skyellen/robwork-mirror/doc/gfx/overview-640.jpg

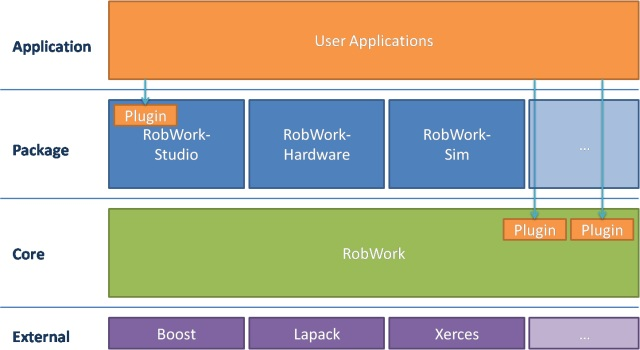
doc/gfx/overview-640.jpg
