skyellen/robwork-mirror/doc/installstuff/RW_package-msvc2005/setup.png

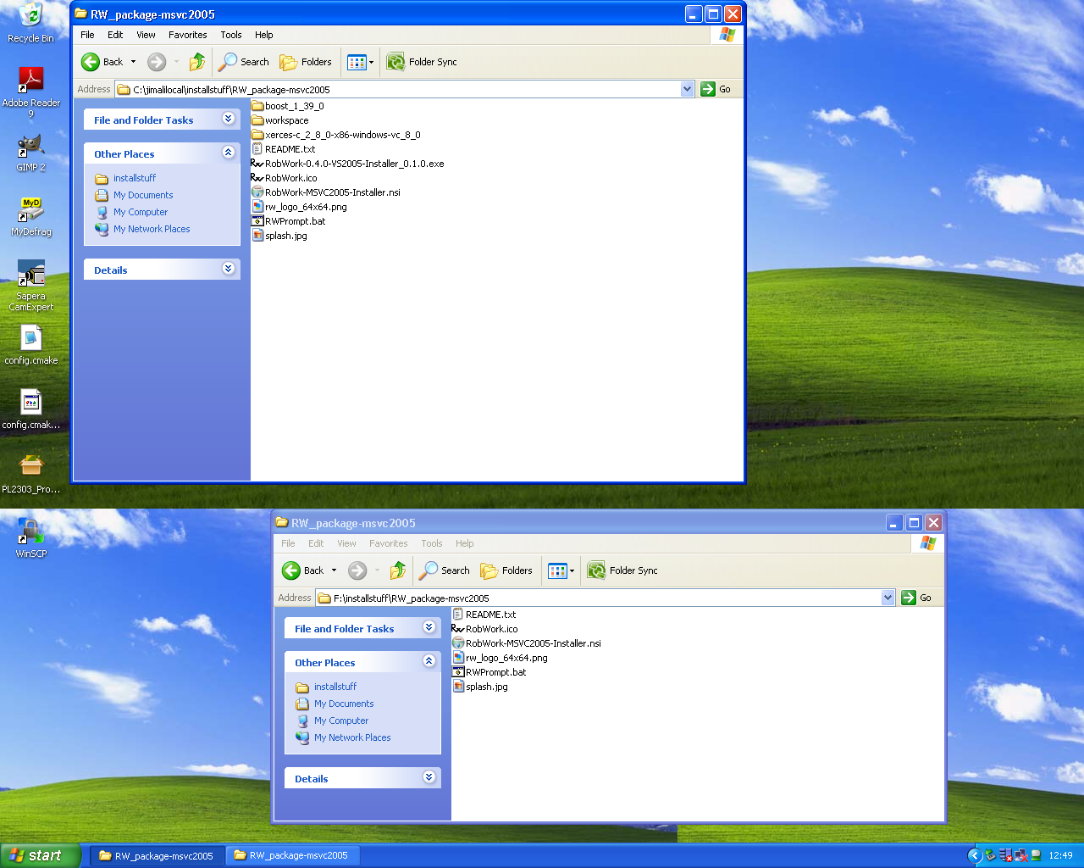
doc/installstuff/RW_package-msvc2005/setup.png
