skyellen/robwork-mirror/RobWorkSim/src/sandbox/grippers/readme.txt

Author: Adam Wolniakowski

Plugin for automatic gripper design and evaluation.
