skyellen/robwork-mirror/doc/gfx/geometric-primitives.png

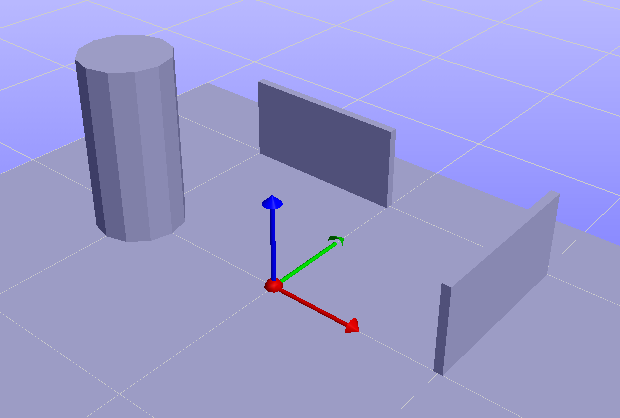
doc/gfx/geometric-primitives.png
