skyellen/robwork-mirror/doc/gfx/geometry/hypersphere.gif

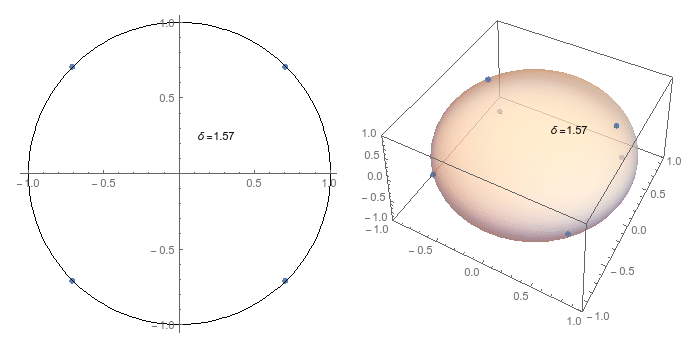
doc/gfx/geometry/hypersphere.gif
