skyellen/robwork-mirror/doc/gfx/geometry/quadrics_circular_cone.gif

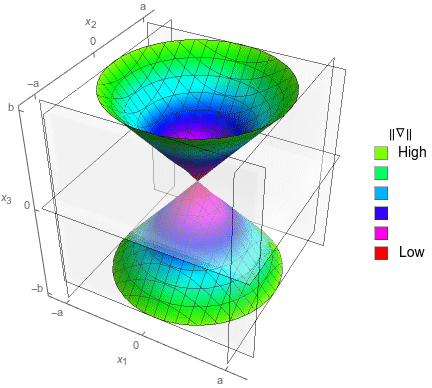
doc/gfx/geometry/quadrics_circular_cone.gif
