skyellen/robwork-mirror/doc/gfx/geometry/quadrics_circular_cylinder.gif

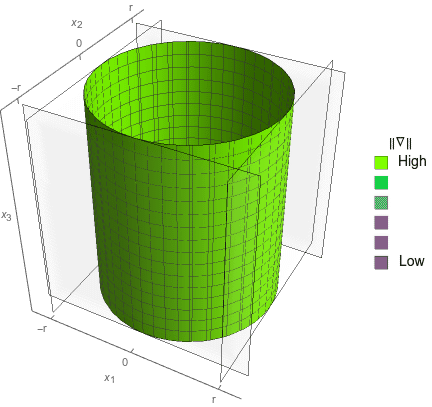
doc/gfx/geometry/quadrics_circular_cylinder.gif
