skyellen/robwork-mirror/doc/gfx/geometry/quadrics_circular_hyperboloid_onesheet.gif

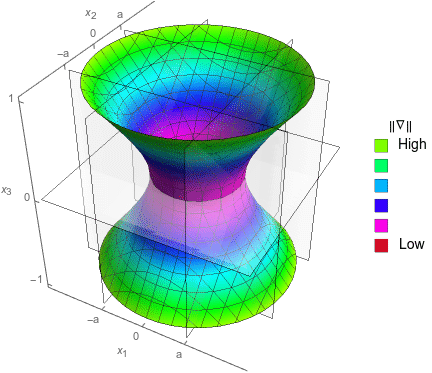
doc/gfx/geometry/quadrics_circular_hyperboloid_onesheet.gif
