skyellen/robwork-mirror/doc/gfx/geometry/quadrics_circular_hyperboloid_twosheets.gif

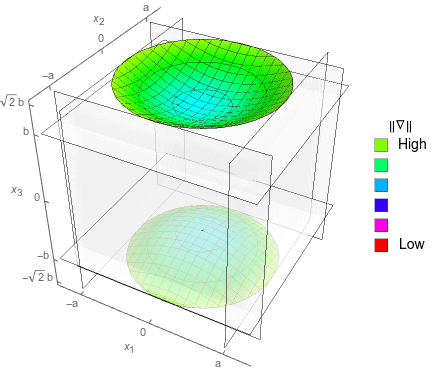
doc/gfx/geometry/quadrics_circular_hyperboloid_twosheets.gif
