skyellen/robwork-mirror/doc/gfx/geometry/quadrics_circular_paraboloid.gif

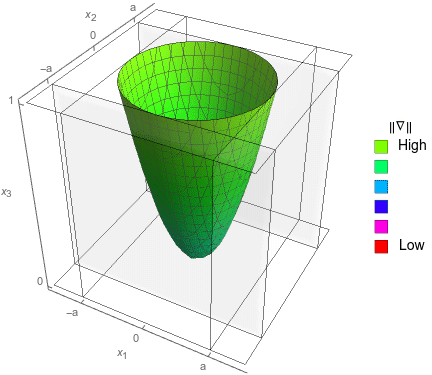
doc/gfx/geometry/quadrics_circular_paraboloid.gif
