skyellen/robwork-mirror/doc/gfx/geometry/quadrics_ellipsoid.gif

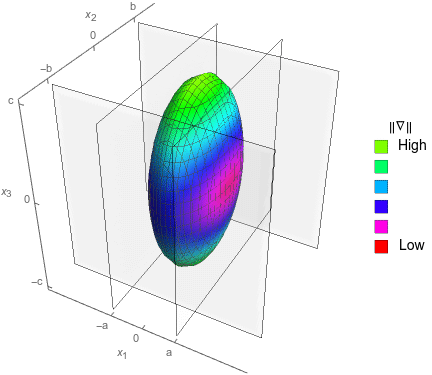
doc/gfx/geometry/quadrics_ellipsoid.gif
