skyellen/robwork-mirror/doc/gfx/geometry/quadrics_elliptic_cone.gif

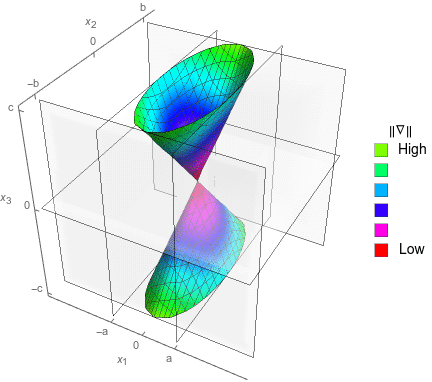
doc/gfx/geometry/quadrics_elliptic_cone.gif
