skyellen/robwork-mirror/doc/gfx/geometry/quadrics_elliptic_cylinder.gif

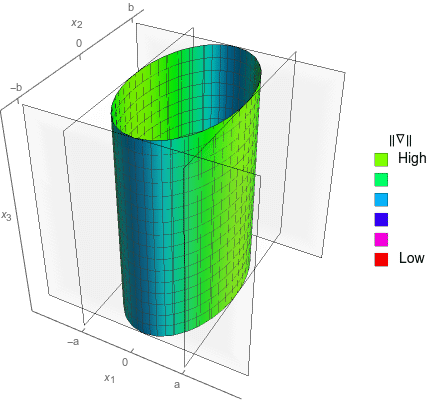
doc/gfx/geometry/quadrics_elliptic_cylinder.gif
