skyellen/robwork-mirror/doc/gfx/geometry/quadrics_elliptic_hyperboloid_onesheet.gif

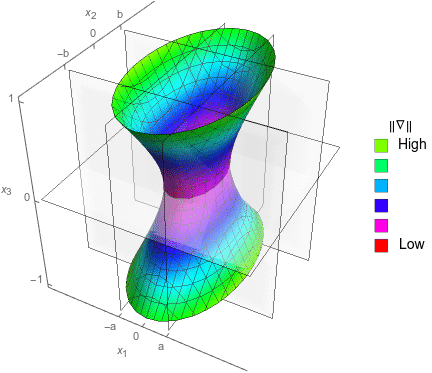
doc/gfx/geometry/quadrics_elliptic_hyperboloid_onesheet.gif
