skyellen/robwork-mirror/doc/gfx/geometry/quadrics_elliptic_hyperboloid_twosheets.gif

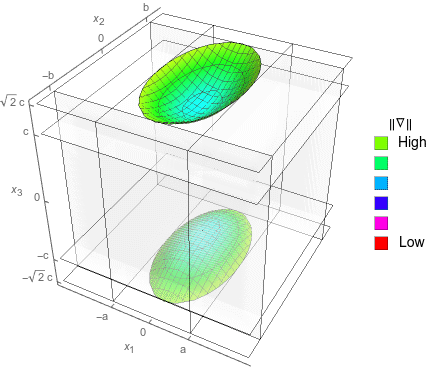
doc/gfx/geometry/quadrics_elliptic_hyperboloid_twosheets.gif
