skyellen/robwork-mirror/doc/gfx/geometry/quadrics_elliptic_paraboloid.gif

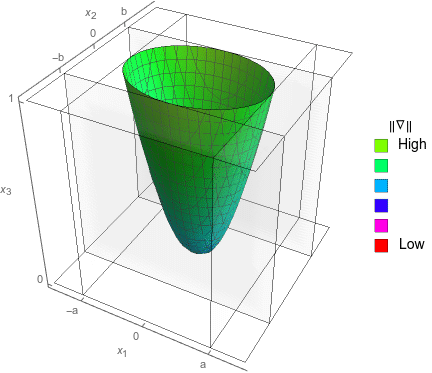
doc/gfx/geometry/quadrics_elliptic_paraboloid.gif
