skyellen/robwork-mirror/doc/gfx/geometry/quadrics_hyperbolic_cylinder.gif

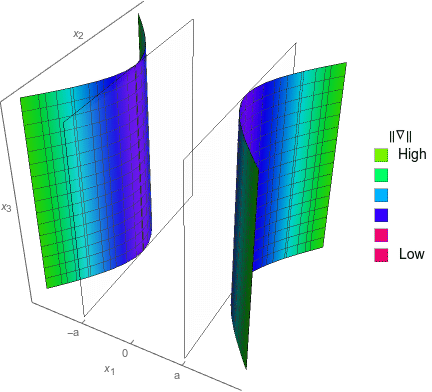
doc/gfx/geometry/quadrics_hyperbolic_cylinder.gif
