skyellen/robwork-mirror/doc/gfx/geometry/quadrics_hyperbolic_paraboloid.gif

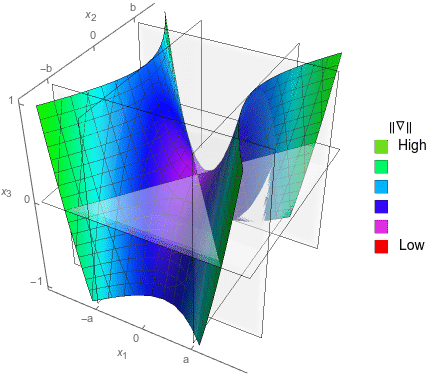
doc/gfx/geometry/quadrics_hyperbolic_paraboloid.gif
