skyellen/robwork-mirror/doc/gfx/geometry/quadrics_parabolic_cylinder.gif

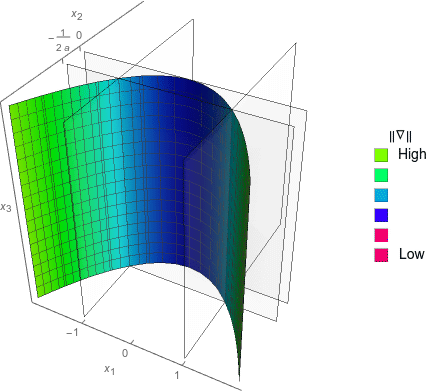
doc/gfx/geometry/quadrics_parabolic_cylinder.gif
