skyellen/robwork-mirror/doc/gfx/geometry/quadrics_sphere.gif

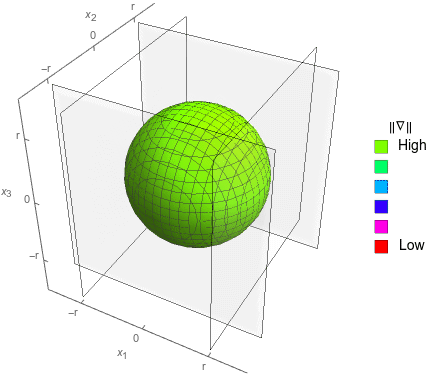
doc/gfx/geometry/quadrics_sphere.gif
