skyellen/robwork-mirror/doc/gfx/geometry/quadrics_spheroid.gif

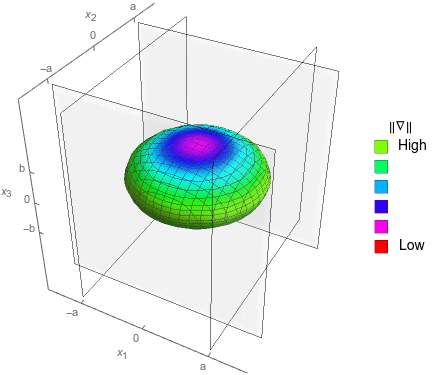
doc/gfx/geometry/quadrics_spheroid.gif
