skyellen/robwork-mirror/doc/gfx/sline.png

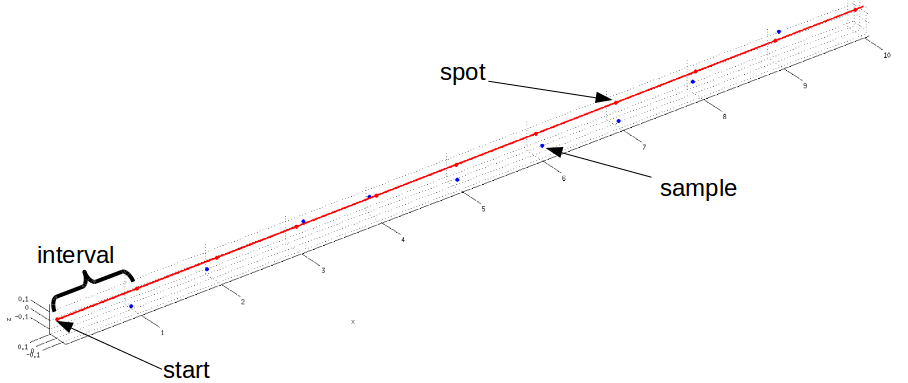
doc/gfx/sline.png
