skyellen/robwork-mirror/doc/gfx/workcell.png

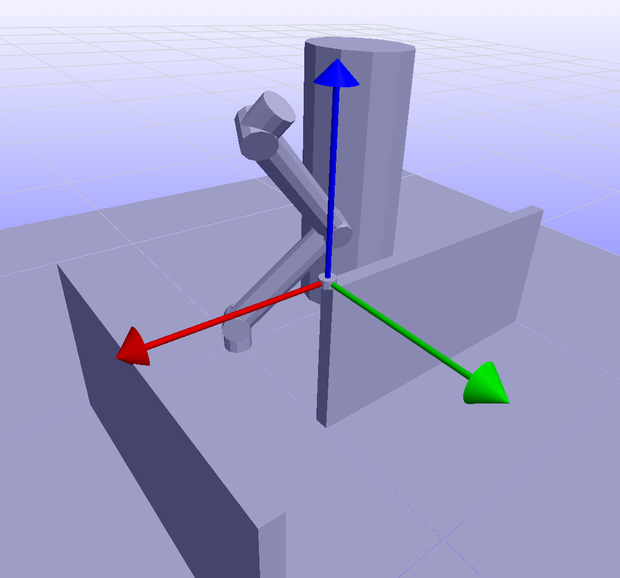
doc/gfx/workcell.png
