skyellen/robwork-mirror/RobWorkStudio/src/rwslibs/planning/planning.png

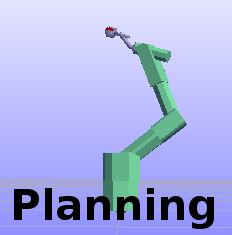
RobWorkStudio/src/rwslibs/planning/planning.png
