skyellen/robwork-mirror/RobWorkStudio/src/rwslibs/sensors/sensors.png

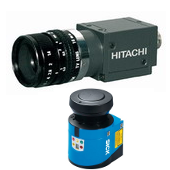
RobWorkStudio/src/rwslibs/sensors/sensors.png
