skyellen/robwork-mirror/doc/gfx/installation/Qt5_components.png

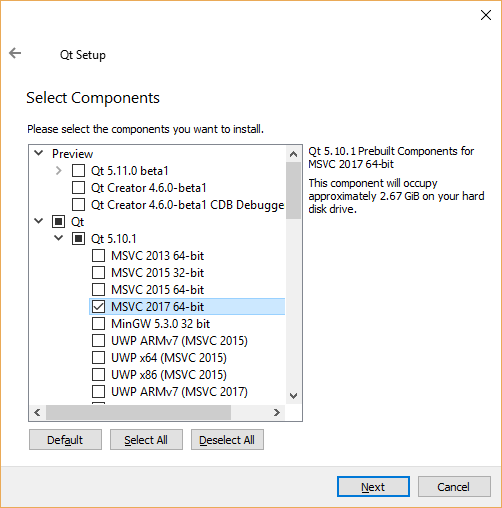
doc/gfx/installation/Qt5_components.png
