skyellen/robwork-mirror/RobWork/test/testfiles/devices/Robotiq-2-finger-85/geometry/outer_link.stl

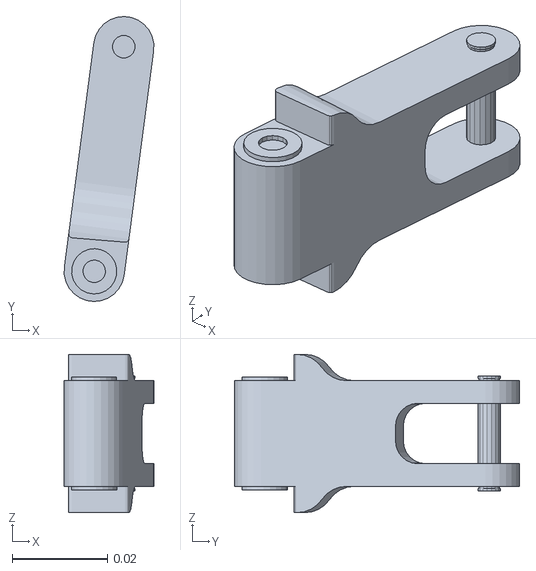
[picture p26: CAD file, 2017-12-04]
RobWork/test/testfiles/devices/Robotiq-2-finger-85/geometry/outer_link.stl
0.0188 x 0.0599 x 0.0333
