skyellen/robwork-mirror/RobWork/test/testfiles/devices/UR6855A/geometry/joint0.stl

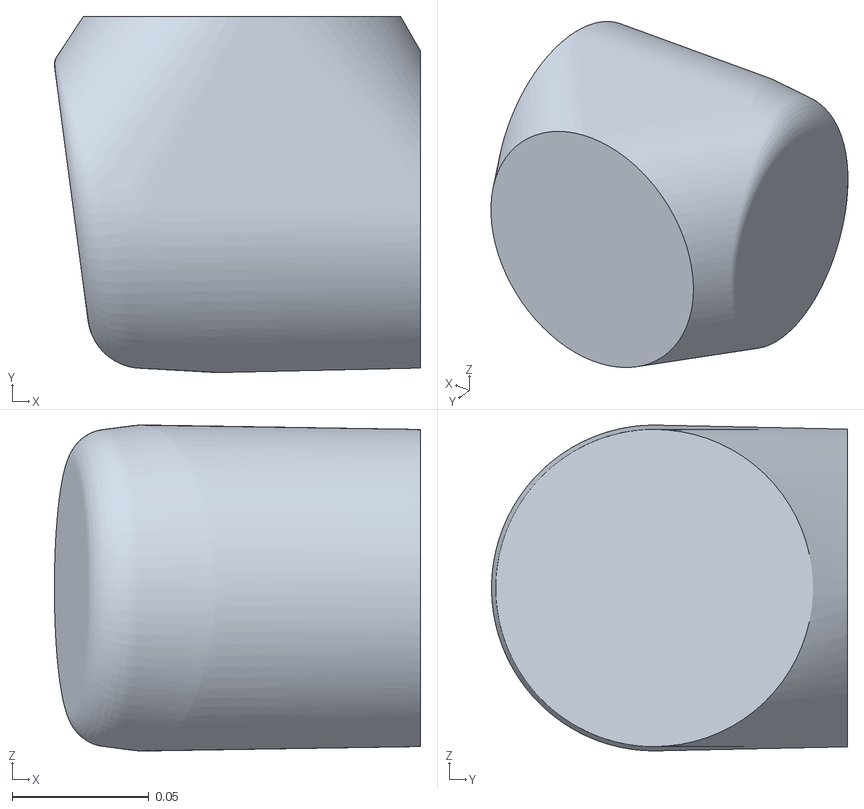
[picture p27: CAD file, 2013-05-24]
RobWork/test/testfiles/devices/UR6855A/geometry/joint0.stl
0.134 x 0.13 x 0.119
