skyellen/robwork-mirror/RobWork/test/testfiles/geoms/performance/CoarseModel.stl

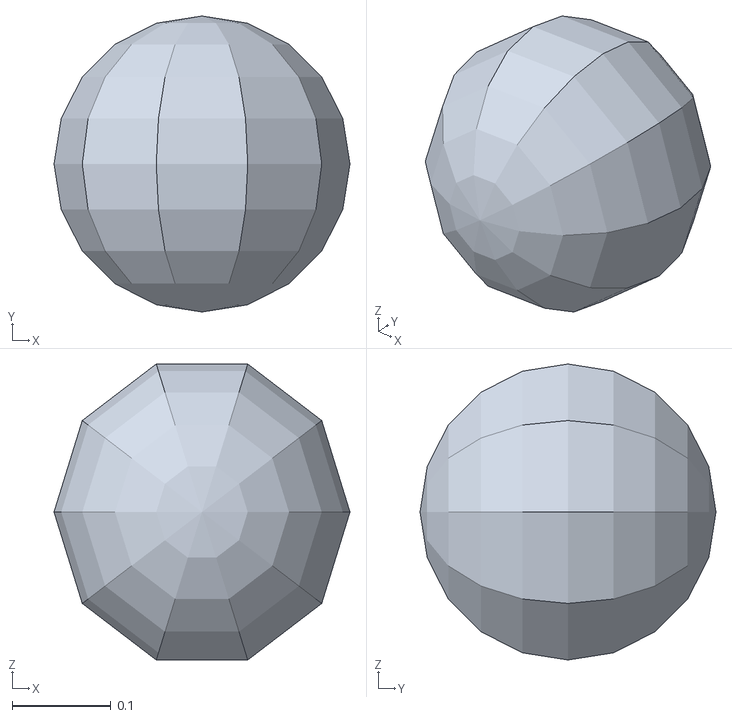
[picture p28: CAD file, 2011-01-19]
RobWork/test/testfiles/geoms/performance/CoarseModel.stl
0.3 x 0.3 x 0.3
