skyellen/robwork-mirror/RobWork/test/testfiles/geoms/table.stl

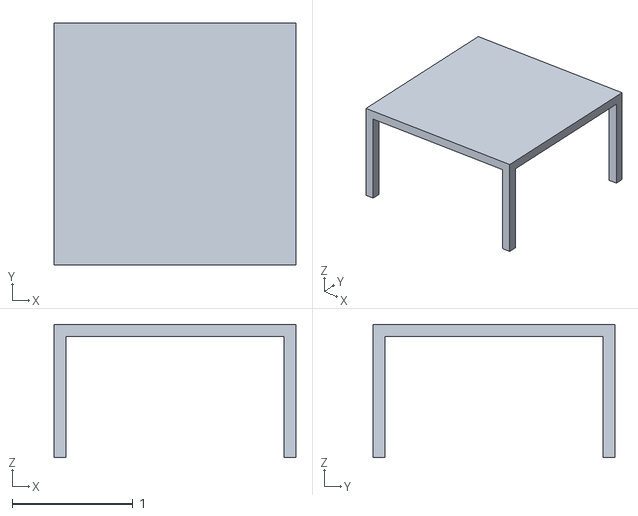
[picture p29: CAD file, 2014-12-04]
RobWork/test/testfiles/geoms/table.stl
2.00 x 2.00 x 1.10
