skyellen/robwork-mirror/RobWork/test/testfiles/SchunkHand/Geometry/FingerTip_chull.stl

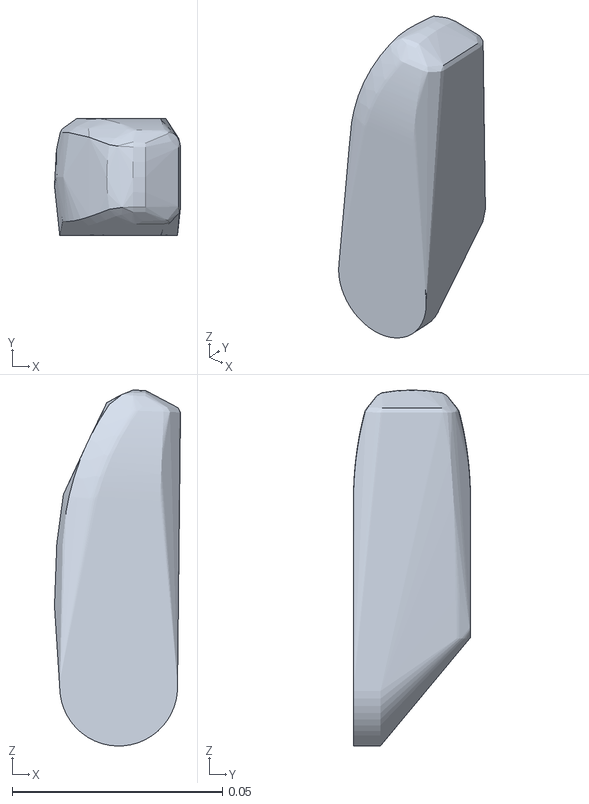
[picture p30: CAD file, 2012-03-18]
RobWork/test/testfiles/SchunkHand/Geometry/FingerTip_chull.stl
0.03 x 0.0278 x 0.0846
