skyellen/robwork-mirror/RobWork/test/testfiles/workcells/simple_wc/PA10/Geometry/Rob-2.stl

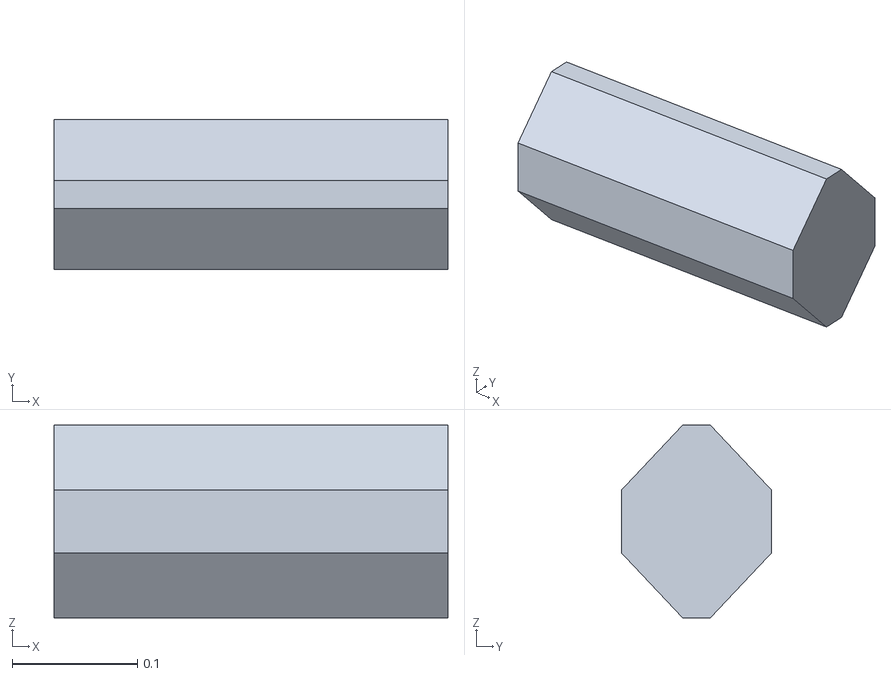
[picture p31: CAD file, 2009-11-05]
RobWork/test/testfiles/workcells/simple_wc/PA10/Geometry/Rob-2.stl
0.315 x 0.12 x 0.154
