skyellen/robwork-mirror/RobWorkHardware/example/ur/MARVIN/cameras/BumbleBee2.stl

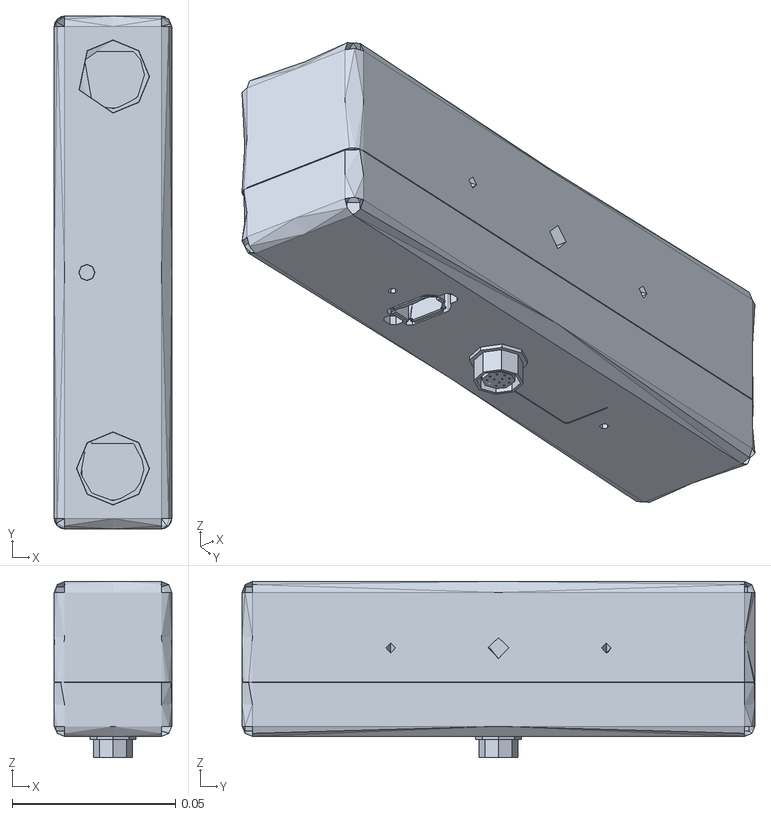
[picture p32: CAD file, 2013-10-11]
RobWorkHardware/example/ur/MARVIN/cameras/BumbleBee2.stl
0.036 x 0.157 x 0.0539
