skyellen/robwork-mirror/RobWorkHardware/example/ur/MARVIN/geometry/stand.stl

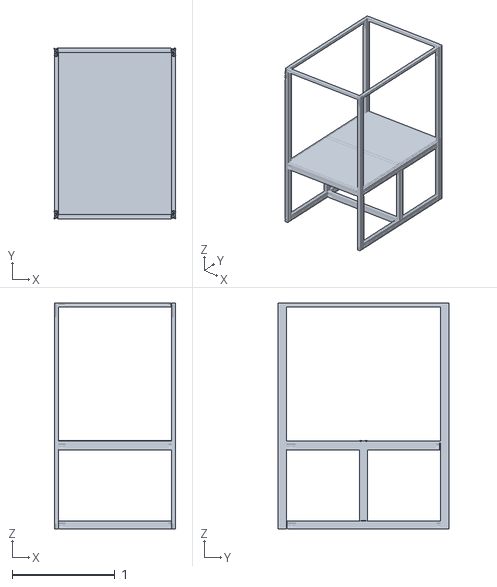
[picture p33: CAD file, 2013-10-11]
RobWorkHardware/example/ur/MARVIN/geometry/stand.stl
1.18 x 1.66 x 2.20
