skyellen/robwork-mirror/RobWorkHardware/example/ur/MARVIN/robots/geometry/rob_6c.stl

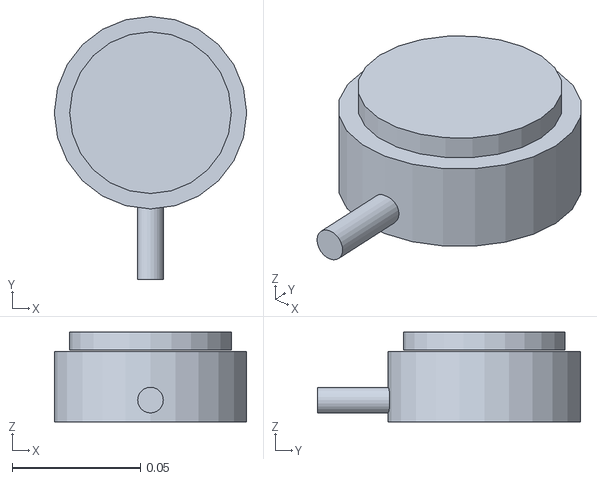
[picture p34: CAD file, 2013-10-11]
RobWorkHardware/example/ur/MARVIN/robots/geometry/rob_6c.stl
0.075 x 0.103 x 0.035
