skyellen/robwork-mirror/RobWorkHardware/src/sandbox/falcon/ur_control_test_scene/cup/GreenCup_800_tex.stl

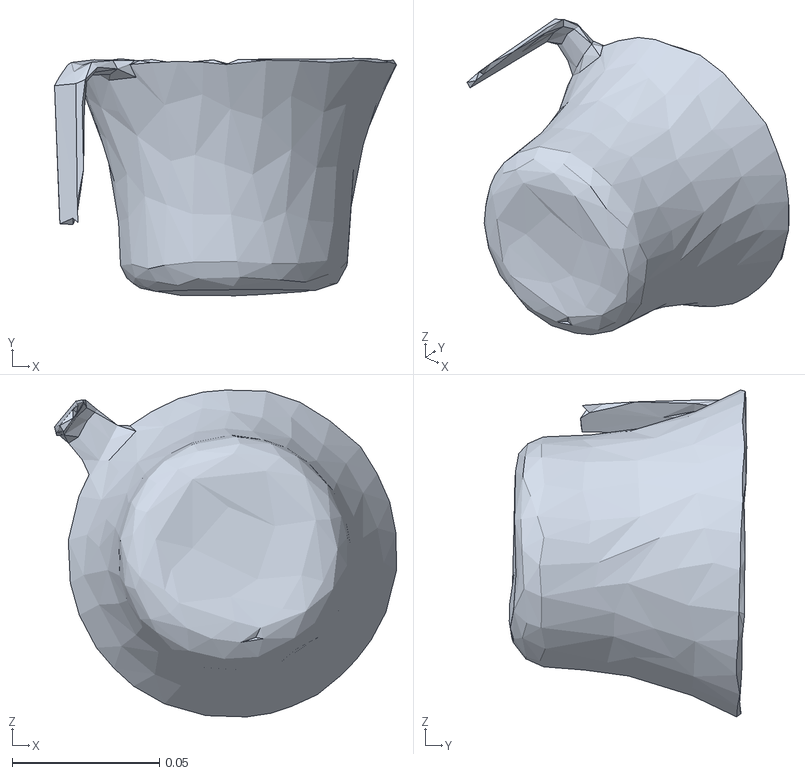
[picture p35: CAD file, 2013-04-03]
RobWorkHardware/src/sandbox/falcon/ur_control_test_scene/cup/GreenCup_800_tex.stl
0.116 x 0.0807 x 0.111
