skyellen/robwork-mirror/RobWorkHardware/src/sandbox/falcon/ur_control_test_scene/geometry/jaw4u.stl

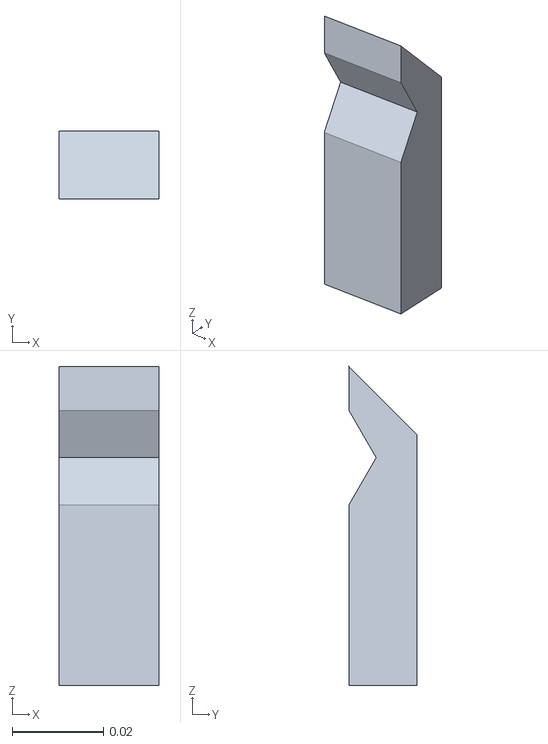
[picture p36: CAD file, 2013-11-15]
RobWorkHardware/src/sandbox/falcon/ur_control_test_scene/geometry/jaw4u.stl
0.022 x 0.015 x 0.07
