skyellen/robwork-mirror/RobWorkSim/src/sandbox/grippers/setups/belt_box/gripper/geometry/right_placeholder.stl

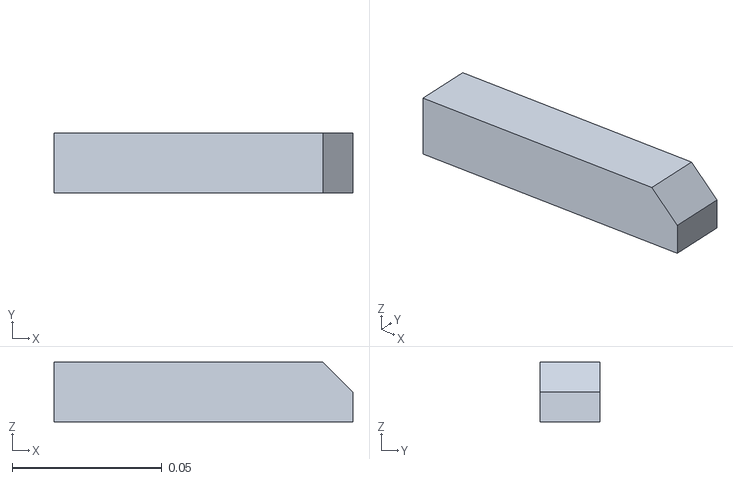
[picture p37: CAD file, 2013-11-19]
RobWorkSim/src/sandbox/grippers/setups/belt_box/gripper/geometry/right_placeholder.stl
0.1 x 0.02 x 0.02
