skyellen/robwork-mirror/RobWorkSim/src/sandbox/grippers/setups/belt_dolt/tthing.stl

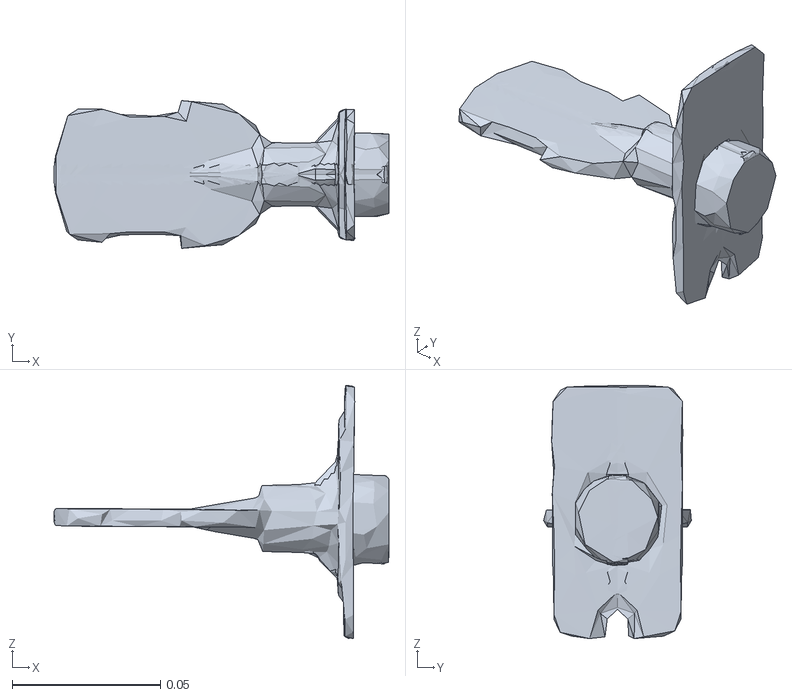
[picture p38: CAD file, 2013-11-19]
RobWorkSim/src/sandbox/grippers/setups/belt_dolt/tthing.stl
0.113 x 0.0498 x 0.0853
