skyellen/robwork-mirror/RobWorkSim/src/sandbox/grippers/setups/belt_pump/pump_simple.stl

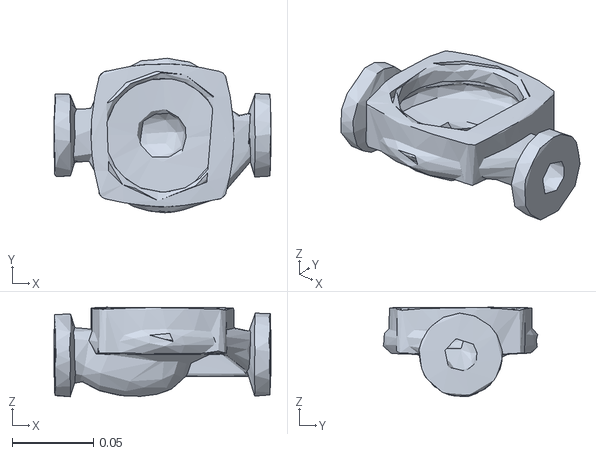
[picture p39: CAD file, 2013-11-19]
RobWorkSim/src/sandbox/grippers/setups/belt_pump/pump_simple.stl
0.134 x 0.0951 x 0.0551
