skyellen/robwork-mirror/RobWorkSim/test/testfiles/devices/nowy/obudowa.stl

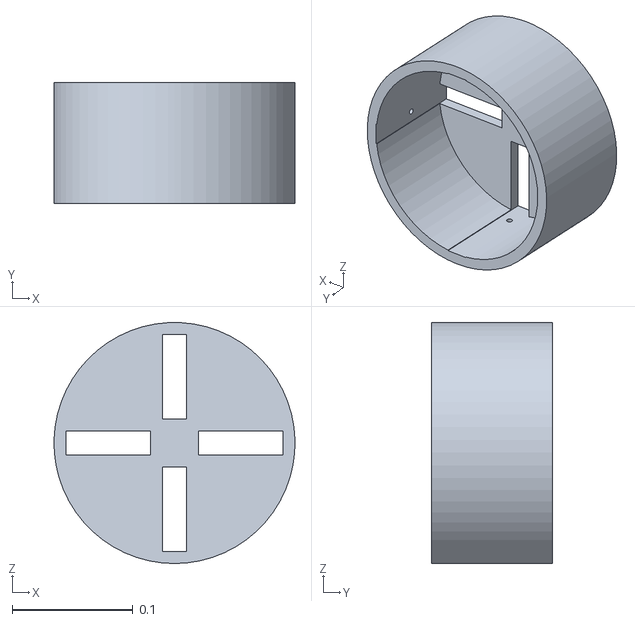
[picture p40: CAD file, 2013-04-19]
RobWorkSim/test/testfiles/devices/nowy/obudowa.stl
0.2 x 0.1 x 0.2
