skyellen/robwork-mirror/RobWorkSim/test/testfiles/devices/PG70/geometry/basejaw.stl

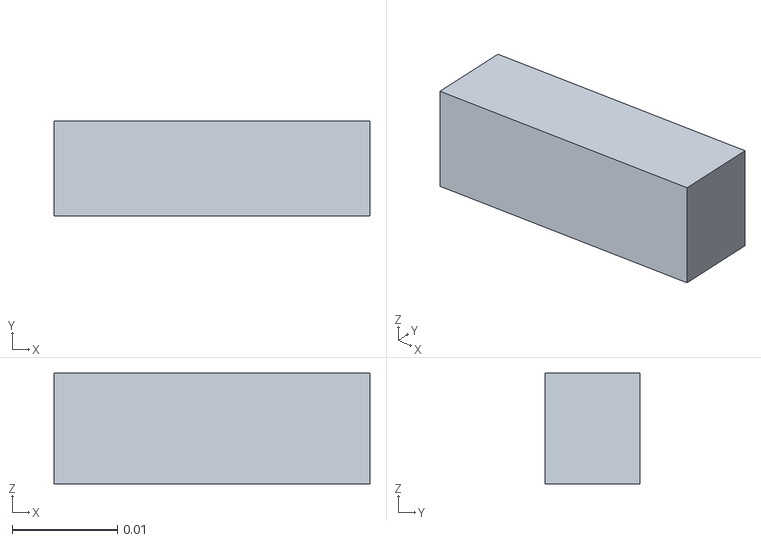
[picture p41: CAD file, 2010-06-25]
RobWorkSim/test/testfiles/devices/PG70/geometry/basejaw.stl
0.03 x 0.009 x 0.0105
