skyellen/robwork-mirror/RobWorkSim/test/testfiles/devices/SDH2/geometry/FingerBase2_hull.stl

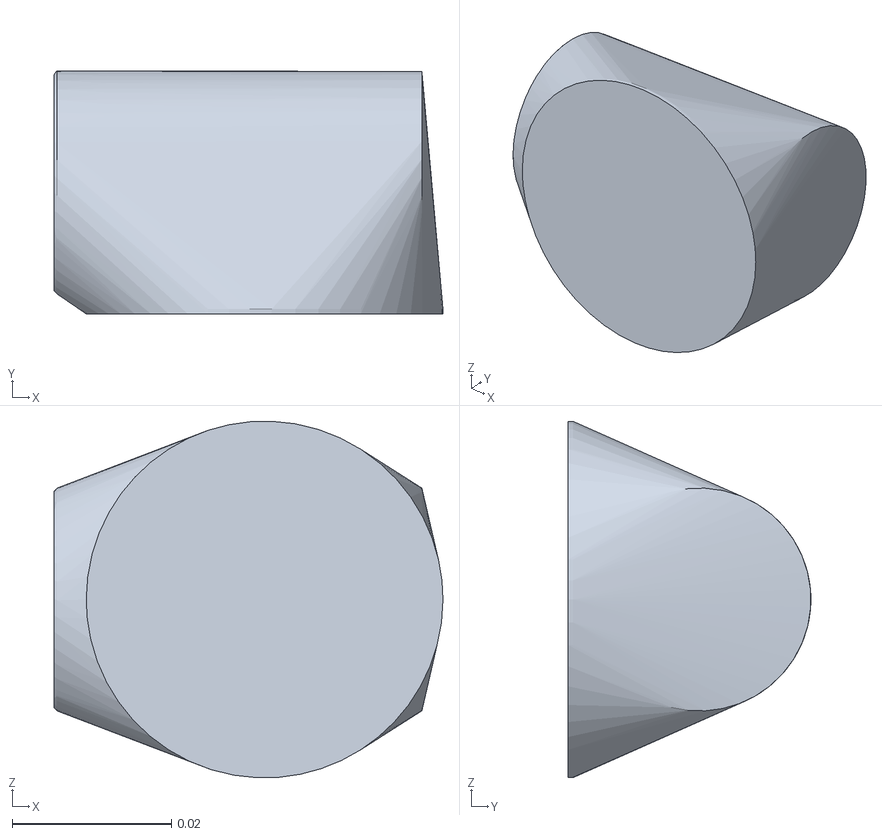
[picture p42: CAD file, 2012-02-03]
RobWorkSim/test/testfiles/devices/SDH2/geometry/FingerBase2_hull.stl
0.0488 x 0.0305 x 0.0448
