skyellen/robwork-mirror/RobWorkSim/test/testfiles/objects/BlueSupport.stl

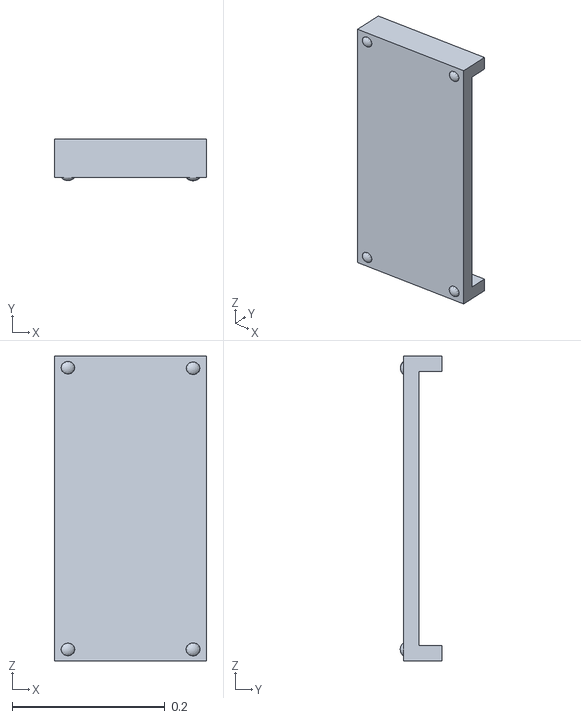
[picture p43: CAD file, 2013-11-01]
RobWorkSim/test/testfiles/objects/BlueSupport.stl
0.2 x 0.0547 x 0.4
