skyellen/robwork-mirror/RobWorkSim/test/testfiles/scene/Circular_Compliance/geometry/Hole.stp

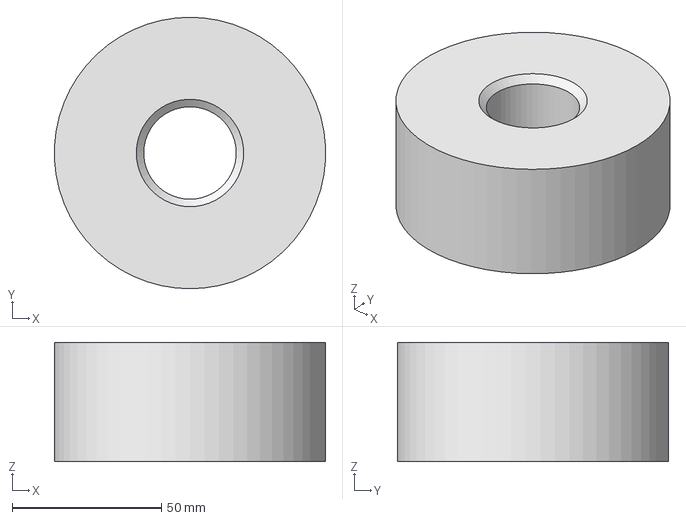
[picture p44: CAD file, 2016-06-06]
RobWorkSim/test/testfiles/scene/Circular_Compliance/geometry/Hole.stp
90.9 x 91.0 x 40.0 mm
