skyellen/robwork-mirror/RobWork/test/testfiles/devices/Robotiq-2-finger-85/geometry/finger_wo_cap.stl

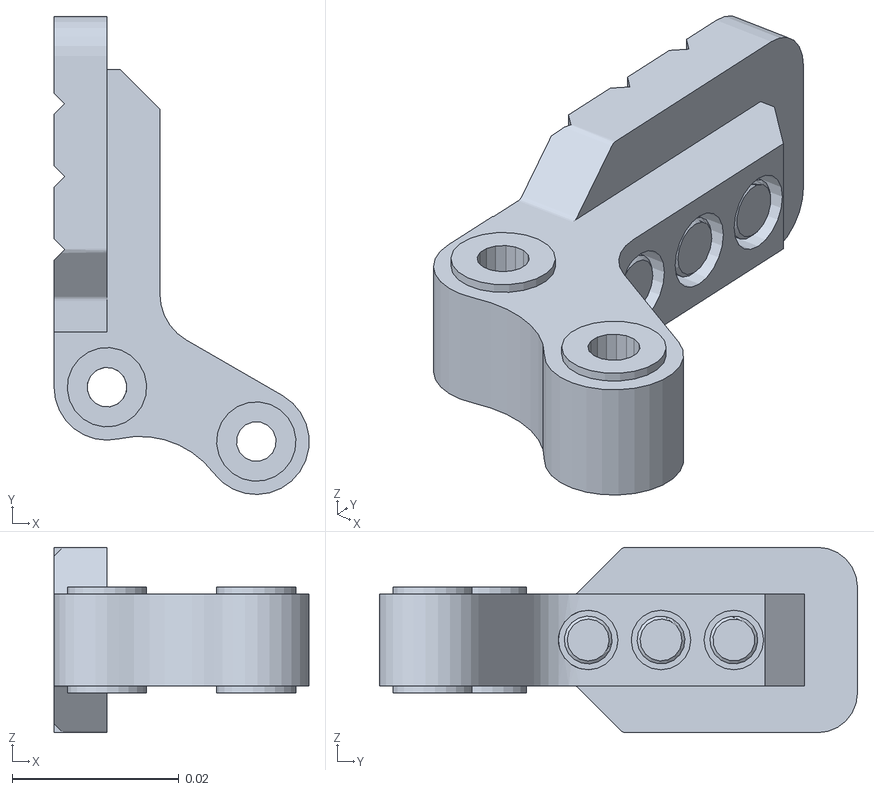
[picture p45: CAD file, 2017-12-04]
RobWork/test/testfiles/devices/Robotiq-2-finger-85/geometry/finger_wo_cap.stl
0.0306 x 0.0573 x 0.0222
