skyellen/robwork-mirror/RobWork/test/testfiles/devices/UR6855A/geometry/joint3.stl

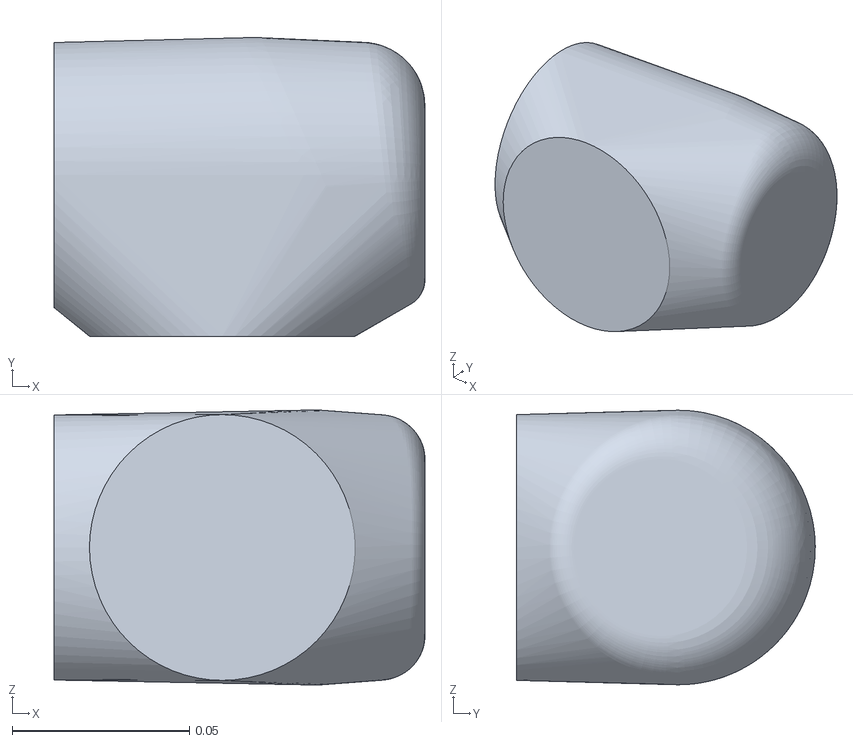
[picture p46: CAD file, 2013-05-24]
RobWork/test/testfiles/devices/UR6855A/geometry/joint3.stl
0.105 x 0.0843 x 0.0775
