skyellen/robwork-mirror/RobWork/test/testfiles/SchunkHand/Geometry/Base_chull.stl

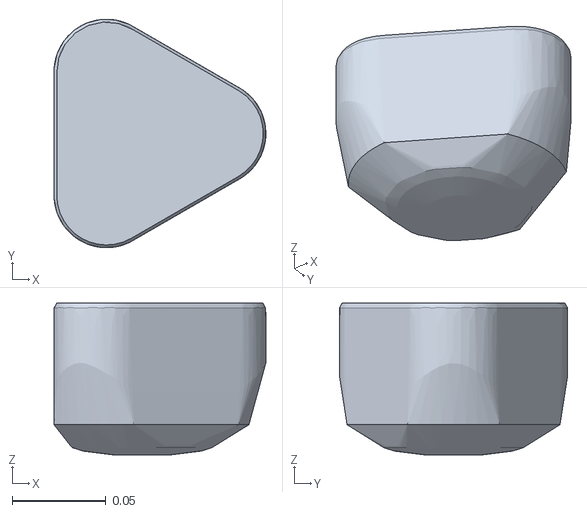
[picture p47: CAD file, 2012-03-18]
RobWork/test/testfiles/SchunkHand/Geometry/Base_chull.stl
0.113 x 0.122 x 0.081
