skyellen/robwork-mirror/RobWork/test/testfiles/workcells/simple_wc/PA10/Geometry/Rob-1.stl

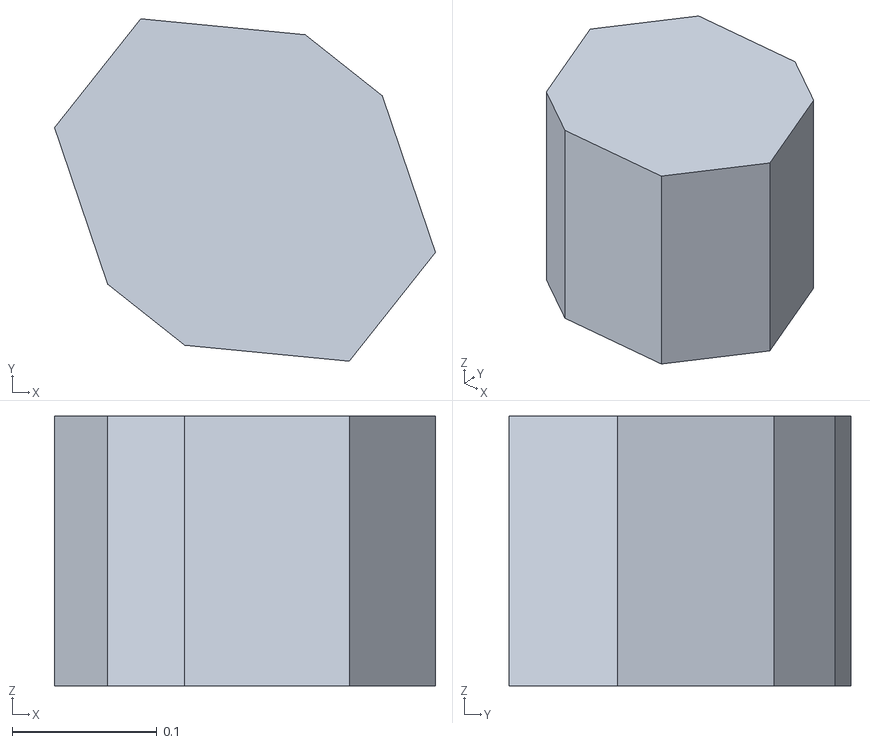
[picture p48: CAD file, 2009-11-05]
RobWork/test/testfiles/workcells/simple_wc/PA10/Geometry/Rob-1.stl
0.263 x 0.237 x 0.186
