skyellen/robwork-mirror/RobWorkHardware/example/ur/MARVIN/geometry/marvinsponge.stl

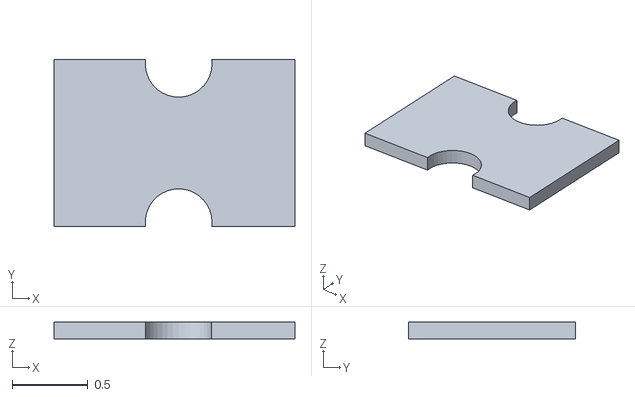
[picture p49: CAD file, 2013-10-11]
RobWorkHardware/example/ur/MARVIN/geometry/marvinsponge.stl
1.59 x 1.10 x 0.11
