skyellen/robwork-mirror/RobWorkHardware/example/ur/MARVIN/robots/geometry/rob_4c.stl

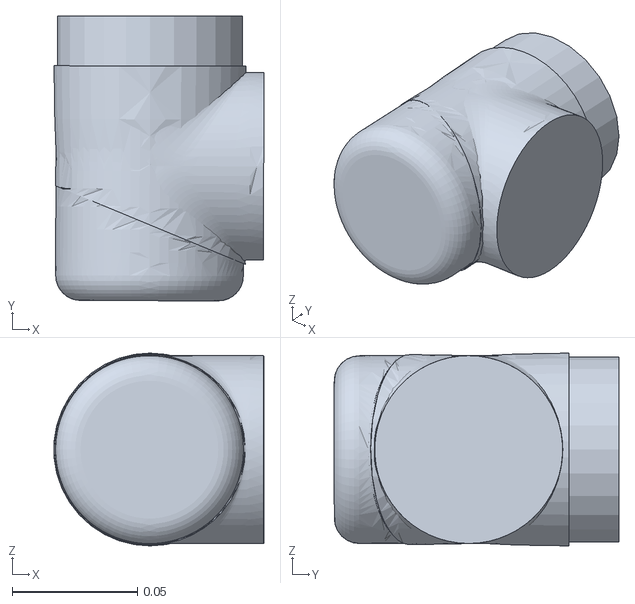
[picture p50: CAD file, 2013-10-11]
RobWorkHardware/example/ur/MARVIN/robots/geometry/rob_4c.stl
0.0839 x 0.114 x 0.077
