skyellen/robwork-mirror/RobWorkSim/test/testfiles/devices/nowy/p1.stl

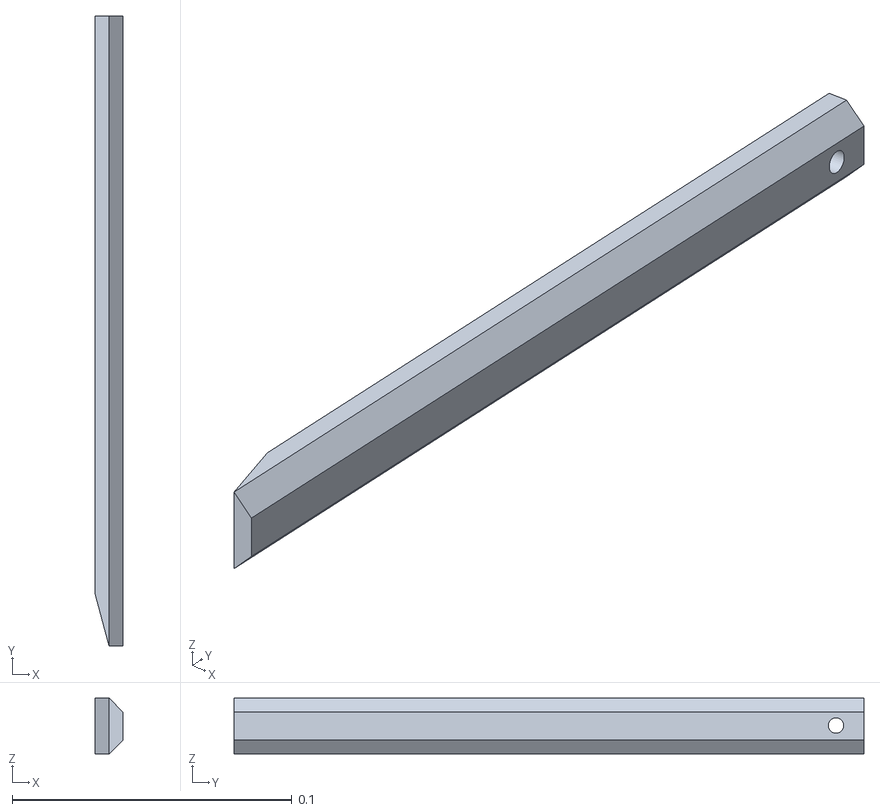
[picture p51: CAD file, 2013-04-19]
RobWorkSim/test/testfiles/devices/nowy/p1.stl
0.01 x 0.225 x 0.02
