skyellen/robwork-mirror/RobWorkSim/test/testfiles/devices/PG70/geometry/cube.stl

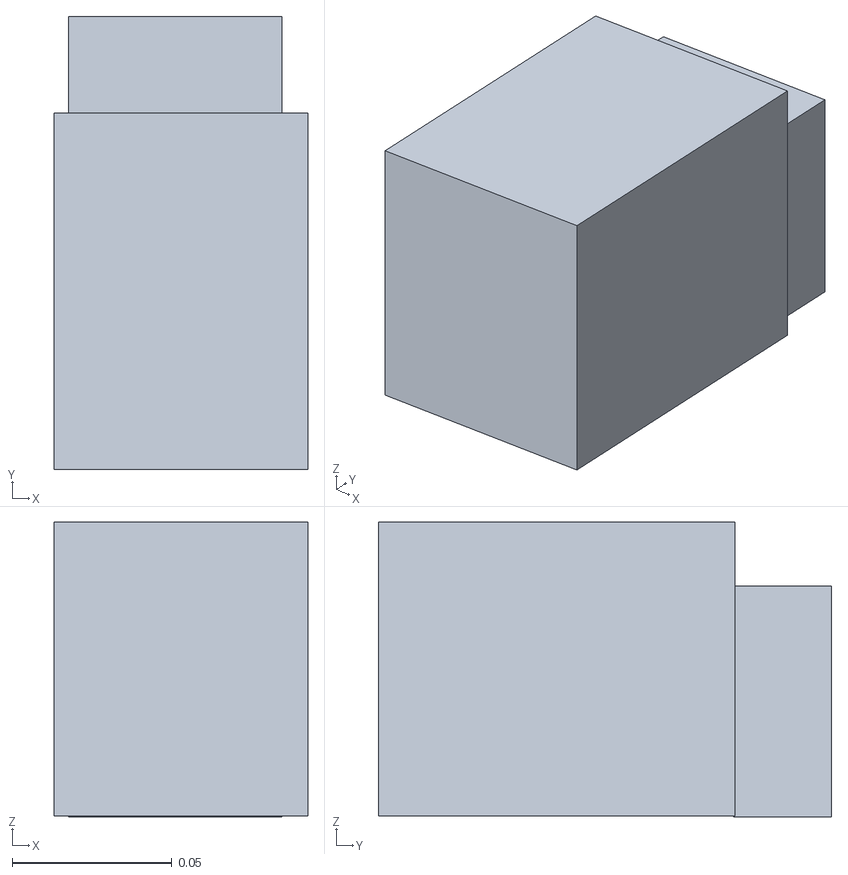
[picture p52: CAD file, 2010-06-25]
RobWorkSim/test/testfiles/devices/PG70/geometry/cube.stl
0.0794 x 0.142 x 0.0923
