skyellen/robwork-mirror/RobWorkSim/test/testfiles/objects/peg299.stl

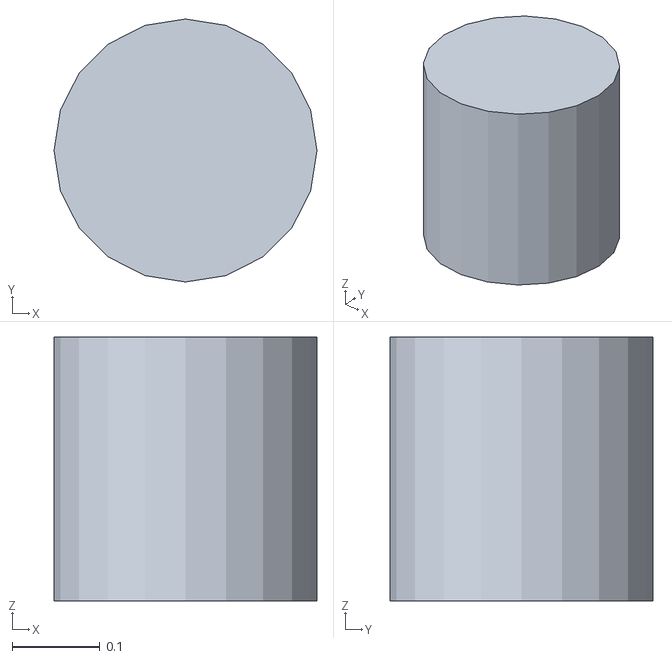
[picture p53: CAD file, 2013-01-26]
RobWorkSim/test/testfiles/objects/peg299.stl
0.299 x 0.299 x 0.3
