skyellen/robwork-mirror/RobWorkSim/test/testfiles/scene/Circular_Compliance/geometry/Circular_Ø32_tool.stp

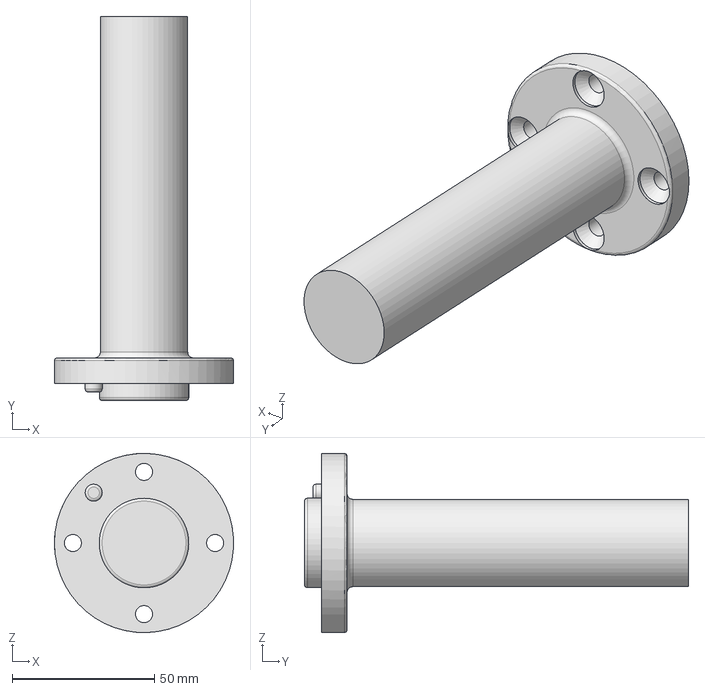
[picture p54: CAD file, 2016-06-06]
RobWorkSim/test/testfiles/scene/Circular_Compliance/geometry/Circular_Ø32_tool.stp
63.0 x 135.0 x 63.0 mm
