skyellen/robwork-mirror/RobWork/test/testfiles/devices/Robotiq-2-finger-85/geometry/motor_arm.stl

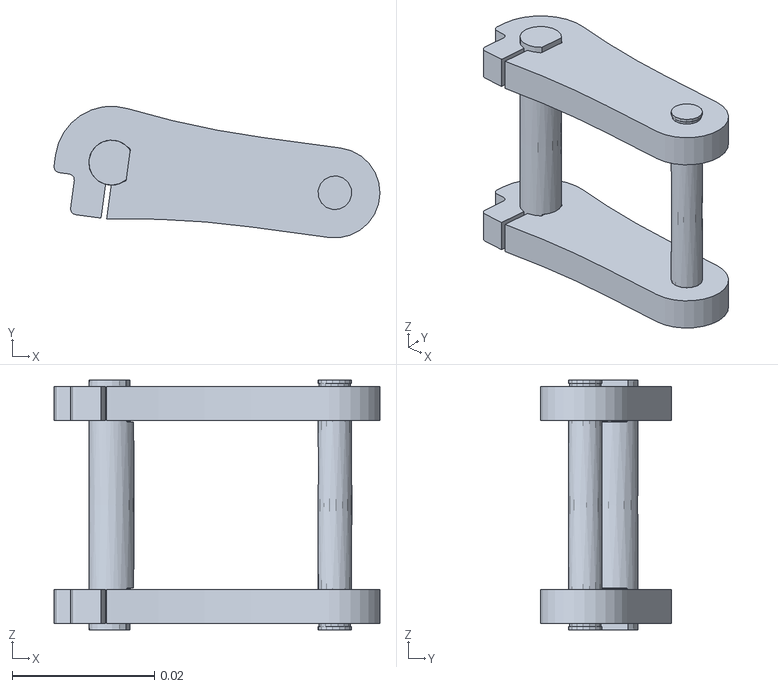
[picture p55: CAD file, 2017-12-04]
RobWork/test/testfiles/devices/Robotiq-2-finger-85/geometry/motor_arm.stl
0.0459 x 0.0185 x 0.0352
