skyellen/robwork-mirror/RobWork/test/testfiles/devices/UR6855A/geometry/joint1.stl

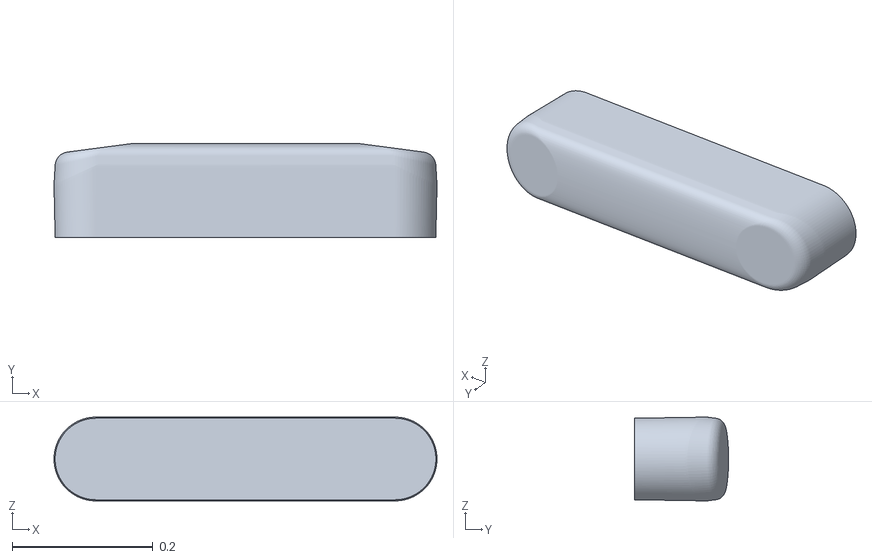
[picture p56: CAD file, 2013-05-24]
RobWork/test/testfiles/devices/UR6855A/geometry/joint1.stl
0.544 x 0.134 x 0.119
