skyellen/robwork-mirror/RobWork/test/testfiles/geoms/OrangeMarmelade_800_tex.obj

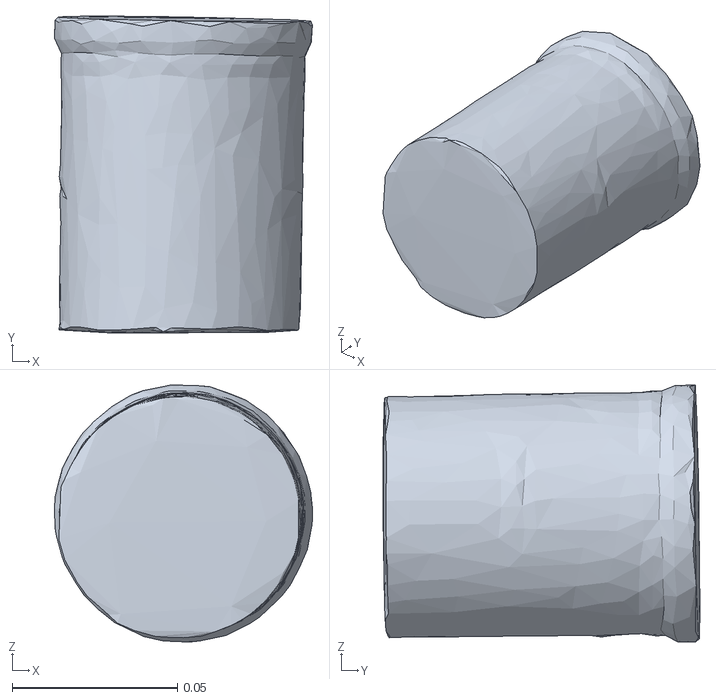
[picture p57: CAD file, 2014-04-23]
RobWork/test/testfiles/geoms/OrangeMarmelade_800_tex.obj
0.0781 x 0.0959 x 0.0778
