skyellen/robwork-mirror/RobWork/test/testfiles/SchunkHand/Geometry/FingerBase_chull.stl

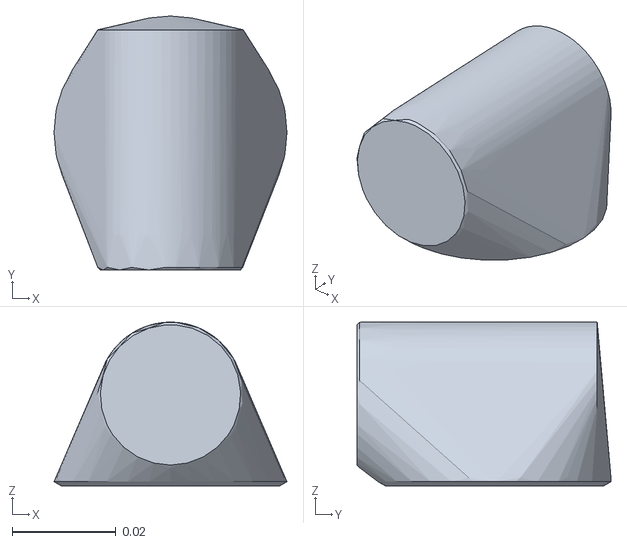
[picture p58: CAD file, 2012-03-18]
RobWork/test/testfiles/SchunkHand/Geometry/FingerBase_chull.stl
0.0448 x 0.0489 x 0.0315
