skyellen/robwork-mirror/RobWork/test/testfiles/workcells/simple_wc/PA10/Geometry/Rob-4.stl

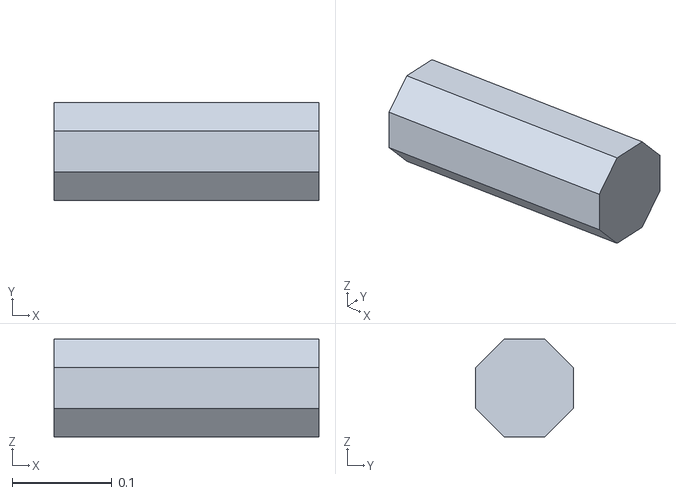
[picture p59: CAD file, 2009-11-05]
RobWork/test/testfiles/workcells/simple_wc/PA10/Geometry/Rob-4.stl
0.265 x 0.098 x 0.098
