skyellen/robwork-mirror/RobWorkHardware/example/ur/MARVIN/robots/geometry/rob_3c.stl

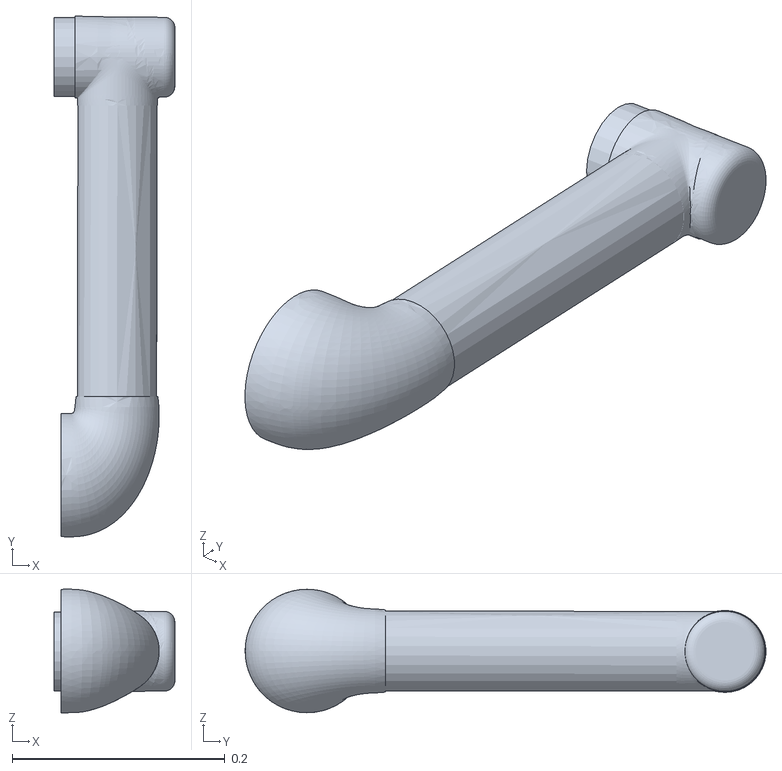
[picture p60: CAD file, 2013-10-11]
RobWorkHardware/example/ur/MARVIN/robots/geometry/rob_3c.stl
0.114 x 0.489 x 0.116
