skyellen/robwork-mirror/RobWorkHardware/src/sandbox/falcon/ur_control_test_scene/geometry/plane_5x5.stl

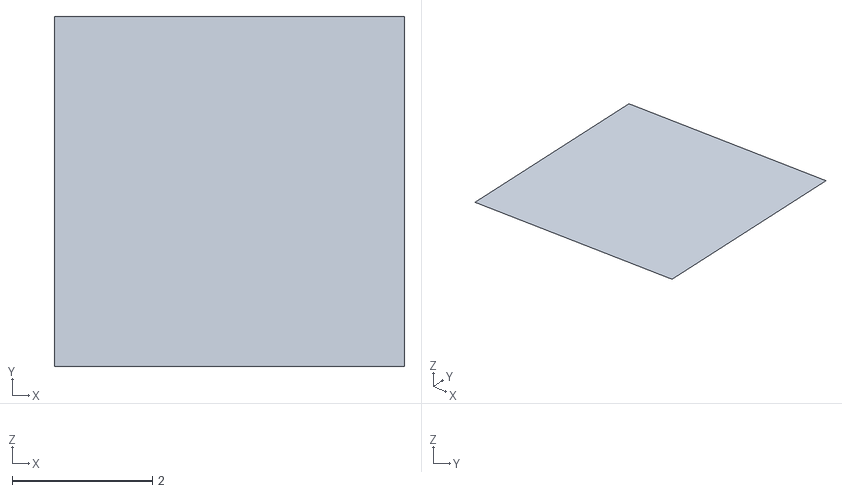
[picture p61: CAD file, 2011-02-17]
RobWorkHardware/src/sandbox/falcon/ur_control_test_scene/geometry/plane_5x5.stl
5.00 x 5.00 x 0
