skyellen/robwork-mirror/RobWorkSim/test/testfiles/devices/SDH2/geometry/FingerMid_hull.stl

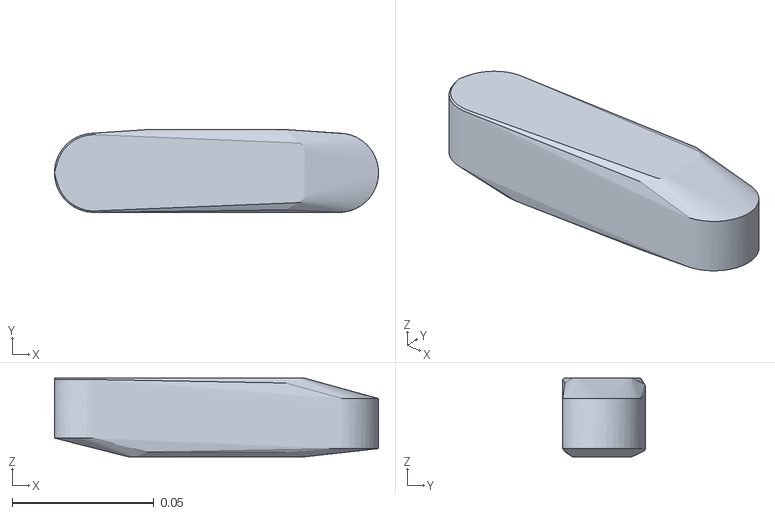
[picture p62: CAD file, 2012-02-03]
RobWorkSim/test/testfiles/devices/SDH2/geometry/FingerMid_hull.stl
0.114 x 0.0293 x 0.0278
