skyellen/robwork-mirror/RobWorkSim/test/testfiles/objects/platform.stl

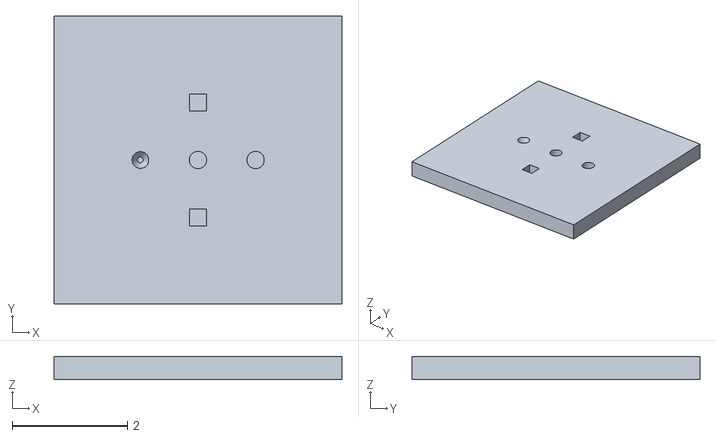
[picture p63: CAD file, 2013-01-26]
RobWorkSim/test/testfiles/objects/platform.stl
5.00 x 5.00 x 0.4
