skyellen/robwork-mirror/RobWorkSim/test/testfiles/scene/Circular_Compliance/geometry/Hole_Ø31.stl

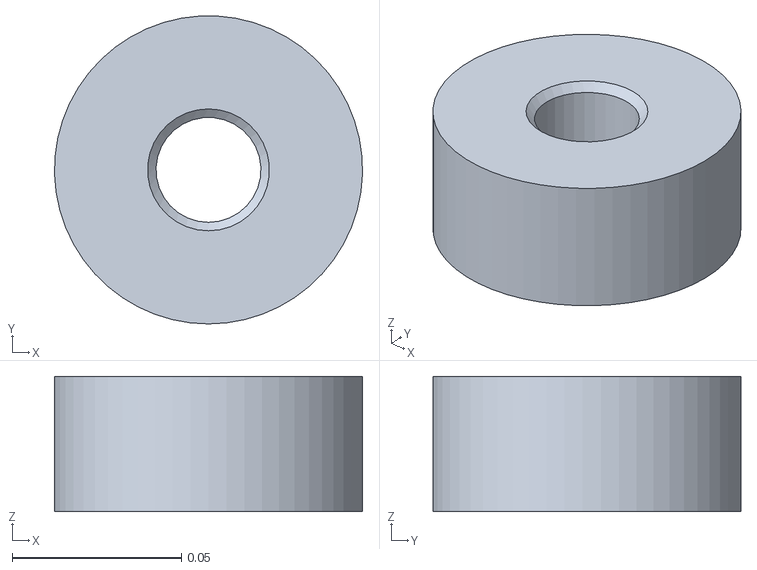
[picture p64: CAD file, 2016-06-06]
RobWorkSim/test/testfiles/scene/Circular_Compliance/geometry/Hole_Ø31.stl
0.091 x 0.0909 x 0.04
