skyellen/robwork-mirror/RobWork/test/testfiles/devices/Robotiq-2-finger-85/geometry/inner_link.stl

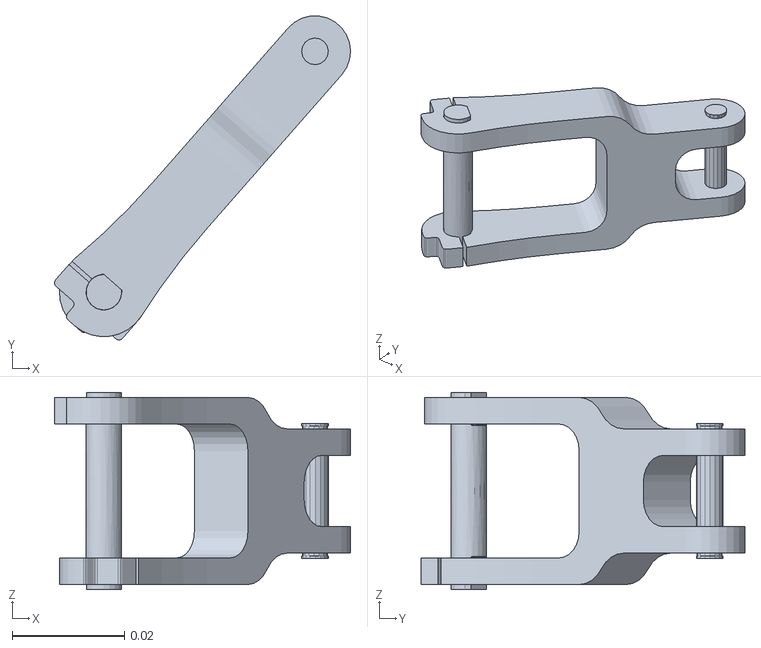
[picture p65: CAD file, 2017-12-04]
RobWork/test/testfiles/devices/Robotiq-2-finger-85/geometry/inner_link.stl
0.0528 x 0.0578 x 0.0352
