skyellen/robwork-mirror/RobWork/test/testfiles/devices/UR6855A/geometry/joint2.stl

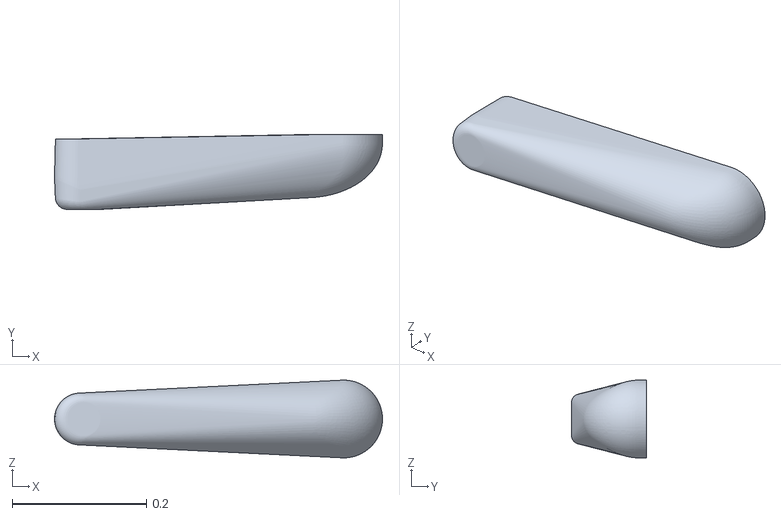
[picture p66: CAD file, 2013-05-24]
RobWork/test/testfiles/devices/UR6855A/geometry/joint2.stl
0.489 x 0.112 x 0.116
