skyellen/robwork-mirror/RobWork/test/testfiles/geoms/FingerMid.stl

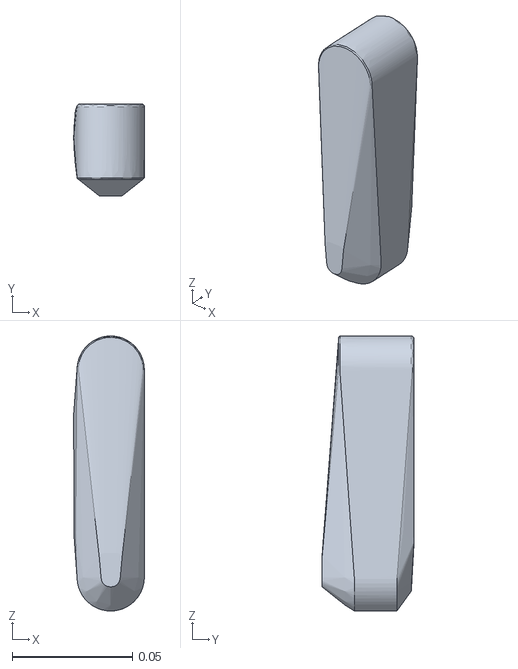
[picture p67: CAD file, 2012-03-18]
RobWork/test/testfiles/geoms/FingerMid.stl
0.0294 x 0.0381 x 0.115
