skyellen/robwork-mirror/RobWork/test/testfiles/workcells/simple_wc/PA10/Geometry/floor.stl

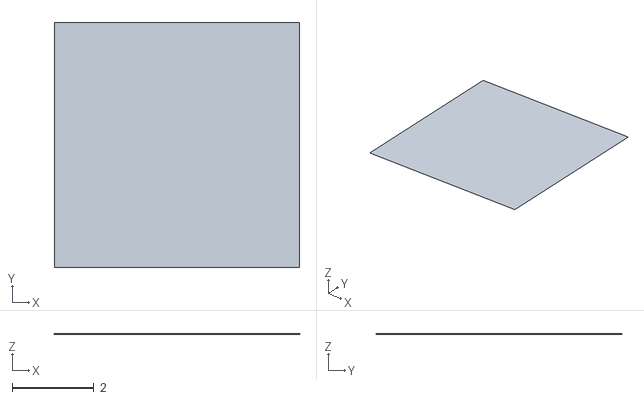
[picture p68: CAD file, 2009-11-05]
RobWork/test/testfiles/workcells/simple_wc/PA10/Geometry/floor.stl
6.00 x 6.00 x 0.01
