skyellen/robwork-mirror/RobWorkHardware/example/ur/MARVIN/robots/geometry/rob_1c.stl

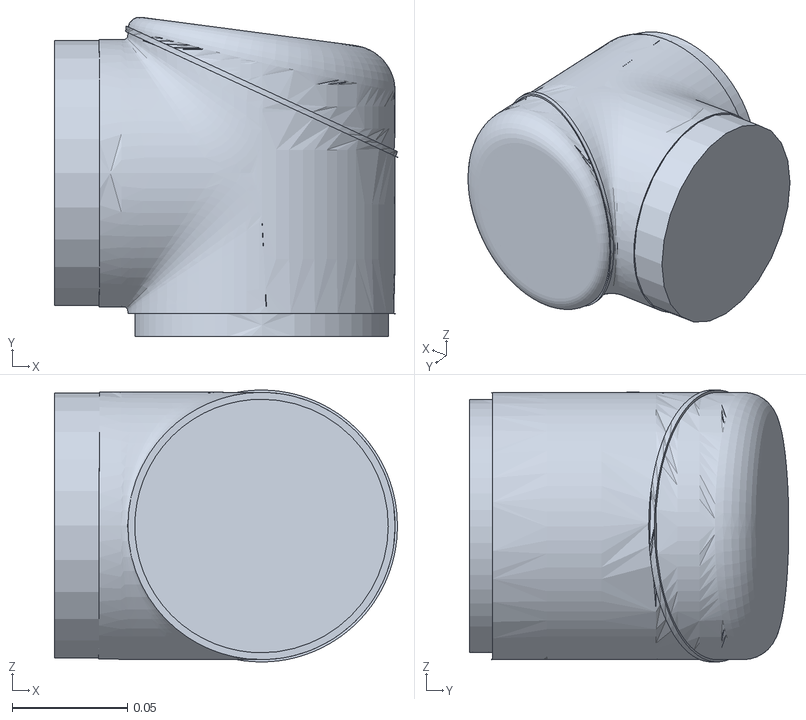
[picture p69: CAD file, 2013-10-11]
RobWorkHardware/example/ur/MARVIN/robots/geometry/rob_1c.stl
0.149 x 0.139 x 0.118
