skyellen/robwork-mirror/RobWorkSim/test/testfiles/devices/SDH2/geometry/FingerTip_hull.stl

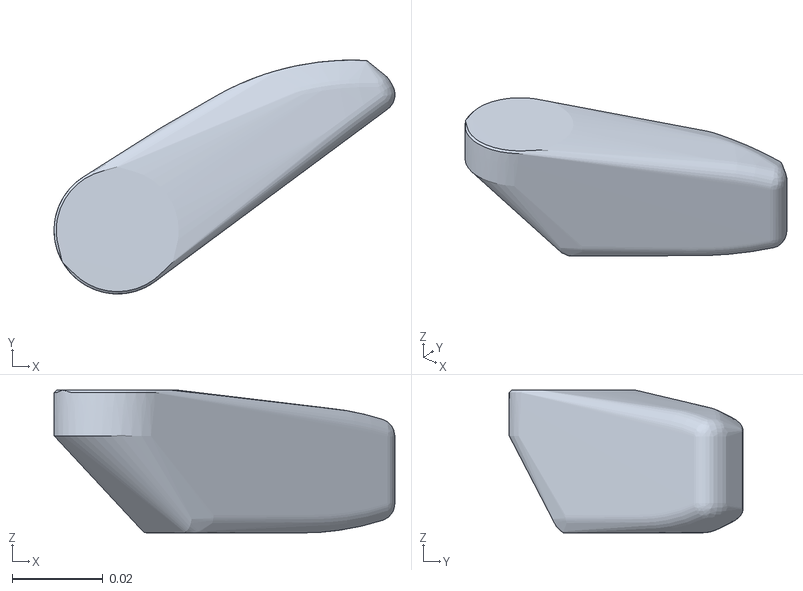
[picture p70: CAD file, 2012-02-03]
RobWorkSim/test/testfiles/devices/SDH2/geometry/FingerTip_hull.stl
0.0752 x 0.0516 x 0.0315
