skyellen/robwork-mirror/RobWorkSim/test/testfiles/scene/Circular_Compliance/geometry/Hole_Ø32.stl

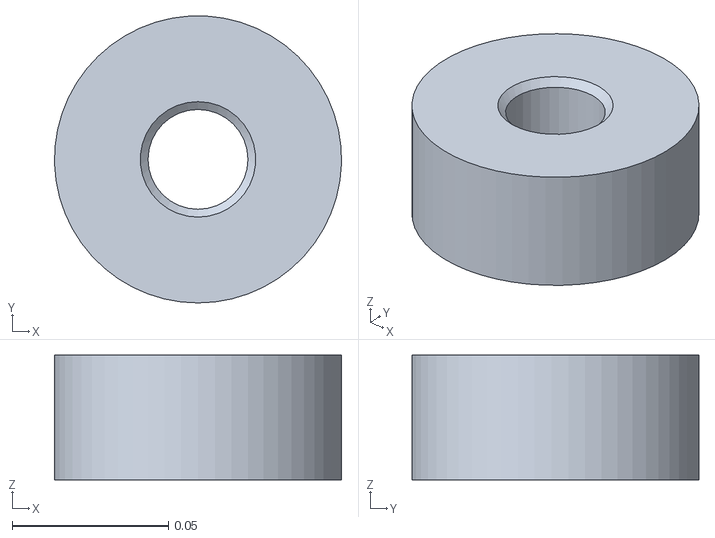
[picture p71: CAD file, 2016-06-06]
RobWorkSim/test/testfiles/scene/Circular_Compliance/geometry/Hole_Ø32.stl
0.092 x 0.0919 x 0.04
