skyellen/robwork-mirror/RobWork/test/testfiles/devices/Robotiq-2-finger-85/geometry/base.stl

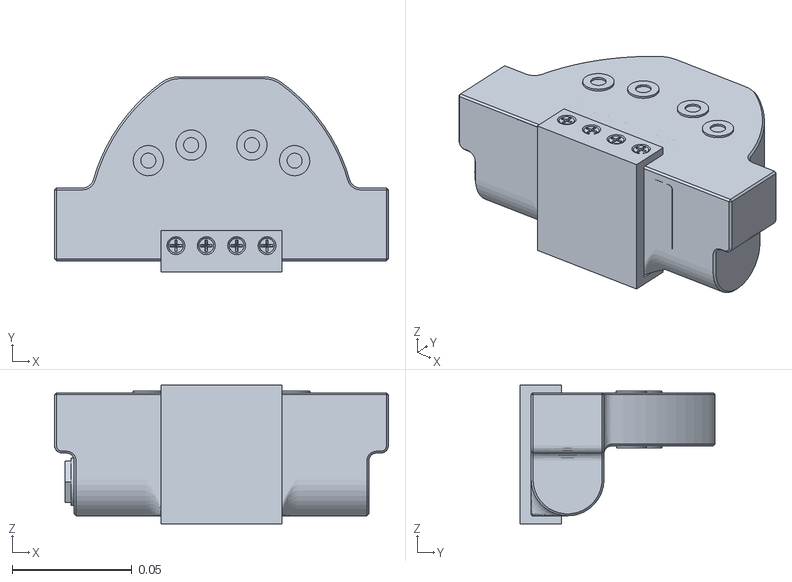
[picture p72: CAD file, 2017-12-04]
RobWork/test/testfiles/devices/Robotiq-2-finger-85/geometry/base.stl
0.14 x 0.0818 x 0.0579
