skyellen/robwork-mirror/RobWork/test/testfiles/workcells/simple_wc/PA10/Geometry/welding-gun.stl

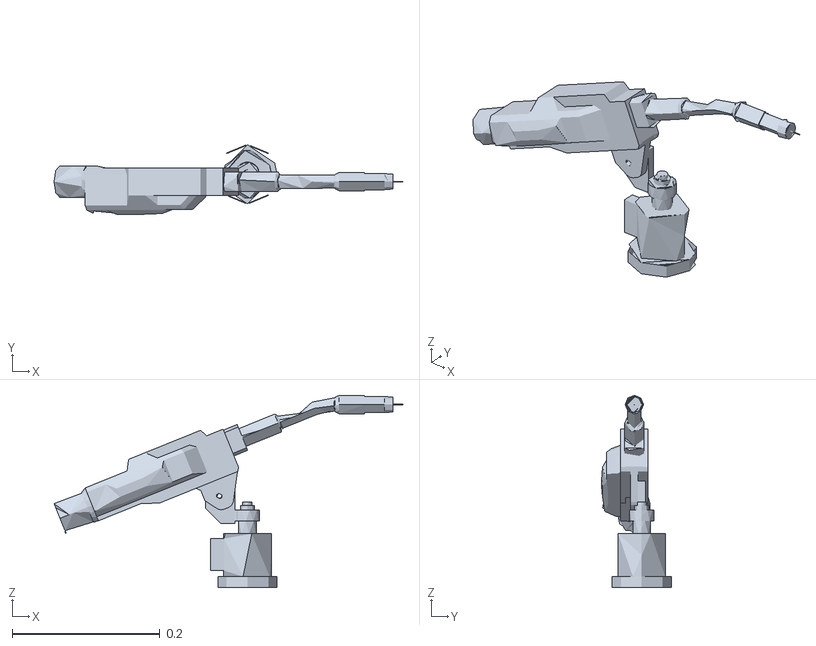
[picture p73: CAD file, 2009-11-05]
RobWork/test/testfiles/workcells/simple_wc/PA10/Geometry/welding-gun.stl
0.472 x 0.0942 x 0.26
