skyellen/robwork-mirror/RobWorkHardware/example/ur/MARVIN/robots/geometry/rob_2c.stl

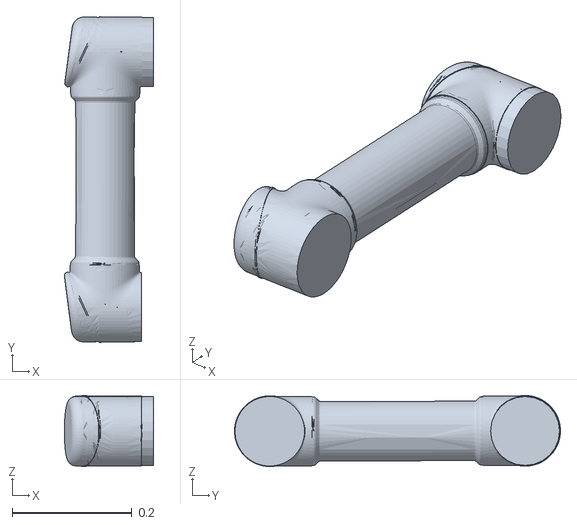
[picture p74: CAD file, 2013-10-11]
RobWorkHardware/example/ur/MARVIN/robots/geometry/rob_2c.stl
0.149 x 0.544 x 0.119
