skyellen/robwork-mirror/RobWorkSim/test/testfiles/devices/SDH2/geometry/Base_hull.stl

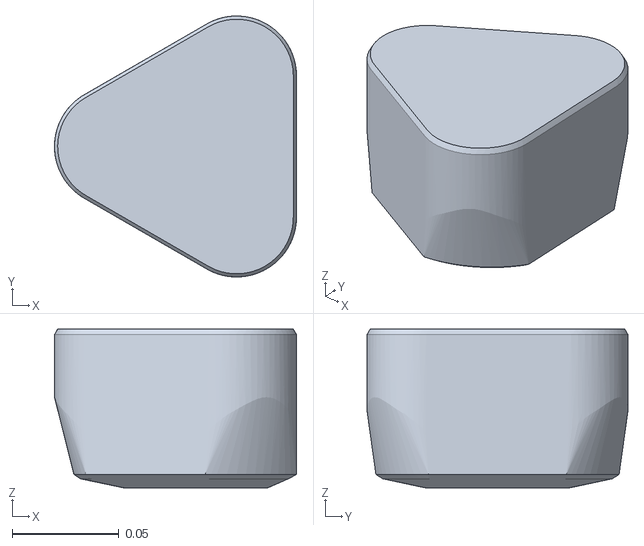
[picture p75: CAD file, 2012-02-03]
RobWorkSim/test/testfiles/devices/SDH2/geometry/Base_hull.stl
0.113 x 0.122 x 0.0743
