skyellen/robwork-mirror/RobWorkSim/test/testfiles/objects/peg30-10.stl

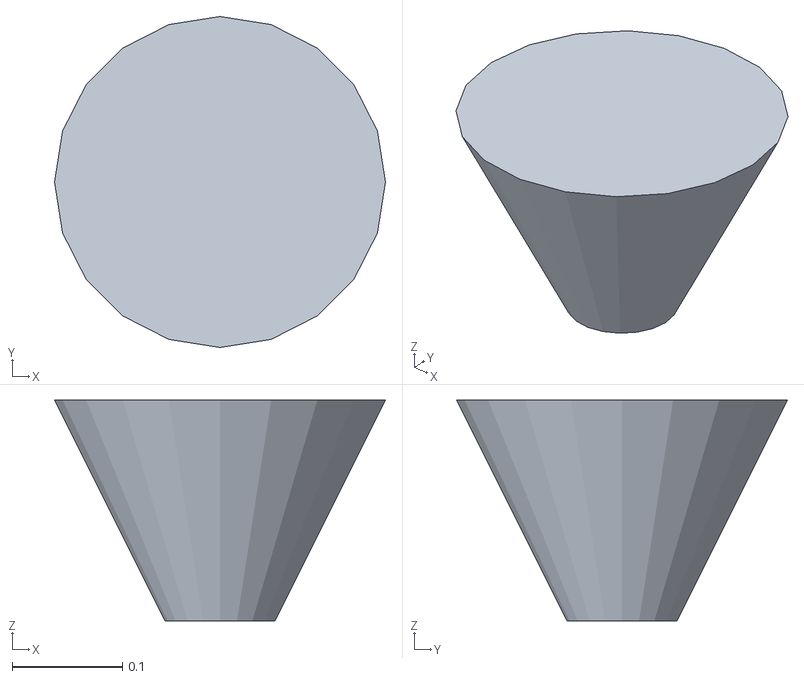
[picture p76: CAD file, 2013-01-26]
RobWorkSim/test/testfiles/objects/peg30-10.stl
0.3 x 0.3 x 0.2
