skyellen/robwork-mirror/RobWork/test/testfiles/devices/UR6855A/geometry/joint5.stl

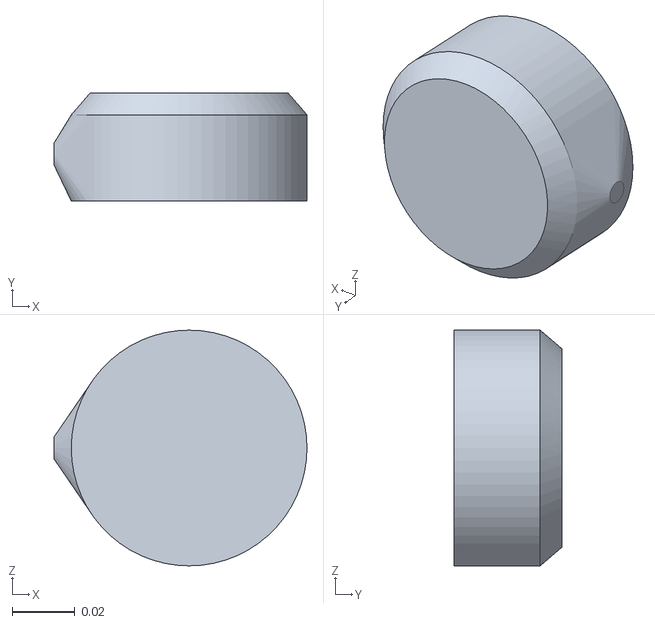
[picture p77: CAD file, 2013-05-24]
RobWork/test/testfiles/devices/UR6855A/geometry/joint5.stl
0.0805 x 0.0345 x 0.075
