skyellen/robwork-mirror/RobWork/test/testfiles/workcells/simple_wc/PA10/Geometry/Rob-3.stl

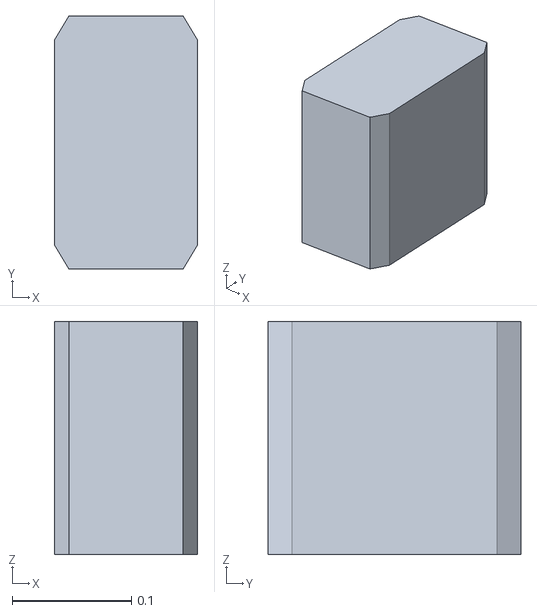
[picture p78: CAD file, 2009-11-05]
RobWork/test/testfiles/workcells/simple_wc/PA10/Geometry/Rob-3.stl
0.12 x 0.212 x 0.196
