skyellen/robwork-mirror/RobWorkHardware/example/ur/MARVIN/robots/geometry/rob_5c.stl

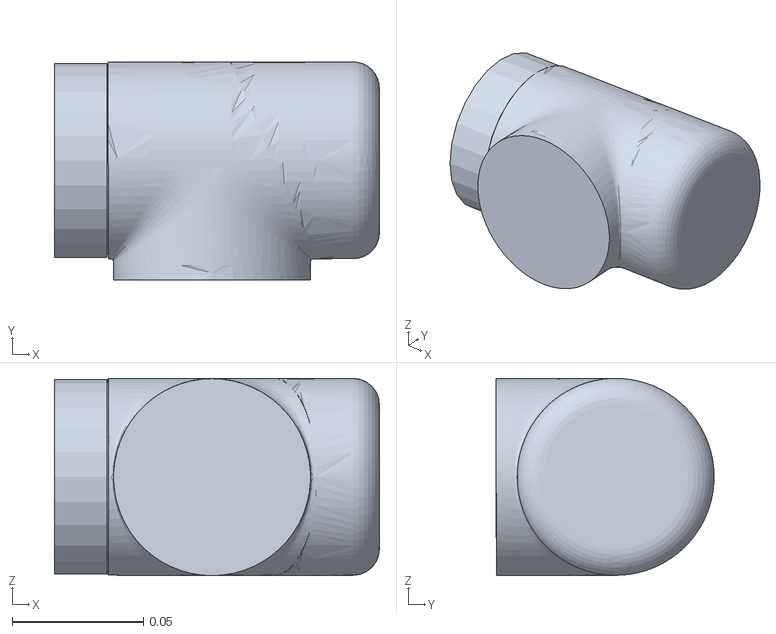
[picture p79: CAD file, 2013-10-11]
RobWorkHardware/example/ur/MARVIN/robots/geometry/rob_5c.stl
0.124 x 0.0831 x 0.0751
