skyellen/robwork-mirror/RobWorkSim/test/testfiles/devices/SDH2/geometry/schunkFlance_hull.stl

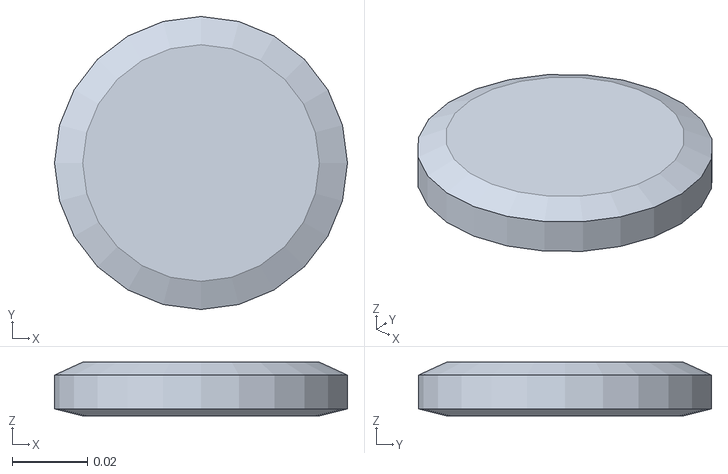
[picture p80: CAD file, 2012-02-03]
RobWorkSim/test/testfiles/devices/SDH2/geometry/schunkFlance_hull.stl
0.078 x 0.078 x 0.0143
