skyellen/robwork-mirror/RobWorkSim/test/testfiles/objects/peg-square298.stl

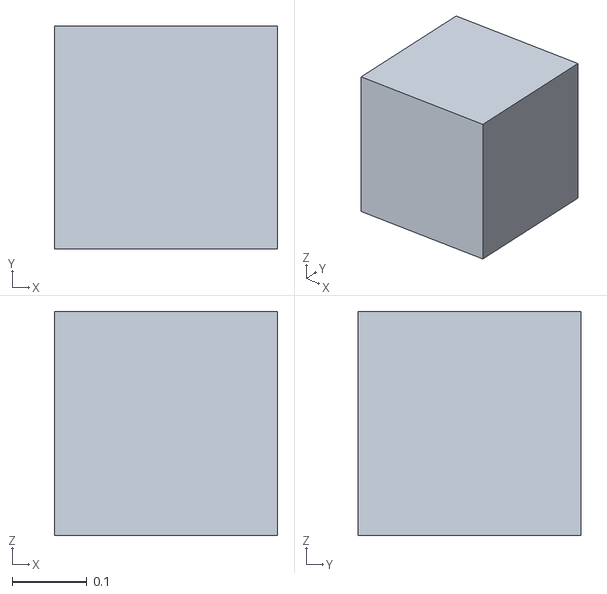
[picture p81: CAD file, 2013-01-26]
RobWorkSim/test/testfiles/objects/peg-square298.stl
0.298 x 0.298 x 0.3
