skyellen/robwork-mirror/RobWork/test/testfiles/devices/UR6855A/geometry/robotFlange.stl

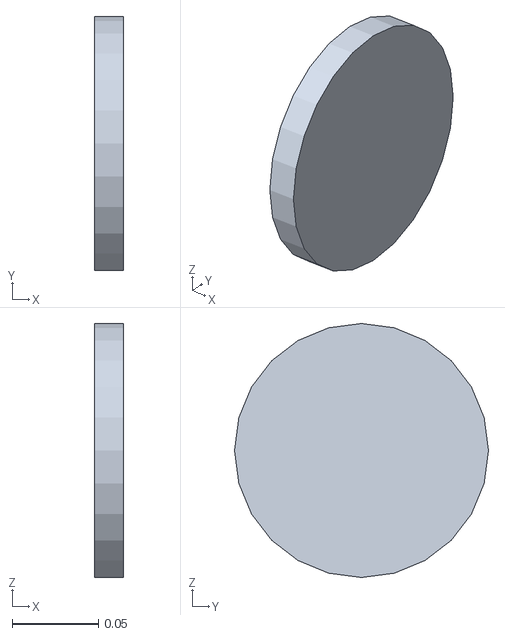
[picture p82: CAD file, 2010-06-25]
RobWork/test/testfiles/devices/UR6855A/geometry/robotFlange.stl
0.017 x 0.147 x 0.147
