skyellen/robwork-mirror/RobWork/test/testfiles/workcells/simple_wc/PA10/Geometry/Rob-0.stl

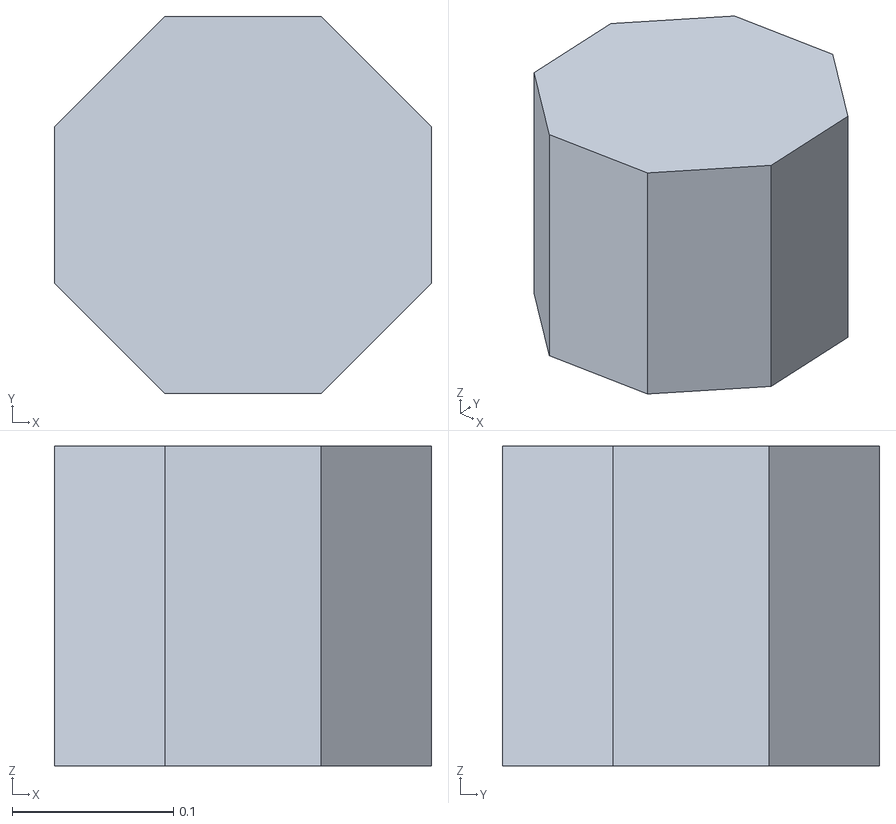
[picture p83: CAD file, 2009-11-05]
RobWork/test/testfiles/workcells/simple_wc/PA10/Geometry/Rob-0.stl
0.234 x 0.234 x 0.199
