skyellen/robwork-mirror/RobWork/test/testfiles/devices/UR6855A/geometry/base.stl

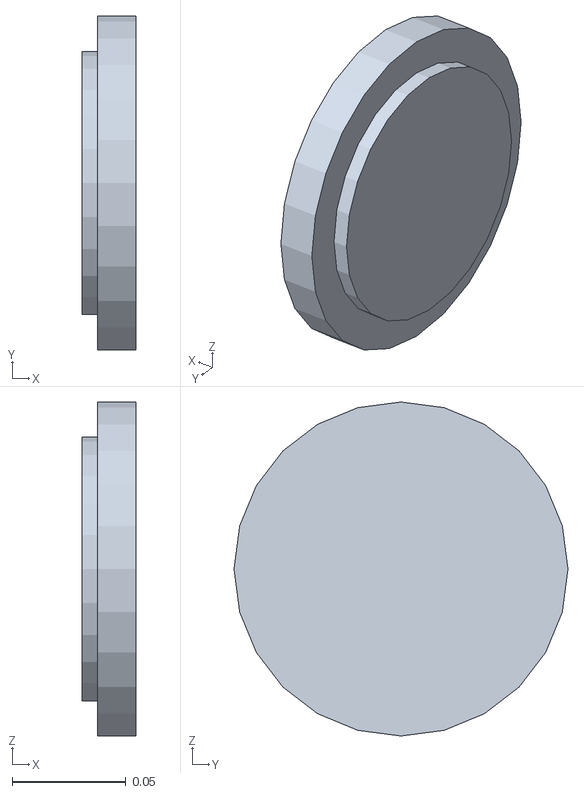
[picture p84: CAD file, 2010-06-25]
RobWork/test/testfiles/devices/UR6855A/geometry/base.stl
0.0239 x 0.147 x 0.147
