skyellen/robwork-mirror/RobWorkSim/test/testfiles/objects/Finger_slim_m_v10.stl

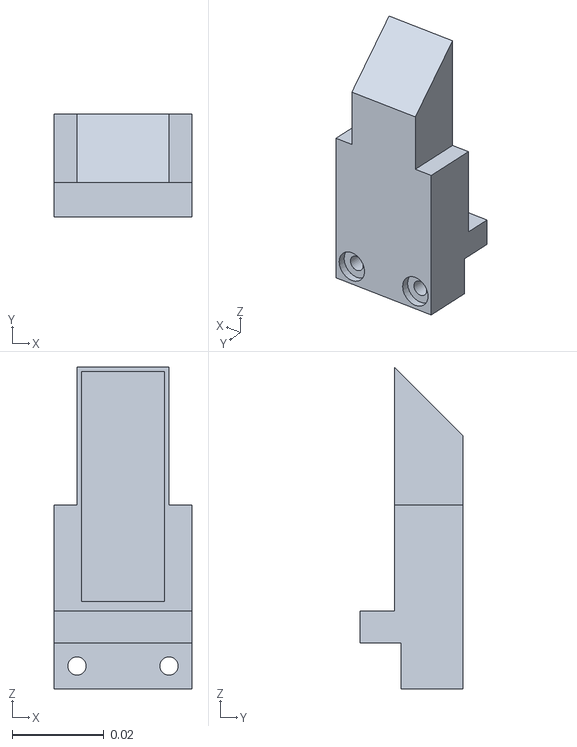
[picture p86: CAD file, 2011-02-16]
RobWorkSim/test/testfiles/objects/Finger_slim_m_v10.stl
0.03 x 0.0225 x 0.07
