skyellen/robwork-mirror/(list of files, cad)

Other CAD files:
RobWork/test/testfiles/geoms/table_union.stl
RobWorkHardware/src/sandbox/falcon/ur_control_test_scene/geometry/GreenCup_5k_tex.stl
RobWorkSim/src/sandbox/grippers/setups/belt_pump/pump.stl
RobWorkSim/test/testfiles/devices/SDH2/geometry/FingerBase_hull.stl
RobWorkSim/test/testfiles/objects/peg298.stl
RobWork/test/testfiles/devices/UR6855A/geometry/joint4.stl
RobWorkSim/test/testfiles/scene/Circular_Compliance/geometry/Hole_Ø31,5.stl
RobWorkSim/test/testfiles/objects/OrangeMarmelade.stl
RobWorkSim/test/testfiles/scene/Circular_Compliance/geometry/Circular_Ø32_tool.ipt
RobWorkSim/test/testfiles/scene/Circular_Compliance/geometry/Circular_Ø32_tool.stl
