skyellen/robwork-mirror/RobWork/example/snippets/ex-print-devices.txt

Workcell WorkCell[workcell.xml] contains devices:
- PA10
