skyellen/robwork-mirror/doc/manual/manual.hpp.md

User Manual (C++)  {#page_rw_manual}
=================
[TOC]

This manual introduce the reader to the C++ api of RobWork, how to use it, extend it and 
how it is designed.

# Introduction #	{#sec_rw_intro}
The main focus during the initial development of RobWork, was to provide a c++ toolbox of basic mathematics, kinematics, visualization
and motion planning for robotic research and applications. After several years the goals of RobWork expanded to include
more functionality with task description, script interface, plugin interfaces, dynamic simulation, simple vision and a
more general and extensible visualization tool. This made RobWork appear to be more of a framework than a toolbox, and in simple
applications this was true. However, the goal of RobWork has never been and probably never will be to include or become
a component/communications framework such as e.g. Orocos, Orca or ROS. In fact for large projects
we (RobWork developers) use and also encourage others to use these frameworks in conjunction with RobWork. In that
case RobWork is best viewed as a C++ toolbox and not a complete framework.

It is important to understand this development of RobWork and also its dual usage as both framework and toolbox since
this is somewhat reflected in the software structure of RobWork. One of the main concerns in the development process
has been to limit the number of external dependencies and to keep a clean "self explaining" Java style API. As such
the project has been split in several packages allowing the use of toolbox functionality without too many
external dependencies.

 - RobWork - the core package with only two mandatory dependencies: *Boost* and *Xerces* 
 - RobWorkStudio - the visualization package which adds one additional dependency on *Qt*
 - RobWorkSim - the dynamic simulation package which only adds additional optional dependencies such as *ODE*,
 *Bullet* and *Moby* 
 - RobWorkHardware - the hardware interface package which only adds additional optional dependencies which are dictated
 by the actual hardware requirements.

Figure 2 shows a structural overview of RobWork and how
it is to be applied in applications. The four layers do not
describe a control architecture, but illustrates how various
software packages depends upon each other. At the bottom
level labeled External we find the libraries on which
RobWork relies.

\image html overview-640.png
\image latex overview.png

All code examples of this manual are self-contained in the sense that
they will compile if placed in a C++ file of their own. The examples
are found in the \c RobWork/docs directory. 

The remainder of this manual will be structured as follows:

First a conceptual overview of RobWork will be given which is essential for those new to RobWork. Thereafter
different concepts, components and primary interfaces of RobWork will be described in more detail e.g. kinematics,
stateless design, the workcell, robot devices, inverse kinematics, collision detection, scene graph rendering,
 motion planning, grasp planning and task planning. The detailed description of key elements in RobWork will be
 followed with key usages such as using the RobWork plugin structure, the GUI plugin structure, the Lua scripting
 structure, the stateless structure and so on. At last the different fileformats and their loaders used in RobWork
 will be described
 including the WorkCell XML format, the dynamic workcell format, proximity setup format, state list format,
 grasp table format, (TODO: get all formats and their loaders eg. image, ...)

## Notation ## {#sec_rw_manual_notation}

In general a diagonal notation form will be used to describe the relation
of vectors, rotation matrices, homogeneous transform, velocity screw,
and so on.

Expression                                  | Description
----------                                  | -----------
\f$ \robax{a}{\mathbf{P}} \f$               | Vector P seen in frame *a*
\f$ \robabx{a}{b}{\mathbf{P}} \f$           | Translation of frame *b* seen in frame *a*
\f$ \robabx{a}{b}{\mathbf{R}} \f$           | Rotation of frame \b b seen in frame *a*
\f$ \robabx{a}{b}{\mathbf{T}} \f$           | Homogeneous transform of frame *b* seen in frame *a*
\f$ \robabcdx{a}{b}{c}{d}{\mathbf{T}_v} \f$ | Velocity transform that transforms the reference frame from *b* to *a* and the velocity reference point from *c* to *d*
\f$ \robabcdx{a}{b}{c}{d}{\mathbf{T}_f} \f$ | Force transform that transforms the reference frame from *b* to *a* and the force reference point from \b c to \b d
\f$ \robabx{a}{b}{\mathbf{J}} \f$           | A Jacobian matrix defined from reference frame *a* to frame *b*

When coordinate frames are visualized the axes are illustrated with the colors RGB, such that 
Red(x-axis), Green(y-axis) and Blue(z-axis).

## Namespaces ## {#sec_namespaces}

The header files of RobWork are distributed across a number of
directories each having its own namespace. The structure of namespaces 
reflects the directory containing the code. For example

~~~~~~~~~~~~{.cpp}
 // Include header files:
 #include <rw/models/WorkCell.hpp>
 #include <rw/kinematics/Frame.hpp>
 using namespace rw::models; //Namespace for WorkCell included by #include<rw/models/WorkCell.hpp>
 using namespace rw::kinematics; //Namespace for Frame included by #include <rw/kinematics/Frame.hpp>
~~~~~~~~~~~~

All classes related to the RobWorkStudio package are placed in a namespace rws. All classes related to RobWorkHardware are in the namespace rwhw;

## Libraries ## {#sec_libraries}

All classes of the *rw* directory are provided in a single library named *rw*.

The subdirectories of the *rwlibs* directory each correspond to a
different library. The subdirectory *rwlibs/xyz* corresponds to the
library named *rw_xyz* and contains the objects in the namespace rwlibs::xyz. For example, suppose your program contains
the following include statement:

~~~~~~~~~~~~{.cpp}
 #include <rwlibs/pathplanners/rrt/RRTPlanner.hpp>
~~~~~~~~~~~~

To build this program, you should link with *rw_pathplanners*.

# Installation and Use # {#sec_rw_manual_installation}

# Concept # {#sec_rw_manual_concept}
- Smart Pointer
- WorkCell, StateLess structure, Frame, Device, forward kinematics
- Collision Detection, Scene Graph Rendering
- Inverse Kinematics, Motion Planning, Grasp Planning, Task Planning
- Plugin structure, Lua Script interface

# Serialization # {#sec_rw_manual_serialization}
There are two main structures for performing serialization in RobWork. 

First, there is a XML DOM
parser interface that lets you easily read and write XML data. This interface is 
used throughout RobWork for reading and writing well defined data exchange formats. The XML DOM
parser should not be used as a class serialization structure but rather in properly defined 
loader and saver factories. The XML DOM parser is especially useful as an extension mechanism 
for current parsing formats, eg. the user can write a plugin that plugs into an existing parsing 
implementation such as the workcell format. 

Secondly, there is 
a generic serialization framework which enables serialization of classes. This framework enables 
serialization to different archive types and can be used for serializing many different formats, including
binary and user defined formats.  

## XML DOM parsing ##
The backend to the XML DOM parser is 
pluginable and the full features such as validation is therefore depending on the backend. 
Both boost property tree and xercess backends are supported.     

Here is a small example on creating a DOM parser which parses from an input stream (instream)  
~~~~~~{.cpp}
    DOMParser::Ptr parser = DOMParser::make();
    parser->setSchema(schemaFileName);
    parser->load(instream);
    DOMElem::Ptr root = parser->getRootElement();
~~~~~~

The \b root class can now be used for parsing the xml data. Lets assume we have a xml file that looks like:

~~~~~~{.xml}
	<group someboolproperty="true" someintproperty="10">
	 <elem-string> </elem-string>
	 <elem-int> </elem-int>
	 <elem-double-list>0.1 0.2 0.1</elem-double-list> 
	</group>
~~~~~~

~~~~~~{.cpp}
	DOMELem::Ptr gelem = root->getElement("group"); // throws an error if "group" is not there
	bool boolprop = gelem->getAttributeValueAsBool("someboolproperty", true); // defaults to true
	int intprop = element->getAttributeValueAsInt("someintproperty", 2); // defaults to 2
	// iterate over all elements in group
	BOOST_FOREACH(DOMElem::Ptr child, gelem->getChildren()){
		if(child->isName("elem-string")){
			std::string str-value = child->getValue();
		} else if (child->isName("elem-int")) {
			int int-val = child->getValueAsInt();
		} else if (child->isName("elem-double-list")) {
			std::vector<double> double-val-list = child->getValueAsDoubleList(); // default seperator is space ' '			
		}
	}
~~~~~~

## Generic serialization  ##
The generic serialization is not a centralized controlled serialization as the XML
 serialization described above. There are two main concepts to the generic
serialization: Archive, Serializable

An Archive is an instance that formats data that can be read or written to it from a 
Serializable object/class. As such interfaces for both InputArchive and 
OutputArchive exists. A serializable class is a class that either inherits from 
the rw::common::Serializable (intrusive) or using an extrusive way that overwrites the functions

~~~~~ {.cpp} 
void rw::common::serialization::write(const THE_CLASS&, OutputArchive& oar);
void rw::common::serialization::read(THE_CLASS&, InputArchive& iar);
~~~~~

In any case save and load methods should be determined for the individual 
serializable classes. In these methods read/write operations on the archive should
be performed such as to store or restore the state of the class. The use of 
an archive can be quite simple:

~~~~~~{.cpp}
INIArchive ar(std::cout);
ar.write(1, "length");
ar.write(1.120, "width");
ar.write(5.120, "height");
produce:
length : 1
width : 1,120
height : 5.120
~~~~~~

As can be seen an identifier can be associated to the value that is to be serialized. This 
id makes type checking possible and should allways be used/defined. The archive interface 
define serialization of primitives (int, float, double, string) and vectors of primitives.
More complex types will need to implement their own serialization pieced together from 
the primitives.

Finally, the archive also defines a way to enter scopes. A scope is simply a grouping of 
value-identifier pairs. 

~~~~~~{.cpp}
	void write(const KDTreeQ<VALUE_TYPE>& out, OutputArchive& oarchive) {
	    oarchive.write(out._dim, "dim");
	    oarchive.write((int)out._nodes->size(), "nrNodes");
	    oarchive.write((boost::uint64_t)out._root, "rootId");
	    RW_ASSERT(out._nrOfNodes==out._nodes->size());
	    for(int i=0;i<out._nodes->size();i++){
	        const TreeNode &node = (*out._nodes)[i];
	        oarchive.write((boost::uint64_t)&node, "id");
	        oarchive.write( node._axis, "axis");
	        oarchive.write( node._deleted, "del");
	        oarchive.write( node._left, "left");
	        oarchive.write( node._right, "right");
	        oarchive.write( node._kdnode->key, "Q");
	        oarchive.write( node._kdnode->value, "value");
	    }
	}
~~~~~~

### Archive types ###
There is currently:
- an rw::common::INIArchive which prints in INI format
- an rw::common::BINArchive which prints in binary compressed format 

### Limitations ###

# Workcells # {#sec_rw_manual_workcells}
The WorkCell is one of the primary containers in RobWork. A WorkCell should gather all stateless 
elements/models of a scene. These are primarily:
- Kinematic structure of frames
- All devices 
- All sensors  
- All controllers

## Loading a WorkCell ## {#sec_rw_manual_load_workcell}
RobWork supports workcells described in an XML format.

The below program loads a workcell from the file named on the command
lie. If the loading of the workcell fails, the
rw::loaders::WorkCellLoader::load() function will throw an exception,
and the program will abort with an error message.

\include ex-load-workcell.cpp

## Traversing the devices of a workcell ## {#sec_rw_manual_traverse_devices}

A workcell contains a number of devices (rw::models::Device). You can
for example traverse the devices stored in a workcell and print their
names like this:

\include ex-print-devices.cpp

A device of a specific name can be retrieved from a workcell with
rw::models::WorkCell::findDevice(). You can add a device type to the search 
such that only a device of name \b name and type \b type will be found:
rw::models::WorkCell::findDevice<type>(name)

##  Stateless models ## {#sec_rw_manual_stateless}
A very important aspect when working with RobWork is the understanding of its use of Stateless models.
To illustrate state full and state less we give two small code examples:

~~~~~~{.cpp}
struct StateFull {
 double getQ(){ return _q; }
 void setQ(double q){ _q=q; }
 double _q;
}

struct StateLess {
 double getQ(State& state){ return state.getDouble(this); }
 void setQ(double q, State& state){ state.setDouble(q, this); }
}
~~~~~~

Now in the first struct: StateFull, the Q value is stored local as a member value. In the StateLess struct
the Q value is stored in a seperate class \b State. How the state stores this value is currently not important
but to see how this is implemented in RobWork you should look into rw::kinematics::State,
rw::kinematics::StateData and rw::kinematics::StateStructure.

The benefit of a stateless design is primarily that multiple threads or multiple methods can use
the same Device model at the same time. E.g. methods for visualisation can visualize a device in one state,
while a user is setting the configuration of a device in another state. This effectively reduce thread related issues
and also limits the need to copy the models around.

Only few variables of a stateless Classes in robwork are actually saved in the state, they are not completely stateless.
The variables that are saved in the state are the dynamically changing states such as the configuration of a robot device e.g. joint configurations. The more static variables such as joint boundaries are still saved lokally in the object.

# Kinematics trees and states # {#sec_rw_manual_states}

The kinematic structure of the work cell is represented by a tree of
frames (see rw::kinematics::Frame). The root of the kinematic tree is
called the \e world \e frame (rw::models::WorkCell::getWorldFrame()).
Each frame has a transformation (see rw::math::Transform3D) relative
to its parent frame and this transformation may change in response to
values assigned for the frame. A revolute joint of a device (see
rw::models::RevoluteJoint) is for example implemented as a frame that
has a single value that rotates the frame relative to its parent. 
Besides revolute joints RobWork also supports prismatic joints and dependent
joints for which the value may depend on other joints.

It is important in RobWork to note that the values for the frames are
not stored \e within the frames, but are instead stored explicitly in
a value of type rw::kinematics::State. Given a state for the workcell,
the transform of a frame relative to its parent can be calculated with
rw::kinematics::Frame::getTransform().

The frames of the workcell are always organized in a tree, but for
certain frames the parent that they are connected to can dynamically
be changed. These frames are called \e dynamically \e attachable \e
frames or \e DAFs for short. The parent that a DAF is attached to is
not stored within the DAF itself, but is instead stored externally in
a State value. Different state values can thus correspond to different
structures of the tree. Given a state for the workcell the parent and
children of a frame can be retrieved with
rw::kinematics::Frame::getParent() and
rw::kinematics::Frame::getChildren().

Because the values of the frames and the attachments of DAFs are
stored outside of the workcell, we say that the workcell is \e
stateless. This enables a workcell and the associated data to be used 
concurrently in multiple threads as well as to easily communicate the 
entire state of a workcell.

To illustrate these important ideas, this example shows how to print
the structure of the kinematic tree of the workcell and for each frame
print also the position of the frame in space:

\include ex-print-kinematic-tree.cpp

We see from this example that given a state, it is straight-forward to
compute the transform of every single frame in the workcell. RobWork
has some utilities to make calculation of forward kinematics
convenient in the day to day work, such a rw::kinematics::FKTable and rw::kinematics::FKRange described below.

## World transforms for a set of frames ## {#sec_rw_manual_FKTable}

rw::kinematics::FKTable computes the forward kinematics for a number
of frames for a common state. The results of the forward kinematics
are stored in the FKTable object so that the transform for a frame is
not computed over and over again. This example shows how the transform
for a sequence of frames can be efficiently computed:

\include ex-world-transforms.cpp

## Relative transforms for a pair of frames ## {#sec_rw_manual_FKRange} 

rw::kinematics::FKRange computes the relative transform for a pair of
frames. To efficiently compute the relative transform for a pair of
frames the path in the kinematic tree that connects the frames must be
computed. Knowing the path and the relative transform between adjacent
frames of the path (rw::kinematics::Frame::getTransform()) the full
transform from start to end of the path can be computed. This example
shows the use of rw::kinematics::FKRange:

\include ex-frame-to-frame-transform.cpp

If you repeatedly compute the forward kinematics for the same pair of
frames and the same parent-child structure of the tree, you can reuse
the rw::kinematics::FKRange object so that e.g. the path connecting
the frames need not be recomputed. For example, given a pair of frames
and a set of states the relative transforms that relate the frames can
be computed efficiently as follows:

\include ex-frame-to-frame-transforms.cpp

The frameToFrameTransform() utility function is available as
rw::kinematics::Kinematics::frameTframe().

## Dynamically attachable frames and movable frames ## {#sec_rw_manual_dafs}

A \e dynamically \e attachable \e frame (DAF) is a frame for which the
parent frame can be changed. We say that the frame is attached to a
new parent frame (rw::kinematics::Frame::attachFrame()). A DAF can be
attached to any frame of the workcell except itself. You should avoid
attaching a DAF to a child of its subtree as this will create a cycle
in the kinematic structure. Frames of any type can be a DAF. You can
check if a frame is a DAF like this:

\include ex-is-daf.cpp

DAFs are used for example to simulate the picking up of an item by a
gripper. The item is represented by a DAF and is initially attached to
some frame of the workcell. When the gripper is closed, the picking up
of the item is simulated by attaching the item frame to the gripper
frame.

If the parent frame of a DAF is changed, the world transform of the
DAF will generally change also. When simulating the picking up of an
item, you do not want the item to instantly change position in space.
Therefore a DAF is often a \e movable \e frame
(rw::kinematics::MovableFrame) also. A movable frame is a frame for
which an arbitrary transform can be set for the transform of the frame
relative to its parent (rw::kinematics::MovableFrame::setTransform()).
To simulate the gripping of the item, the parent of the frame is set
to the frame of the gripper, and at the same time the relative
transform of the item is assigned a value that equals the transform
from gripper to item. This procedure is carried out as follows:

\include ex-grip-frame.cpp

The function receives the current state of the workcell as input and
updates this state to reflect the gripping of the item. Recall that
the frames themselves are stateless: The attachment of the DAF and its
change of relative transform is stored entirely within the state.

RobWork provides utilities for the above in the form of the
rw::kinematics::Kinematics::gripFrame() and
rw::kinematics::Kinematics::gripMovableFrame() collection of
functions.

# Devices and configurations # {#sec_rw_manual_device_configurations}

Algorithms for workcells often do not operate on the level of frames
and the values for frames. Instead they operate on \e devices
(rw::models::Device) and \e configurations (rw::math::Q) for devices.

A device controls a subset of frames of the workcell. Different
devices may overlap in the frames that they control and one device may
contain one or more other devices (rw::models::CompositeDevice). A
workcell for a factory application can for example have one device for
a 6-axis industrial robot and another 2-axis device that controls the
position of the base of the robot. These two device may be combined
into one large 8-axis device (rw::models::CompositeDevice).

A configuration is an vector of values for the frames of a device.
Configurations support standard vector operations such as addition,
scalar multiplication, inner product, etc. The \e configuration \e
space of a device is the set of valid configurations of a device. For
the rw::models::Device type, the configuration space is always box
shaped and described by a tuple containing the lower and upper corner
(see rw::models::Device::QBox and rw::models::Device::getBounds()).

Algorithms for devices often assume that only the configuration for
the device is changed while the state (rw::kinematics::State) of the
rest of the workcell stays fixed. A path-planner may for example
return a path in the form of a sequence of configurations together
with the common workcell state for which the planning was done. When
writing or using such algorithms you will often have translate from a
configuration for the device to a state of the workcell. This is
accomplished by the methods rw::models::Device::setQ() and
rw::models::Device::getQ(). This is example shows to convert a
sequence of configurations for a common state into a sequence of
states:

\include ex-get-state-path.cpp

This utility function is also available as
rw::models::Models::getStatePath().

Note that rw::models::Device::setQ() and rw::models::Device::getQ() do
not store a configuration within the device: The configuration is read
from and written to a state value. The device itself is stateless.

# Configuration space metrics and other metrics # {#sec_rw_manual_metrics}

rw::math::Metric<\e X> is the general interface for measuring a
distance between a pair of values of type \e X. Path planning
algorithms, for example, often require a metric for measuring the
distance between configurations.

Metrics available in RobWork include:

- Manhattan metric (rw::math::MetricFactory::makeManhattan(),
  rw::math::MetricFactory::makeWeightedManhattan())

- Euclidean metric (rw::math::MetricFactory::makeEuclidean(),
  rw::math::makeWeightedEuclidean())

- Infinity metric (rw::math::MetricFactory::makeInfinity(),
rw::math::MetricFactory::makeWeightedInfinity())

These build-in metrics can be instantiated for configuration types
(rw::math::Q) and other vector types such as rw::math::Vector3D and
std::vector<double>. This program shows instantiation and expected output for
3 different metrics:

\include ex-metrics.cpp

# sec_rw_manual_proximity Collision checking # {#sec_rw_manual_metrics}
The rw::proximity package provides functionality for collision checking. When using a WorkCell and Frames the primary interface will be the rw::proximity::CollisionDetector. To each frames there can be zero or more geometries associated. When stating the two frames are checked against each other, it is in reality the geometries of these which are tested. Notice, that two geometries associated to the same frame are never tested against each other.

Inside the CollisionDetector the checking is divided into two phases:
- Broad phase: Provides a filtering which determines which pairs of frames that need to be tested in the narrow phase.
- Narrow phase: Performs the actual collision checking between geometries.

The default broad phase filter is the rw::proximity::BasicFilterStrategy which contains the rules specified in the CollisionSetup associated to a rw::models::WorkCell. The BasicFilterStrategy maintains a list of frame pairs to check, which can be modified at runtime through include and exclude methods. 

The narrow phase is implemented through a rw::proximity::CollisionStrategy, which may wrap external libraries such as Yaobi or PQP. These wrappers for external libraries are placed in the rwlibs::proximitystrategies package. The CollisionStrategy buffers collision models and maintains a map of relations between frames and models. 

## Collision Checking - Workcells ## {#sec_rw_manual_collisions_global}
This program shows how to construct a collision detector for the default collision setup of a workcell. The example program then calls the collision detector to see if the workcell is in collision in its initial state:

\include ex-collisions.cpp

## Adding/Removing Geometries ## {#sec_rw_manual_collisions_adding_geometry} 
The content of the collision detector can be modified online by using the addModel and removeModel methods on rw::proximity::CollisionDetector. If for instance a new object is detected in a frame it can added and remove it by:

~~~~~{.cpp}
using namespace rw::proximity;
using namespace rw::kinematics;
using namespace rw::geometry;
	
void addGeometryToDetector(CollisionDetector::Ptr cd, Frame* myframe, Geometry::Ptr myGeometry)	
{
	cd->addModel(myframe, mygeometry);
}

void removeGeometryFromDetector(CollisionDetector::Ptr cd, Frame* myframe, Geometry::Ptr myGeometry) 
{		
	cd->removeModel(myframe, mygeometry->getId())
}
~~~~~

## Modifying Broad Phase Filter ## {#sec_rw_manual_collisions_modifying_broadphase}
When simulating a robot picking up an objects from a table it is necessary to modify the broad phase filter such that collision detection is disable between the object and the robot tool and enables between object and table.

To do this we can modify the broad phase filter as follows

~~~~~{.cpp}
	BasicFilterStrategy::Ptr broadphase = ownedPtr(new BasicFilterStrategy(workcell));
	CollisionDetector::Ptr collisionDetector = ownedPtr(new CollisionDetector(workcell, ProximityStrategyYaobi::make(), broadphase));

	...

	//Tool frame of the robot
	Frame* toolFrame = workcell->findFrame("Robot.TCP");
	//Frame of the object picked up
	Frame* objectFrame = workcell->findFrame("Object");
	//Frame of the table on which the object previously was located.
	Frame* tableFrame = workcell->findFrame("Table");
	
	//Remove checking between objectFrame and toolFrame
	broadphase->exclude(rw::kinematics::FramePair(objectFrame, toolFrame);
	//Add checking between the objectFrame and the tableFrame
	broadphase->include(rw::kinematics::FramePair(objectFrame, tableFrame);
		
~~~~~

# Workcell and configuration space constraints # {#sec_rw_manual_constraints}

A collision detector (rw::proximity::CollisionDetector) is an example
of a constraint on the states of a workcell. Collision checking is but
one form of constraint, and applications may implement their
constraints in terms of other classes than
rw::proximity::CollisionDetector.

The general interface for a discrete constraint on states
(rw::kinematics::State) is rw::pathplanning::StateConstraint. The
method to call to check if a constraint is satisfied for a state is
rw::pathplanning::StateConstraint::inCollision(). The naming of the
method is only a convention. The constraint need not not be concerned
with actual collisions of the workcell. A user may inherit from the interface 
and implement any kind of constraint they desire.

Path planners and other planners often operate on configurations
(rw::math::Q) rather than workcell states (rw::kinematics::State). The
interface for a discrete constraint on the configuration space is
rw::pathplanning::QConstraint and the method to call to check if the
constraint is satisfied is
rw::pathplanning::QConstraint::inCollision().

rw::pathplanning::StateConstraint as well as
rw::pathplanning::QConstraint provide constructor functions and
functions for combining constraints.

A sampling based path planner typically calls a configuration
constraint (rw::pathplanning::QConstraint) to verify individual
configurations. The path planner connects individual configurations by
edges, and verifies if the device can follow the path represented by
the edge. The interface for verifying a configuration space path
connecting a pair of configurations is called
rw::pathplanning::QEdgeConstraint. The method on the interface to
verify the edge is rw::pathplanning::QEdgeConstraint::inCollision().

Given a configuration constraint (rw::pathplanning::QConstraint), a
constraint for an edge (rw::pathplanning::QEdgeConstraint) can be
implemented by discretely checking the edge for collisions. When
constructing such edge constraint (see
rw::pathplanning::QEdgeConstraint::make()) you can specify the
resolution and metric for the discrete verification of the edge, or a
default metric and resolution can be used.

A configuration constraint together with an edge constraint is named a
planner constraint (rw::pathplanning::PlannerConstraint).
rw::pathplanning::PlannerConstraint::make() utility functions are
provided to ease the construction of constraints for standard
collision detection.

This program constructs a collision detector and corresponding default
planner constraint for the first device of the workcell. The program
calls the planner constraint to check if the edge from the lower to
upper corner of the configuration space can be traversed:

\include snippets/ex-constraints.cpp

# Configuration space sampling # {#sec_rw_manual_sampling}

Configuration space sampling is a useful tool for path planners and
various other planning algorithms.

The interface for a sampler of the configuration space is
rw::pathplanning::QSampler. The rw::pathplanning::QSampler interface
provides constructor functions, including:

- rw::pathplanning::QSampler::makeFinite(): Deterministic sampling from a finite
  sequence of configurations.

- rw::pathplanning::QSampler::makeUniform(): Configurations for a device sampled
  uniformly at random.

- rw::pathplanning::QSampler::makeConstrained(): A sampler filtered by a
  constraint.

This example shows the construction of a sampler of collision free
configurations. The sampler calls a randomized sampler of the
configuration space of the device, and filters these configurations by
the constraint that the configurations should be collision free.

\include ex-qsampler.cpp

# Path planning # {#sec_rw_manual_pathplanning}

rw::pathplanning::PathPlanner<\e From, \e To, \e Path> is the general
interface for finding a path of type \e Path connecting a start
location of type \e From and an goal location of type \e To.

Important variations of this interface includes:

- rw::pathplanning::QToQPlanner: Standard planning of a configuration
  space path that connects a start configuration to a goal
  configuration.

- rw::pathplanning::QToTPlanner: Planning of a configuration space
  path connecting a start configuration to \e any end configuration
  for which a spatial constraint represented a value of type
  rw::math::Transform3D<> is satisfied. Typically, planners of this
  type find paths for devices such that the tool of the device ends up
  at the given goal transformation (in other words, the planner of
  type rw::pathplanning::QToTPlanner implicitly solves an inverse
  kinematics problem).

- rw::pathplanning::QToQSamplerPlanner: Planning of a configuration
  space path from a start configuration to any end configuration
  returned by the sampler (rw::pathplanning::QSampler) representing
  the goal region.

These 3 planners all represent the resulting path by a sequence of
configurations (rw::trajectory::QPath).

The path planners of RobWork are placed in the library \b
rw_pathplanners. The example below instantiates a path planner for the
first device of the workcell and plans a number of paths to random
collision free configurations of the workcell. The full configuration
space path mapped to the corresponding sequence of states
(rw::kinematics::State) and written to a file that can be loaded into
\b RobWorkStudio using the \b PlayBack plugin. The example makes use
of configuration space sampling and path planning constraints
described in these earlier sections:

- \ref sec_rw_manual_sampling
- \ref sec_rw_manual_constraints

\include ex-path-planning.cpp

The path planner of the above example is based on the SBL algorithm.
This example shows instantiation of some more of the available path
planners:

\include ex-get-path-planner.cpp

Variations of these constructor functions have options for example for
controlling the configuration space exploration of the planner.

# Inverse kinematics # {#sec_rw_manual_invkin}

Module rw::invkin contains inverse kinematics (IK) solvers. The
primary types of IK solvers are:

- rw::invkin::IterativeIK: Iterative IK solvers.

- rw::invkin::ClosedFormIK: Analytical IK solvers.

Both types of IK solvers take a transform
(rw::math::Transform3D<>) as input and return configurations for a
device for which the transform from the base to the end of the device
(rw::models::Device) equals the given transform.

An iterative IK solver needs a start configuration from which to start
the iterative search. Depending on the start configuration and other
constraints, the IK solver may fail or succeed in finding a valid
configuration.

\include ex-ik.cpp

The solution of an iterative solver may depend on the starting configuration, provided in the
state given in the solve method. To search for all solution an iterative ik solver may 
be wrapped in the rw::invkin::IKMetaSolver which calls it a specified number of times with random 
start configurations. Many robots have ambiguities which can be resolved using the rw::invkin::AmbiguityResolver.

For use in planning the IK sampler interface (rw::pathplanning::QIKSampler) hides details
of selection of IK solver and start configurations for the solver. The
program below tests the default iterative IK solver for a device. The
program selects 10 random base to end transforms for a device using
the forward kinematics for the device. Using the default IK sampler,
the program then checks that an IK solution is found for all
transforms. Only a small number of start configurations are used for
each target transform, and therefore the IK sampler might not always
find an IK solution. If the IK sampler is constrained by the
requirement that the IK solutions must be collision free, then
solutions for only a subset of the target transforms are found.

\include ex-ik-reachable.cpp

# C++ shared pointer conventions # {#sec_rw_manual_pointer_conventions}

The \b RobWork libraries make extensive use of non-copyable objects
(such as object referred to by interface) shared by pointer between
different algorithms. Ownership of objects is managed by the shared
pointer type rw::common::Ptr. If an object needs access to a
non-copyable object, the constructor of the object will conventionally
take a rw::common::Ptr type as parameter.

Classes that are commonly referred to by shared pointer define a
shortcut for this pointer type. If the class is named \e T, the name
of the pointer type will be \e T::Ptr, and the type of the pointer will
be rw::common::Ptr<T>:

\include ex-typedef-t-ptr.cpp

Here are some examples of these such pointer types:

- rw::math::QMetric::Ptr
- rw::models::WorkCell::Ptr
- rw::proximity::CollisionDetector::Ptr
- rw::pathplanning::QSampler::Ptr
- rw::pathplanning::QToQPlanner::Ptr

Here are some examples of constructor functions for such objects:

- rw::math::MetricFactory::makeEuclidean()
- rw::proximity::CollisionDetector::make()
- rw::pathplanning::QSampler::makeUniform()
- rwlibs::pathplanners::RRTPlanner::makeQToQPlanner()

The rw::common::Ptr type differs from standard shared pointer
implementations by allowing the pointer to refer to a stack allocated
object or another object for which an entity has already taken
the full ownership. To make the use of such objects easy, a
pointer to \e T can be implicitly converted to Ptr<T>, but the
implicitly constructed rw::common::Ptr type \e does \e not take
ownership of the object. If the rw::common::Ptr type should take
ownership of the entity, you must explicitly call the
rw::common::ownedPtr() function. This example illustrates the idiom:

\include ex-owned-ptr.cpp

In everyday programming, the construction of rw::common::Ptr types is
managed by the constructor functions for the various objects. Only if
you write your own extensions for interfaces in \b RobWork will you
need to explicitly call rw::common::ownedPtr().

# RobWork Task Format # {#sec_rw_manual_task}
RobWork includes an abstract task format which can be used to represent, save and 
load tasks. The basic rwlibs::task::Task is templated and can either store 
rw::math::Q or rw::math::Transform3D as targets. 

A task in RobWork is basically a 2-tuple which can be described as
~~~~~{.cpp}
Task={(Target)*, (Motion|Action|Task)*}
~~~~~

The elements in a task are
- *Target*: Typically representing either a Cartesian pose or a robot configuration using rw::math::Transform3D and rw::math::Q, respectively.
- *Motion*: Describes a motion/transition between targets. A target may be shared among any number of motions.
- *Action*: Has no fixed interpretation and can be used to specify events such as open/close gripper, acquire image or as synchronization point.
- *Task*: Tasks are recursive. Subtasks may be shared among multiple tasks.

The example below illustrated how to construct a small task, prints out the task, saves it to file, reloads it and prints it once again.

\include ex-task.cpp

# Threading # {#sec_rw_manual_threading}
When developing code that can run in parallel it is encouraged that the RobWork rw::common::ThreadPool concept is used.
The ThreadPool provides a flexible way for the user to specify the number of threads that should be used in multi-threaded applications.
By adding work to a ThreadPool instead of launching separate threads, the user has the ability to limit the resources used by the application.
At the same time the application is able to efficiently utilize the given resources.

The following example shows how a rw::common::ThreadPool can be created, and how work is added to the queue.
The work added to the pool is handled in the order it is added. In this example a list of arguments can be given from commandline.
The first argument is the number of threads to use (beside the main thread itself). Followed by that is an arbitrary number of image filenames.
The example will then try to load the image files in parallel according to the number of threads given by the user. Note that zero threads
is valid, as this would cause all work to be executed directly in the main thread. Work will in this case be executed directly in the addWork function.
To avoid that the program ends before work has finished, the waitForEmptyQueue() function will block until there is no more work available.

In the loadFile function the isStopping() method is checked. If the rw::common::ThreadPool is stopped before work has finished,
the work added to the pool should check the isStopping() function at regular intervals to allow the application to shutdown gracefully.
This is especially important in long running tasks.

\include ex-threadpool.cpp

When writing multi-threaded applications one often need to branch out into many parallel tasks, then wait for the tasks to finish and finally combine
the results. Then one might need to branch out yet again into new parallel tasks based on the result. Also each parallel task might be able to
parallize its work into even more subtasks. This can in principle happen in a hierachy where each subtask can have its own parallel subtasks and so forth.

To facilitate easy programming of such types of tasks, the rw::common::ThreadTask can be used. The following shows the same example as before but
instead implemented by the use of the rw::common::ThreadTask type.

Consider the LoadTask class that inherits from rw::common::ThreadTask. The LoadTask class is constructed with a filename that should be loaded.
In the run function the main work takes place - here the file is actually loaded, and the result can afterwards be retrieved with the getImage function.

The MainTask class also inherits from rw::common::ThreadTask. This task is responsible for launching a LoadTask for each file given as input to the
program. This class does not do much work in its run function. It only constructs all LoadTasks and add these as subtasks to the MainTask. The subtasks
starts running as soon as they are added, and when each subtask finishes, the subTaskDone function is called. Here the result of the subtask is simply
stored. If it was desired, new tasks could also be launched based on the achieved result. When there are no more subtasks running, the idle function is
called. The idle function is the last chance to add new subtasks, otherwise the task will end and the done function will be called. When done is called
the task is finished, and it is not possible to add more subtasks. If this task then has a parent task, the parent tasks subTaskDone will be executed.
It is possible to change the behaviour of a rw::common::ThreadTask such that it does not finish after the idle function is called. By enabling the keep-alive
option the task will stay in the idle state until the keep-alive is disabled or new subtasks are added. Be careful with this option. If the task does
not end, the parents will not end either.

The main function is almost as before. This time a MainTask is created that uses the ThreadPool to add its work to. When the execute function is called
the work is added to the pool and execution starts. By using the waitUntilDone function the main loop will not end before the MainTask has finished.

Note that multiple separate tasks and worker function can use the same pool at the same time.

As the ThreadPool is able to run with zero threads (executing directly in the main thread), so is the ThreadTask. If zero threads are used, the complete
task will be done at the time execute returns. It is however not recommended to use zero threads with the ThreadTask. Internally this will cause a
large recursion depth, and will inevitably cause problems with the stack size at some point. 

\include ex-threadtask.cpp

# RobWorkStudio # {#sec_rws_manual_intro}
The main goal of RobWorkStudio is to implement functionality for vizualising
a RobWork workcell and to implement a plugin infrastructure that enables easy
installation of user functionality.
 
*RobWorkStudio* is simple and convinient front-end for visualizing
RobWork Workcells and their operation.

RobWorkStudio is developed at the <a
href="http://www.mip.sdu.dk/robotics">robotics department</a> of the
<a href="http://www.sdu.dk/mmmi">Maersk McKinney Moller Institute</a>
at the <a href="http://www.sdu.dk">University of Southern
Denmark</a>. The focus of the department is on industrial robots and
their applications.

##  Default RobWorkStudio plugins ## {#sec_rws_plugins}
Plugins in RobWorkStudio define the functionallity wether it be native plugins
or user defined plugins.

### The Jog plugin ### {#sec_rws_plugins_jog}
Provides functionality for jogging around the robots in a workcell.

### sec_rws_plugins_log The Log plugin ###
Displayes the default log in RobWorkStudio

### sec_rws_plugins_treeview The TreeView plugin ###
Shows the frame structure of the workcell.

### sec_rws_plugins_lua The Lua plugin ###
Provides a simple editor for writing and executing lua scripts.

### sec_rws_plugins_planning The planning plugin ###
Enables the user call motion planners and plan paths.

### sec_rws_plugins_propertyview The propertyview plugin ###
The propertyview can be used to display and edit properties associated to frames in the workcell.

### sec_rws_plugins_playback The playback plugin ###
This plugin enables recording and playback of TimedStatePaths.

### sec_rws_plugins_sensor The Sensors plugin ###
This plugin can display output from simulated camera and range scanners in the workcell.

##  Creating your own plugin ## {#sec_rws_user_plugins}
To create your own plugin copy one of the example plugins which can be found within the example
directory under RobWorkStudio. The pluginUIapp provides an example in which QT designer (GUI editor)
is used to design the user interface. The pluginapp provides a simple example without the dependency
of a GUI building tool.

To compile the plugin you need to perform the following steps

- Edit the CMakeLists.txt file to ensure that the variables "RW_ROOT" and "RWSTUDIO_ROOT" points to you RobWork and RobWorkStudio directories.
- call "cmake ." to generate build files
- call "make" to build the plugin.

Once the plugin is build you need to tell RobWorkStudio to load it. This is done by editing the RobWorkStudio.ini file. If the RobWorkStudio.ini file does not exist you can copy the RobWorkStudio.ini.template from the bin directory. Within the template file you may have to remove the existing plugins and add the following

	MyPlugin\DockArea=1
	MyPlugin\Filename=libmyplugin
	MyPlugin\Path=../../MyPlugin/
	MyPlugin\Visible=false

Be sure that the MyPlugin\\Path points to where your library has been generated and that
MyPlugin\\Filename is correct. You should not add any file extension (this is resolved automatically).

When you start RobWorkStudio it will load your plugin.

## Tips ## {#sec_rws_user_tips}

Here are some small usefull examples that can be used from a plugin

Get the collision detector that is currently used in your robwork studio
instance
~~~~~{.cpp}
CollisionDetector *detector = getRobWorkStudio()->getCollisionDetector();
~~~~~

### Communicating between plugins ### {#sec_rws_plugin_communication}
RobWorkStudio has a number of event which can be used by the plugins. A plugin can register for an event, for example by

~~~~~{.cpp}
getRobWorkStudio()->stateChangedEvent().add(boost::bind(&MyPlugin::stateChangedListener, this,_1), this);
~~~~~
which binds the stateChangedListener method of MyPlugin to listen for state changed event.

To see more information about the different event please consult the RobWorkStudio api-doc.

## RobWorkStudio specific frame properties ## {#sec_rws_properties}

Through generic properties in the XML and TUL workcell file format, RobWork allows
for adding user specific information to frames. In this section RobWorkStudio specific
properties will be listed. Meaning properties that only makes sence for RobWorkStudio and
not RobWork.

### Camera property ### {#sec_rwstudio_camera_property}
A property describing a camera pinhole model can be added to a frame. The camera view can
then be visualized in RobWorkStudio. The property string looks like this:
\verbatim
"<Field of view Y> <width> <height>"
\endverbatim
example:
\verbatim
<Property name="Camera">60 640 480</Property>
\endverbatim

You can currently only change views between cameras using the key [1-9], were 1 is the default
3rd person view.

\b Important!
- Multiple cameras are supported but only one camera property per frame!
- The width and height has no real dimension its the proportion between them that matters
- The camera looks in the negative Z-axis direction of the frame
- Field of view is in degree and is defined in the Y-axis

## Usefull examples ## {#sec_rws_examples}

### Adding new frames to the workcell from a plugin ### {#subsec_rws_examples_adding_new_frames}
 This example describe how one can add his own frames to the workcell through
 a user plugin.

 Adding frames to the workcell is possible through the StateStructure instance that
 is located in a WorkCell. It is important to understand that adding frames to the
 state structure will change the static state structure of the workcell (the dynamic state is that
 which is located in the State object). Changing the static structure will not directly influence
 State objects, that is they are still valid for all frames except the newly added frames.
 There exist two methods of making an old state valid for new frames. One is to just assign
 the old state with a new one. Though, this will also overwrite any state information that was
 saved in the old state, say the configuration of tour robot. If you want to preserve the information
 in the old state and still make it valid for newly added frames you would need to upgrade it. You
 can upgrade a state \b oldstate using either StateStructure instance \b stateStruct or another
 state \b newstate. Following is an example of how:
~~~~~{.cpp}
    // using another state to upgrade
    oldstate.upgradeTo(newstate); // oldstate is upgraded to the structure of the newstate
    // using state structure to upgrade
    oldstate = stateStruct.upgrade( oldstate );
~~~~~

Following is an example of how to add a new frame to the workcell from your own plugin
~~~~~{.cpp}
    State oldState; // this is your old state
    Frame *newFrame = make_new_frame(); // create your frame
    getRobWorkStudio()->getWorkcell()->getStructure()->addFrame(newFrame,parentFrame);
    // now update the oldState with the new state
    oldState = getRobWorkStudio()->getWorkCell()->getStructure()->upgradeState(oldState);
    // now this is VERY important, remember to update the RobWorkStudio state
    getRobWorkStudio()->setState(oldState);
~~~~~

### Adding drawables from a plugin ### {#subsec_rws_examples_adding_drawable}
This example describe how one can add his own drawable to the robwork scene graph, from
his own robworkstudio plugin.
First we need to create the drawable, next we need to find the frame we want to
connect it too, and lastly add it to the WorkCellGLDrawer of RWStudio. The following
code snippet show the creation of a user specified render which is used to construct
a drawable. One could also use the DrawableFactory to create a drawable from either
file or a primitive string (Cube,Box,Cylinder etc.). Next a frame called "myFrame" is
searched for in the workcell. If the frame is found then a mapping from myFrame to
the user drawable is created in the WorkCellGLDrawer (SceneGraph).

~~~~~{.cpp}
    MyRender *renderObj = new MyRender( .. );
    Drawable *drawableObj = new Drawable(boost::shared_ptr<Render>(renderObj));
    Frame *myFrame = getRobWorkStudio()->getWorkCell()->findFrame("myFrame");
    if(drawableFrame != NULL)
        getRobWorkStudio()->getWorkCellGLDrawer()->addDrawableToFrame(myFrame, drawableObj);
~~~~~

### Adding collision models from a plugin ### {#subsec_rws_examples_adding_collision}

~~~~~{.cpp}
    double scale = 1.0; // set a scale, actually not used in RobWork yet
    Transform3D<> transform = makeMyTransform();
    CollisionModelInfo info("myname", transform, scale);

    Accessor::collisionModelInfo().get(*myFrame).push_back(info);
~~~~~

### Getting drawables from a frame ### {#subsec_rws_examples_getting_drawables_of_a_frame}

This code snippet will copy all drawables associated with the frame \b frameWithDrawables
into the vector \b drawables.
~~~~
    std::vector<Drawable*> drawables;
    Frame *frameWithDrawables; // specify the frame where your drawables are placed
    getWorkCellGLDrawer()->getAllDrawables(state, frameWithDrawables, drawables);
~~~~

The next code snippet will copy all drawables associated to any frame in the workcell
into the vector \b drawables.
~~~~~{.cpp}
    std::vector<Drawable*> drawables;
    getWorkCellGLDrawer()->getAllDrawables(state, getWorkCell(), drawables);
~~~~~

# RobWorkSim #

## Introduction ##
\b RobWorkSim is a dynamic simulation framework in C++ developed as an add-on for RobWork and RobWorkStudio.
RobWorkSim is used for research and education as well
as for practical robot applications. Features of the library include:

- Dynamic modeling of various types of industrial manipulators.
- Grasp table generation for grasp planning applications.
- Simulation of tactile sensors as well as all sensors supported by RobWork (Vision and Range scanners)
- Resting pose calculations
- Stable configuration calculations
.

Target audience of RobWorkSim is:
- Implementers who needs a framework for process simulation or validation of algorithms

RobWorkSim is developed at the <a
href="http://www.mip.sdu.dk/robotics">robotics department</a> of the
<a href="http://www.sdu.dk/mmmi">Maersk McKinney Moller Institute</a>
at the <a href="http://www.sdu.dk">University of Southern
Denmark</a>. The focus of the department is on industrial robots and
their applications.

### Namespaces ### {#sec_rwsim_namespaces}

The header files of RobWorkSim are distributed across a number of
directories each having its own namespace. The structure of namespaces
reflects the directory containing the code. For example

~~~~~{.cpp}
// Include header files:
#include <rwsim/dynamics/RigidBody.hpp>
#include <rwsim/control/PDController.hpp>

using namespace rwsim::dynamics;
using namespace rwsim::PDController;
~~~~~

This structure is the same as RobWork and RobWorkStudio.

### Libraries ### {#sec_rwsim_libraries}

### Install and Use ### {#sec_rwsim_install_and_use}

Functionality in RobWorkSim depends heavilly on RobWork and RobworkStudio for GUI and specific plugins.
As such, it is recommended to install these before installing RobWorkSim.

## Concepts and Overview ## {#sec_rwsim_consepts}

The primary use of RobWorkSim evolves around specifying a DynamicWorkCell (scene with
dynamic information) from which a Simulator instance is created which then is used
to do the actual simulation.

The DynamicWorkCell is conceptually the same as the RobWork WorkCell class and extends
the WorkCell description
with focus on describing the dynamic properties of the scene. It is basically a container
that includes a hierarchy description of the scene including: bodies, obstacles, frames,
devices, controllers, sensors and their mutual attachment to each other.

The DynamicWorkCell is "stateless" in the same sense that the WorkCell is stateless, which
means that typical state values such as force of a rigid body are saved in a state structure
and not in the actual object. The following code snippet exemplifies this:

~~~~~{.cpp}
RigidBody *b1 = getBody1(); // illustrative function "getBody1()"
State stateA = getState();
State stateB = getState();
b1->setForce( Vector3D<>(0,0,1), stateA );
b1->setForce( Vector3D<>(2,2,2), stateB );
std::cout << b1->getForce(stateA); // prints (0,0,1)
std::cout << b1->getForce(stateB); // prints (2,2,2)
~~~~~

Not all variables of our "stateless" objects are saved in the state structure since
they are considered to change infrequently. An example of this is getMass() on RigidBody.
As such a rule of thumb is that frequently changing variables such as position, velocity
and force will allways be saved in the state structure. Infrequently changing variables
will be saved in the object instance, e.g. mass, material info, geometry, nr of joints,
position limits, force limits and so on.

The stateless nature of DynamicWorkCell makes it possible to use it in multiple threads
or methods at the same time and without bothering with cloning and copying of the
DynamicWorkCell. However, one should be carefull to change the "static" variables when
using multiple threads since these changes will influence all uses of the variable. For
more indepth description of the StateStructure the reader is directed to the RobWork manual.

Now the DynamicWorkCell can be constructed in c++ or as is done more often through the
XML based DynamicWorkCell file format described in section \ref sec_rwsim_xml_fileformat.
A Simulator is created with an instance of the DynamicWorkCell and is then ready for use.
A typical use is exemplified below:

~~~~~{.cpp}
// create and initialize simulator
DynamicWorkCell::Ptr dwc = getDynamicWorkCell();
DynamicSimulator *sim = makeSimulator( );
sim->initPhysics( dwc );
// set the current state
sim->resetState( initState );
// now do a simulation
while( someStopCriteria ){
  // apply forces/velocities to bodies and devices using controllers
  sim->step( 0.01, state);
  // monitor contacts and states using sensors or the State
}
// do something usefull with "resting" state
~~~~~

The Simulator is not stateless and to do simulations in parallel you should create
multiple instances of the simulator.

The simulation is run one step at the time using relatively small timesteps e.g.
[0.001s;0.01s]. The "best" timestep depends on the underlying physics engine,
the current scene, and the application. Please look at section \ref sec_rwsim_simulator
for more information.

There are two constructs designed for getting feedback and influencing the simulation.
These are the SimulatedSensor and the SimulatedController. The controller enables
"control" of bodies and devices or other states in the simulation, where as the sensor
enables getting appropriate feedback, e.g. tactile, visual or other states. Typically
used methods such as applying forces to bodies or setting the velocity of a device
are available on the Body/Device interface and does not require controllers or sensors.

## DynamicWorkCell ## {#sec_rwsim_dynamic_workcell}

## The DynamicSimulator ## {#sec_rwsim_simulator}
Timestep, ThreadSimulator, PhysicsEngine, PhysicsEngineFactory, EnableBody,

The simulation loop

## Body ## {#sec_rwsim_body}

## Devices and controllers ## {#sec_rwsim_dynamic_device}

## DynamicWorkcell Scene File ## {#sec_rwsim_xml_fileformat}

### Material identifier ###
Per body/object

### Friction data specification ###

### Contact data specification ###

## Plugins ## {#sec_rwsim_plugins}

# RobWorkHardware #
RobWorkHardware is a sub package of RobWork. Its main function is to provide an interface/driver
layer for real hardware.

The package is structured into several modules which each can be enabled or disabled.
This structure has been chosen because of the multiple external dependencies and because one
typically only use few of the modules at a time.

The various external dependencies also mean that the license of some modules differ from the
general RobWork license. In such a case this will be explicitly noted in the module headers as well as
in the module documentation.

Currently driver wrappers/interfaces exist for cameras, CAN devices, serial port,
weiss tactile sensors, swissranger and various robots such as the SDH, PA10 and PowerCube.

# XML WorkCell File Format #
\subpage page_xml_workcell_format

# TUL file format (deprecated) # 
\subpage page_tul

# Tasks #
\subpage page_task

# Scene Graph #
\subpage page_scenegraph

# Lua #
\subpage page_lua

# Code Guidelines # 
\subpage page_coding_guidelines
