skyellen/robwork-mirror/doc/installstuff/Readme.txt

Stuff for installing RobWork, creating packages, and documentation.
