skyellen/robwork-mirror/doc/installstuff/RW_package-mingw/README.txt

environment variables to set

ROBWORK_ROOT = <thispath>\workspace\RobWork
ROBWORKSTUDIO_ROOT = <thispath>\workspace\RobWorkStudio
ROBWORKHARDWARE_ROOT = <thispath>\workspace\RobWorkHardware

MINGW_ROOT = <thispath>\MinGW\
XERCES_ROOT = <thispath>\xerces-c_2_8_0-mingw-msys\
BOOST_ROOT = <thispath>\boost_1_39_0
