skyellen/robwork-mirror/doc/ressources/installation_cmake.hpp.md

CMake Options & Environment {#page_rw_installation_cmake_options}
============ 

It is possible to customize the RobWork installation through various CMake options.
RobWork has many dependencies, of which many are optional. It is important to ensure that CMake finds the correct optional dependencies to enable certain parts of RobWork. 
Here we will give an introduction to the CMake system and the most relevant options.
We will also provide some information about how to control where CMake searches for the dependencies.

<b>THIS PAGE IS STILL BEING WRITTEN</b>
