skyellen/robwork-mirror/doc/tutorials/tutorials.hpp.md

Tutorials  {#page_rw_tutorials}
=========

[TOC]

# Introduction #
All tutorials go into this page

Tutorial 						| Description
--------------------------------|-----------
@subpage pageRobworkPrimer | Basic tutorial to get into c++ interfaces in RobWork 
@subpage pageRobworkPlugins			| Tutorial that demonstrate how to use the plugin/extension functionality in RobWork
@subpage pageRobWorkStudioPlugins | Basic tutorial in getting an RobWorkStudio GUI plugin implemented
@subpage pageRobWorkSimPrimer | Basic toturial on getting dynamic simulation running
