skyellen/robwork-mirror/doc/ressources/usermanual.hpp.md

User Manual  {#page_rw_usermanual}
============

[TOC]

# Introduction #
