skyellen/robwork-mirror/doc/manual/scenegraph.hpp.md

RobWork SceneGraph design  {#page_scenegraph}
=========================

[TOC]

# Overview #
- scenegraph is an interface, a concrete implementation is needed
- rwlibs/opengl an concrete implementation
- render opengl context
- SceneGraph vs SceneViewer
- SceneNode, SceneCamera, Scene
