skyellen/robwork-mirror/doc/gfx/assembly/ATaskVisPlugin.png

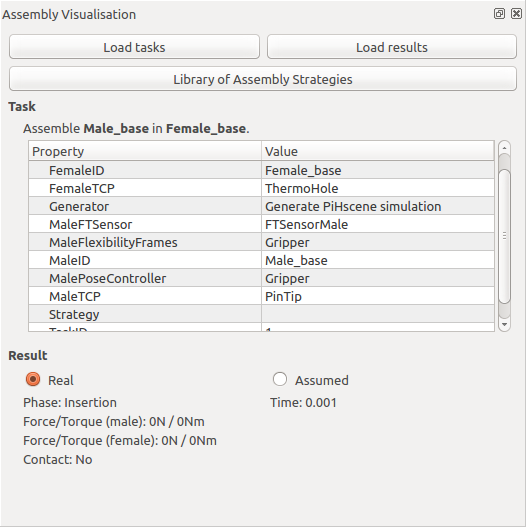
doc/gfx/assembly/ATaskVisPlugin.png
