skyellen/robwork-mirror/doc/gfx/assembly/PiHStrategy.png

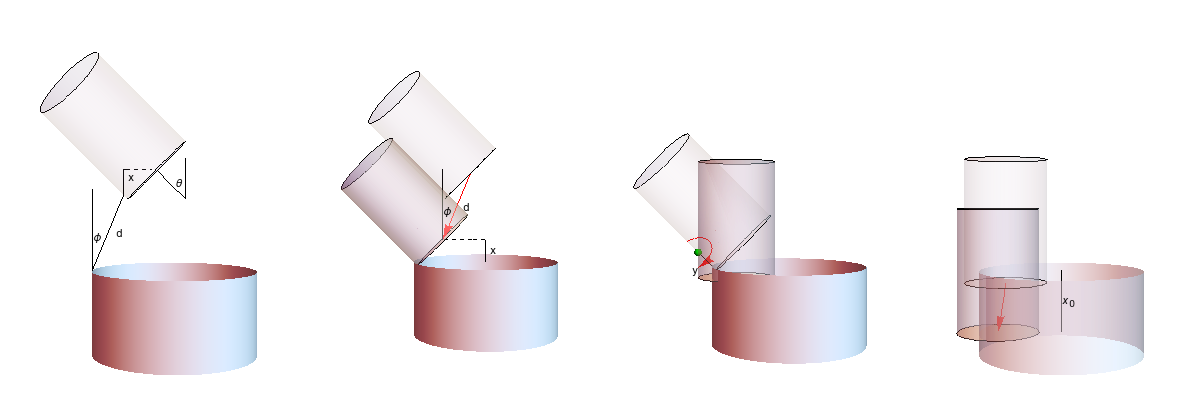
doc/gfx/assembly/PiHStrategy.png
