skyellen/robwork-mirror/doc/gfx/assembly/SpiralStrategy.png

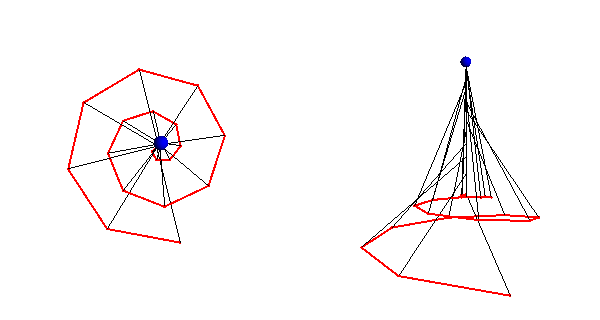
doc/gfx/assembly/SpiralStrategy.png
