skyellen/robwork-mirror/doc/gfx/assembly/StrategyLibraryDialog.png

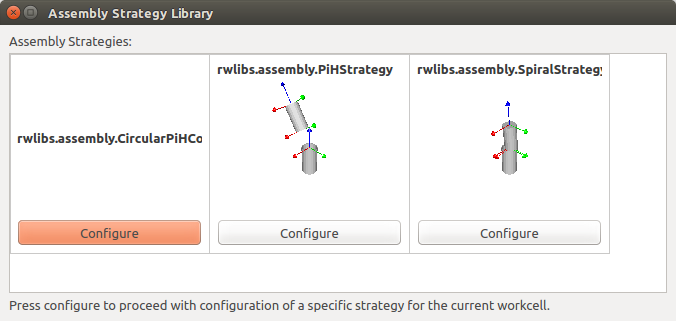
doc/gfx/assembly/StrategyLibraryDialog.png
