skyellen/robwork-mirror/doc/gfx/assembly/TaskSetupDialog.png

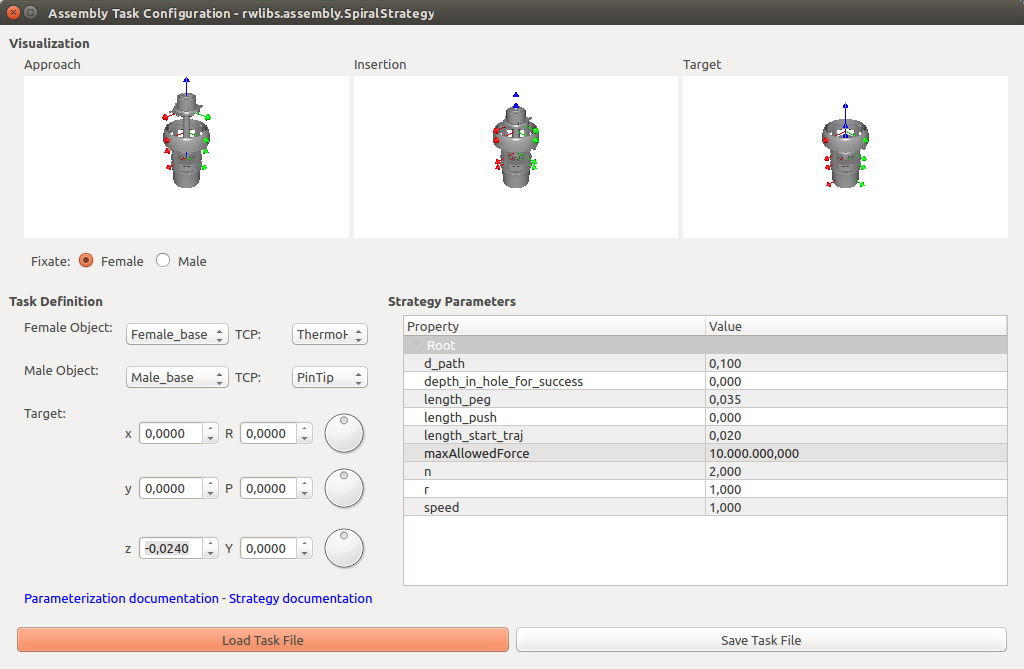
doc/gfx/assembly/TaskSetupDialog.png
