skyellen/robwork-mirror/doc/gfx/installation/Boost_layout.png

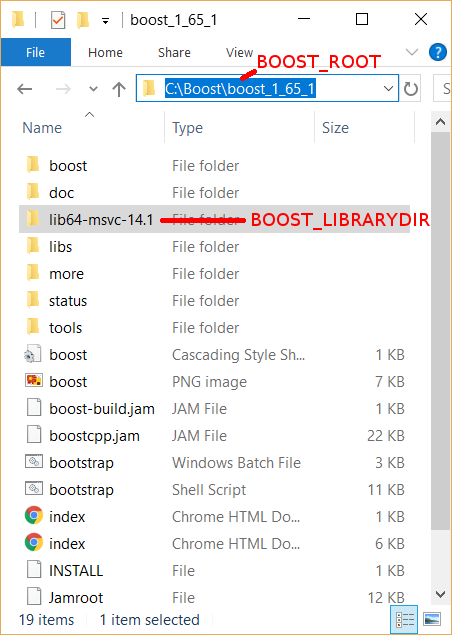
doc/gfx/installation/Boost_layout.png
