skyellen/robwork-mirror/doc/gfx/installation/Bullet_layout.png

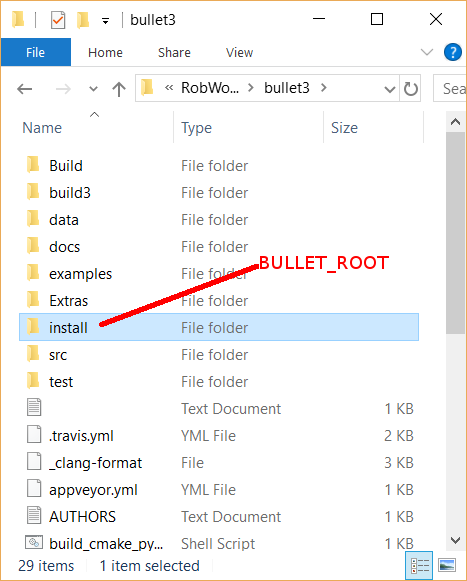
doc/gfx/installation/Bullet_layout.png
