skyellen/robwork-mirror/doc/gfx/installation/CMake_PATH.png

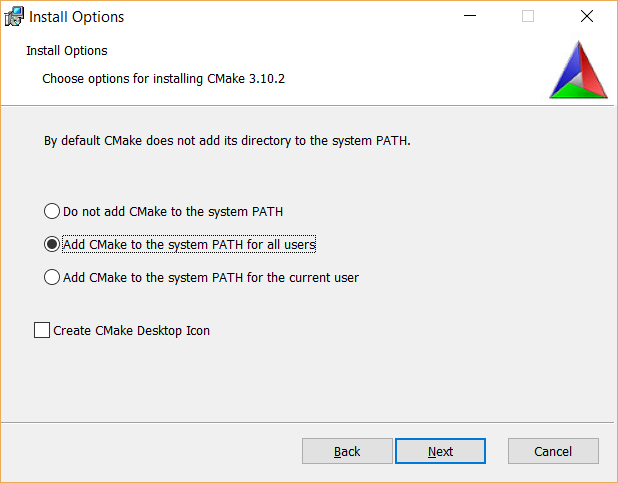
doc/gfx/installation/CMake_PATH.png
