skyellen/robwork-mirror/doc/gfx/installation/Git_PATH.png

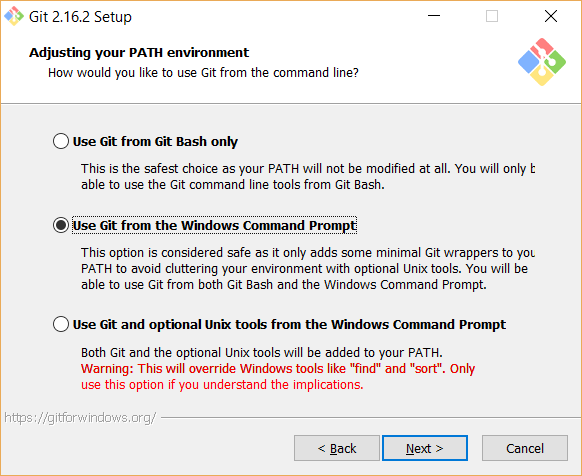
doc/gfx/installation/Git_PATH.png
