skyellen/robwork-mirror/doc/gfx/installation/GTest_clone.png

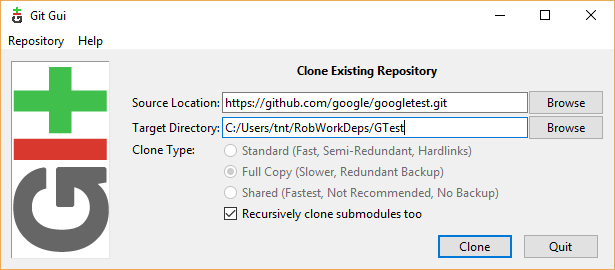
doc/gfx/installation/GTest_clone.png
