skyellen/robwork-mirror/doc/gfx/installation/GTest_layout.png

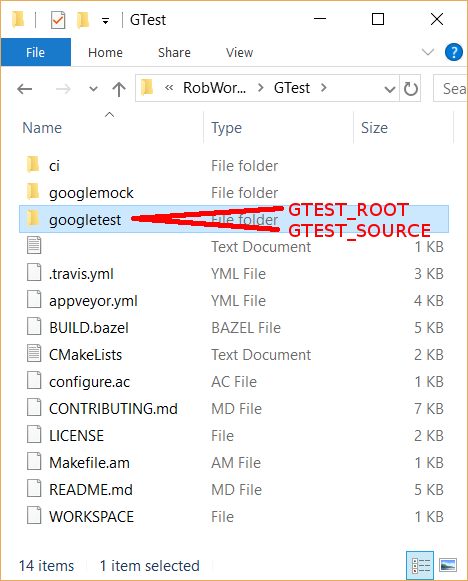
doc/gfx/installation/GTest_layout.png
