skyellen/robwork-mirror/doc/gfx/installation/ODE_clone.png

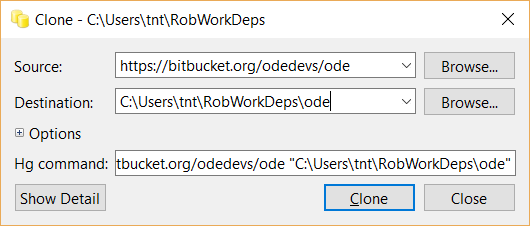
doc/gfx/installation/ODE_clone.png
