skyellen/robwork-mirror/doc/gfx/installation/ODE_layout.png

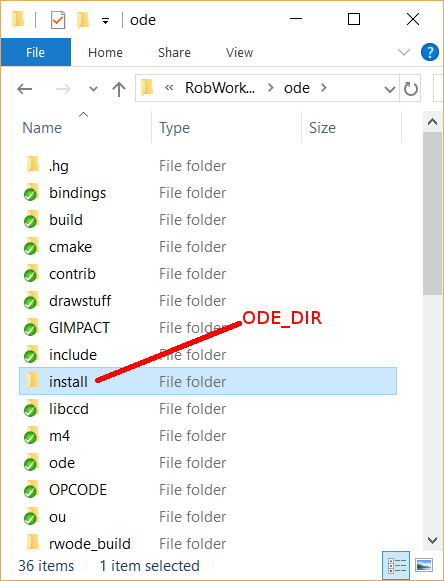
doc/gfx/installation/ODE_layout.png
