skyellen/robwork-mirror/doc/gfx/installation/Qt5_layout.png

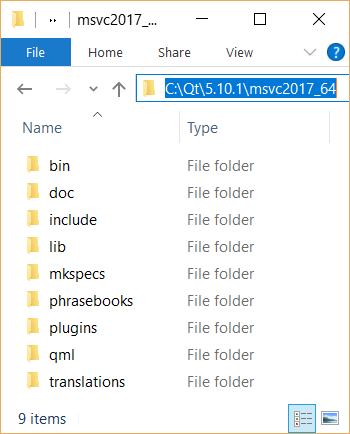
doc/gfx/installation/Qt5_layout.png
