skyellen/robwork-mirror/doc/gfx/installation/RW_checkout.png

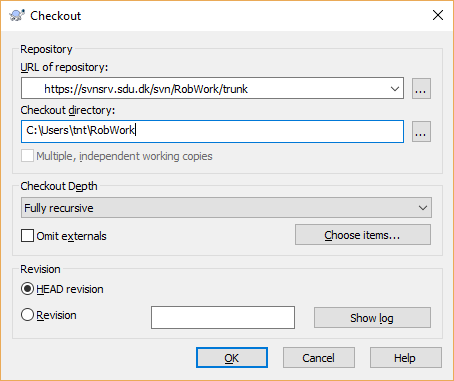
doc/gfx/installation/RW_checkout.png
