skyellen/robwork-mirror/doc/gfx/installation/RW_cmakecmd.png

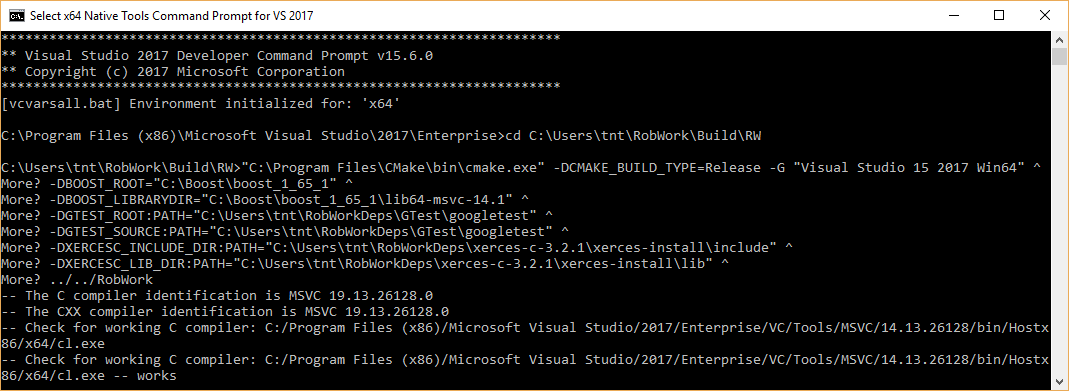
doc/gfx/installation/RW_cmakecmd.png
