skyellen/robwork-mirror/doc/gfx/installation/RW_layout.png

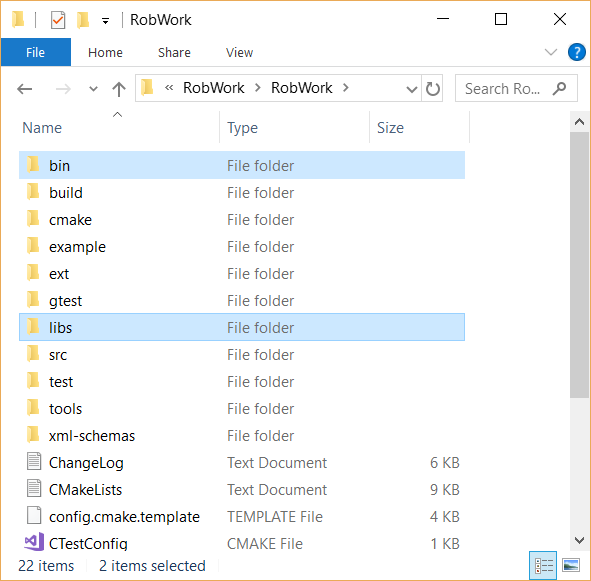
doc/gfx/installation/RW_layout.png
