skyellen/robwork-mirror/doc/gfx/installation/SCM_contextmenu.png

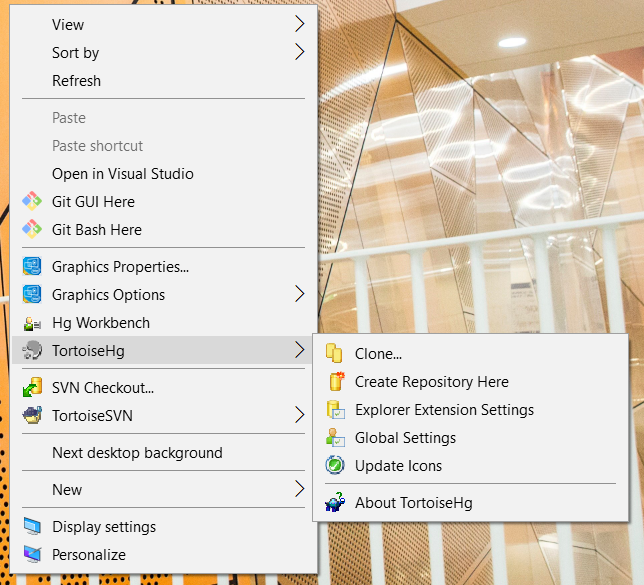
doc/gfx/installation/SCM_contextmenu.png
