skyellen/robwork-mirror/doc/gfx/installation/TortoiseHg_install.png

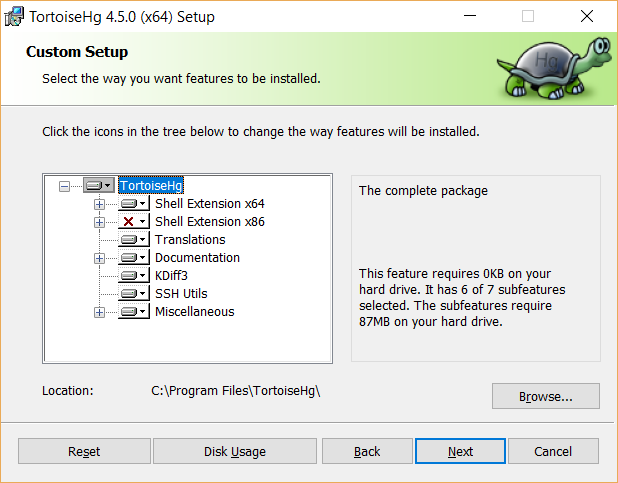
doc/gfx/installation/TortoiseHg_install.png
