skyellen/robwork-mirror/doc/gfx/installation/TortoiseSVN_addCLI.png

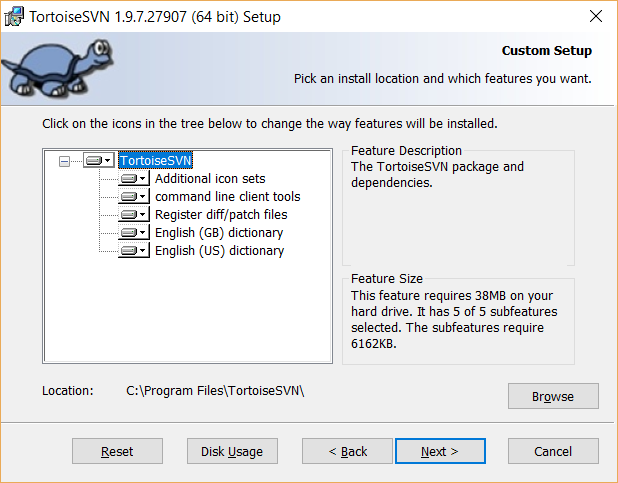
doc/gfx/installation/TortoiseSVN_addCLI.png
