skyellen/robwork-mirror/doc/gfx/installation/VS17_IDE.png

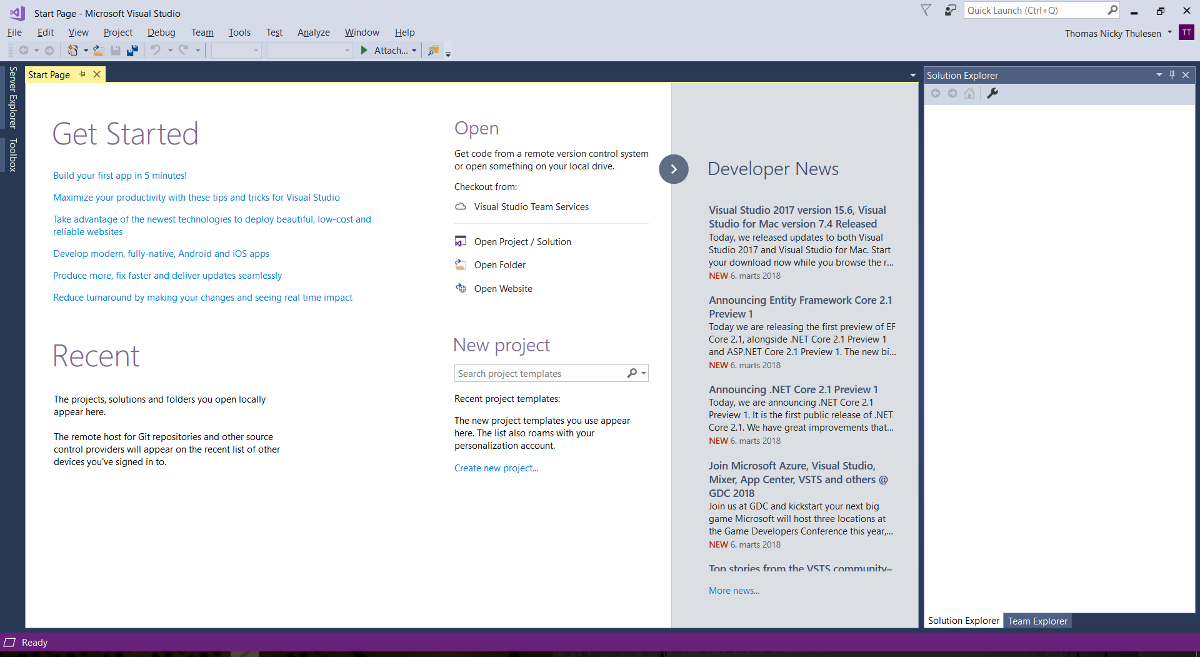
doc/gfx/installation/VS17_IDE.png
