skyellen/robwork-mirror/doc/gfx/installation/VS17_installC++.png

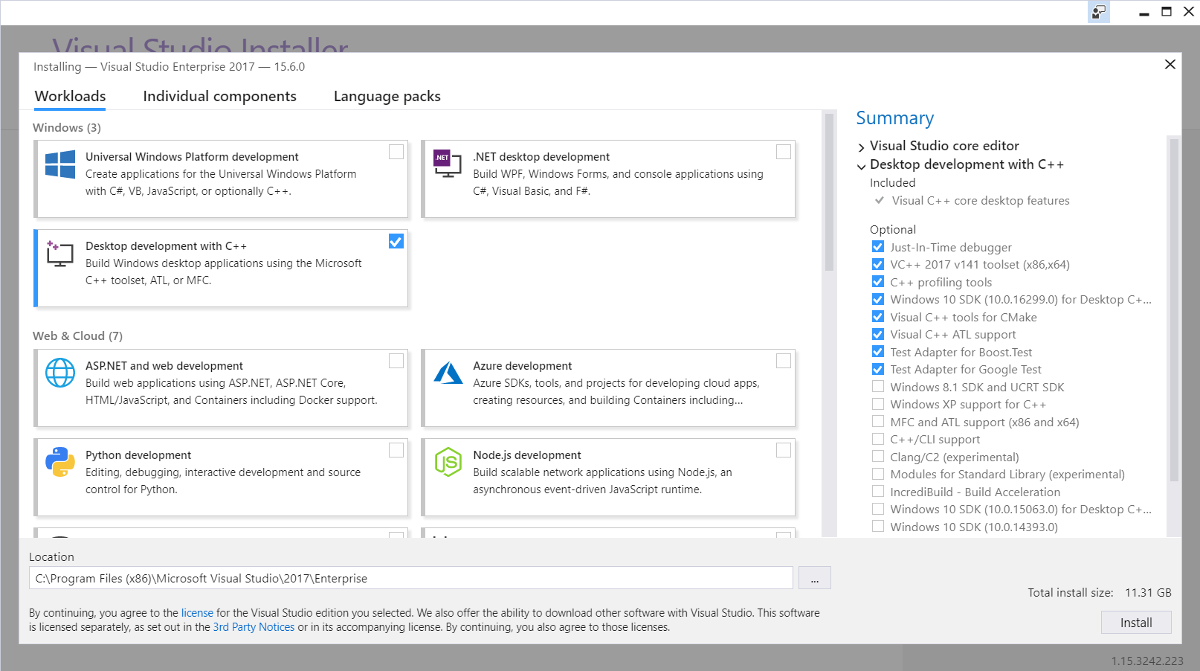
doc/gfx/installation/VS17_installC++.png
