skyellen/robwork-mirror/doc/gfx/installation/VS17_startmenu.png

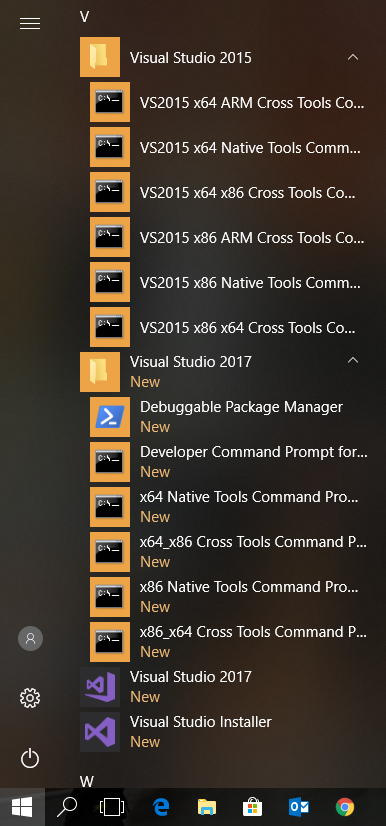
doc/gfx/installation/VS17_startmenu.png
