skyellen/robwork-mirror/doc/gfx/installation/Xerces_createbuildfolder.png

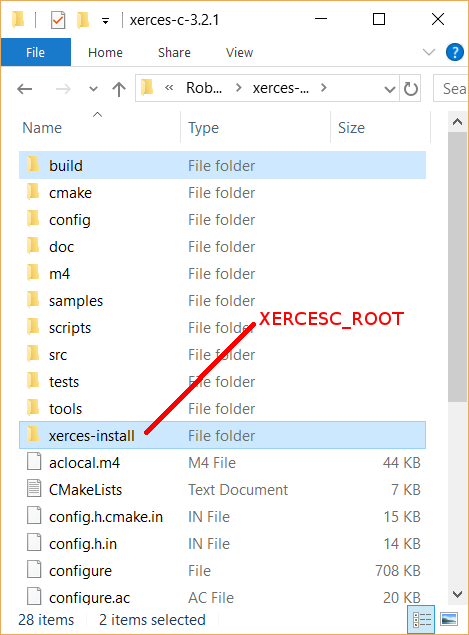
doc/gfx/installation/Xerces_createbuildfolder.png
