skyellen/robwork-mirror/doc/gfx/installation/xerces_install_1.png

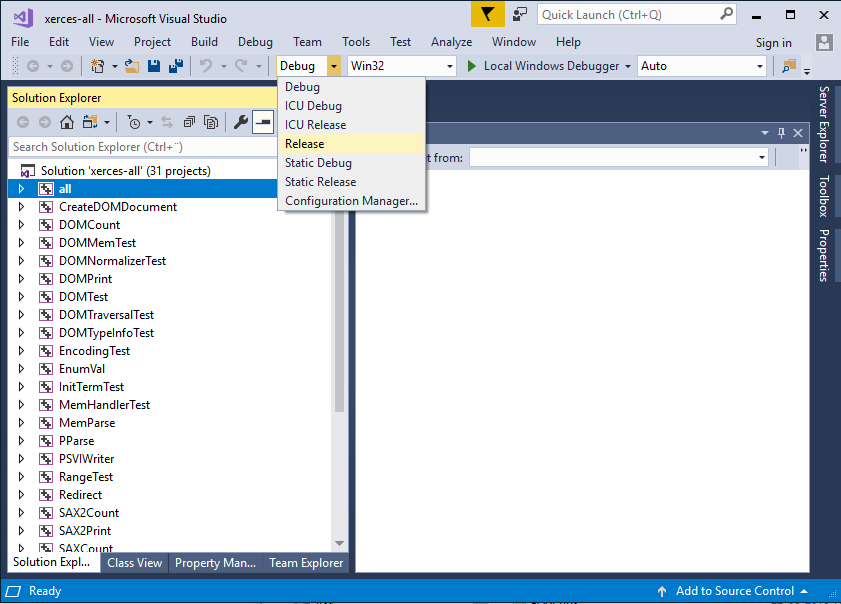
doc/gfx/installation/xerces_install_1.png
