skyellen/robwork-mirror/doc/gfx/installation/xerces_install_2.png

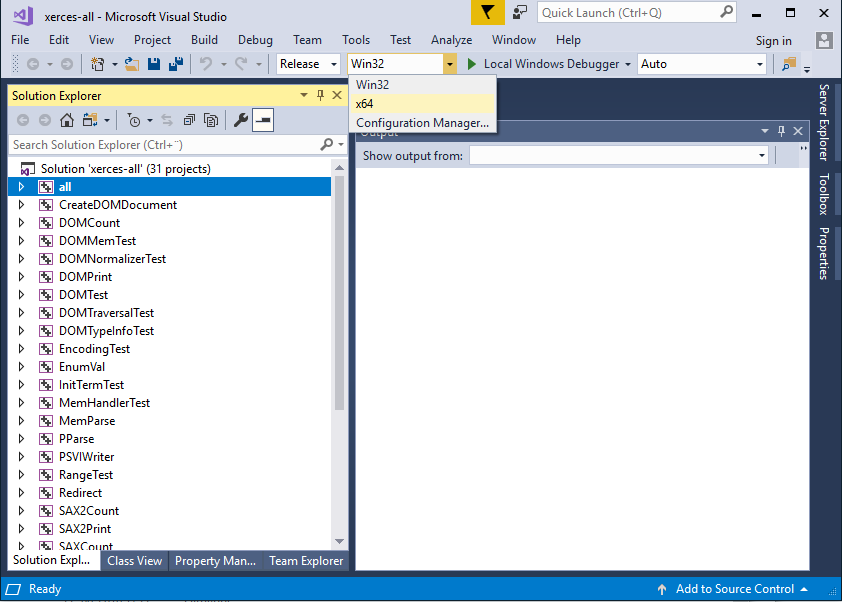
doc/gfx/installation/xerces_install_2.png
