skyellen/robwork-mirror/doc/gfx/installation/xerces_install_3.png

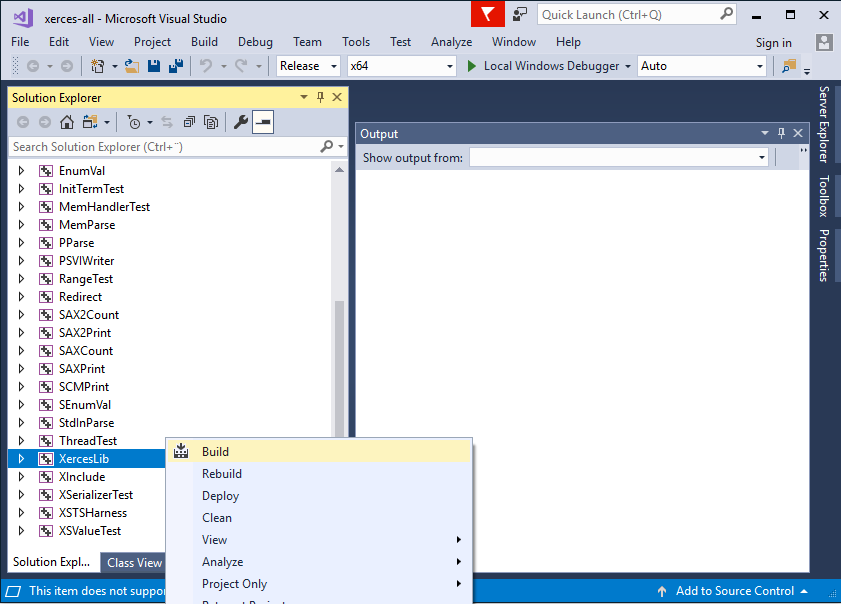
doc/gfx/installation/xerces_install_3.png
