skyellen/robwork-mirror/doc/gfx/tests/integrationGravity.gif

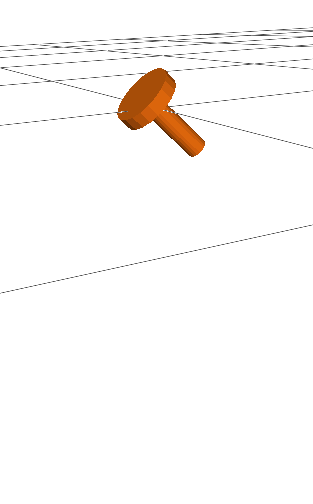
doc/gfx/tests/integrationGravity.gif
