skyellen/robwork-mirror/doc/gfx/tests/integrationRotation.gif

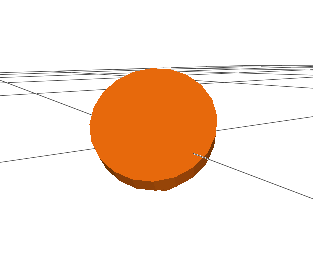
doc/gfx/tests/integrationRotation.gif
