skyellen/robwork-mirror/doc/gfx/tests/integrationSpring.gif

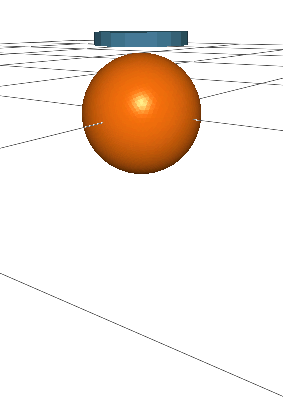
doc/gfx/tests/integrationSpring.gif
