skyellen/robwork-mirror/RobWork/test/testfiles/geoms/OrangeMarmelade_800_tex.png

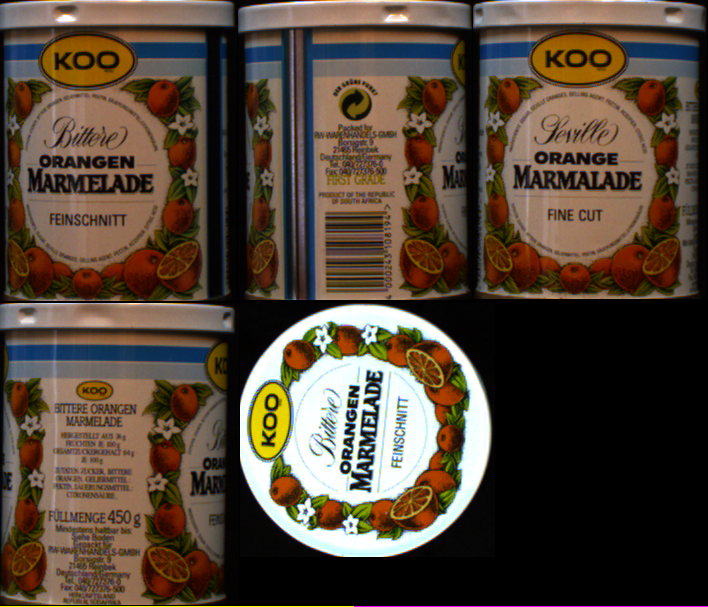
RobWork/test/testfiles/geoms/OrangeMarmelade_800_tex.png
