skyellen/robwork-mirror/RobWorkHardware/src/sandbox/falcon/ur_control_test_scene/cup/GreenCup_5k_tex.png

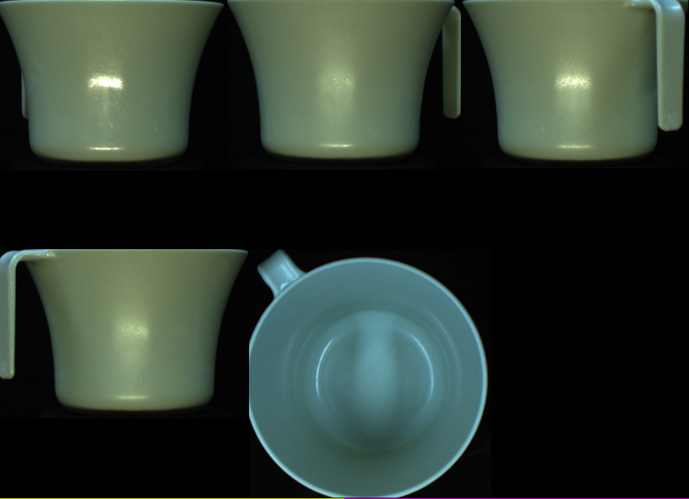
RobWorkHardware/src/sandbox/falcon/ur_control_test_scene/cup/GreenCup_5k_tex.png
