skyellen/robwork-mirror/RobWorkSim/test/testfiles/objects/rws.png

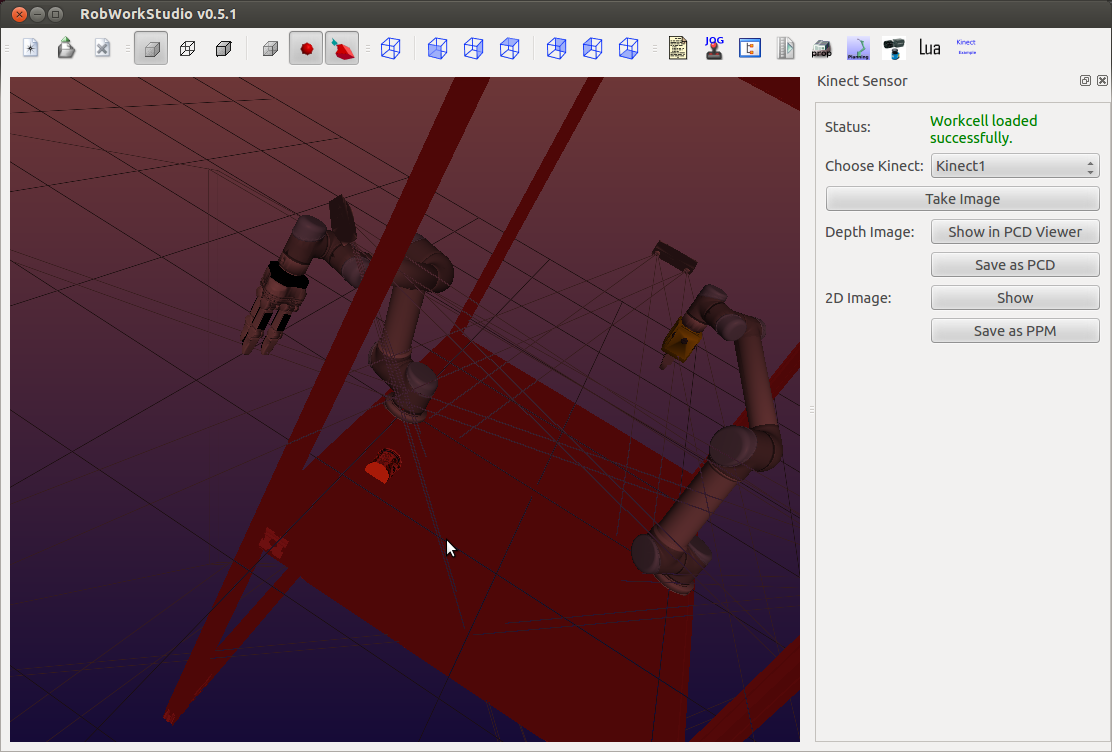
RobWorkSim/test/testfiles/objects/rws.png
