skyellen/robwork-mirror/RobWork/ChangeLog.txt

2009-26-10 (jimali)
- CollisionStrategyFactory renamed to ProximityStrategyFactory
- PathAnalyzer moved from sandbox to rw.pathplanning

2009-06-10 (jimali)
- Added caching to facearrayfactory and drawablefactory (includes timestamp of modified date)
- Proximity-,Collision-,Distance- strategy changed to allow more generic usage (though its backward compatible) 

2009-18-3 (lpe)
- Added streaming operator to rw::common::Exception

2009-27-2 (jimali)
- Total remake of the cmake structure. Multiple build trees are now supported
- Test structure changed to use boost suto tests and ctest
- configuration files renamed from RobWork.cmake to config.cmake
- boost header files removed from ext. Only bindings and experimental remains

2008-4-12 (lpe)
- Added Loader and Saver for Trajectories and Paths. The loader is dependent on Xerces, which the CMake files tests for. 
Besides these loaders/savers different utilities for converting the rw math structures to and from XML is provided.

2008-4-12 (lpe)
- Introduced rw::trajectory::Trajectory interface and renamed the old Trajectory to InterpolatorTrajectory

- Extended rw::invkin::ResolvedRateSolver with support for arbitraty end frame

2008-3-12 (lpe)
  - Updated RWXMLLoader to support Cylinders
  
2008-11-18 (lpe)
  - Removed old stuff marked as deprecated. This was mainly old static method written in 
    upper-case and a new other method ealier renamed. Unless explicitly having specified to use
    deprecated methods this does not change anything.

2008-11-17 (lpe)
  - Replaced the use of auto_ptr with rw::common::Ptr to support GCC 4.3 and corrected include's 
    also to support GCC 4.3.

2008-11-18 (jimali):
  - The XML parser now adds DHparameters (DHSet) as properties to joints that 
    are specified with dhparameters.

2008-11-17 (alauo):

  - Interface for new RRT planner variations: RRTBasic, RRTConnect,
    RRTBidirectional, RRTBalancedBidirectional.

2008-11-14 (alauo):

  - The Z3 planner of Boris Baginski.

2008-10-29 (alauo):

  - Manual section on rw::common::Ptr.

2008-10-14 (alauo):

  - ClosedFormIK::make() factory method.

2008-10-13 (alauo):

  - RevoluteJoint and PrismaticJoint are now an abstract classes. Use
    RevoluteJoint::make() and PrismaticJoint::make() to construct an
    instance.

2008-10-3 (alauo):

  - An implementation of Stefano Carpins ARW path planner.

2008-09-22 (alauo):

  - Collision detector construction optimized for the planning for a
    specific device and state.

2008-9-8 (alauo):

  - rw.getCollisionDetector() and rw.getCollisionStrategy() for Lua
    interface.

2008-8-1 (alauo):

  - New QIKSampler class.

  - Deprecated DeviceModel class removed.

2008-7-30 (alauo):

  - "Manhattan" is the correct spelling.

  - Metric<T> is now a metric on T and not a metric on
    boost::numeric::ublas::vector<T>. QMetric is a typedef for
    Metric<Q>. Use MetricFactory to construct your QMetric values.

2008-7-23 (alauo):

  - New path planner class: PlannerConstraint.

2008-7-22 (alauo):

  - New Models::getStatePath() utility functions.

2008-7-22 (alauo):

  - New or renamed path planner classes: QExpand, QEdgeConstraint,
    QToTPlanner, QToQPlanner, QToQSamplerPlanner.

  - Removal of deprecated or non-maintained classes:
    StraightLinePathPlanner, lazyprm.

  - CollisionDetector takes Ptr types as argument in the constructor.

2008-7-1 (alauo):

  - XML::printTree() utility.

  - "Smart" default collision setup removed from TUL loader.

2008-6-24 (alauo):

  - Bugfix for the TUL loader: The initial state for movable frames was
  not set.

  - New SBL path planner.

  - Abstractions for path planners: QSampler, QNormalizer,
    StateConstraint, QConstraint, StopCriteria.

  - Automatic exclusion of statically linked frames in the collision
    detector.

  - A Ptr<T> convention for passing of pointers to objects.

  - Path planners can now be aborted by a stop criteria.

  - A Models utilities file.

2008-6-8 (alauo):

  - Image takes a pointer to vector<unsigned char> as argument (and
    not a reference).

2008-6-4 (alauo):

  - ProximityStrategy::clearFrame() now required on the interface.

  - New methods CollisionDetector::setCollisionStrategy() and
    CollisionDetector::getCollisionStrategy().
    CollisionDetector::setCDStrategy() is now deprecated.

  - New methods Q::empty(), Transform3D(translation),
    Transform3D(rotation).

2008-4-28 (alauo):

  - The TUL loader now supports multiple identifiers for collision
    models and drawables.

2008-4-28 (alauo):

  - Static methods now start with a lower case letter. Many of the
    upper case methods have been removed, but the most frequently
    used have been declared deprecated.

  - Use RW_REMOVE_DEPRECATED to remove all deprecated methods.

2008-4-25 (alauo): The interface of MetricUtil has been rewritten.

2008-4-23 (alauo): Frame::getDof() is deprecated; use getDOF() like for
Device.

2008-4-23 (alauo): Rewrite and cleanup of rw::task.

2008-4-23 (alauo): Transform2D, Rotation2D and Vector2D should now be of the
same standard as the 3D classes.

2008-4-8: Added dynamic library loading in rwlibs::dll

2008-4-7: Updated Log structure in rw::common
