skyellen/robwork-mirror/doc/installstuff/ReleaseTODO.txt

- Change version info in
	- cmake files
	- doxyfiles
