skyellen/robwork-mirror/RobWorkSim/src/rwsimlibs/ode/ODETactileSensor.cpp

/********************************************************************************
 * Copyright 2009 The Robotics Group, The Maersk Mc-Kinney Moller Institute,
 * Faculty of Engineering, University of Southern Denmark
 *
 * Licensed under the Apache License, Version 2.0 (the "License");
 * you may not use this file except in compliance with the License.
 * You may obtain a copy of the License at
 *
 *     http://www.apache.org/licenses/LICENSE-2.0
 *
 * Unless required by applicable law or agreed to in writing, software
 * distributed under the License is distributed on an "AS IS" BASIS,
 * WITHOUT WARRANTIES OR CONDITIONS OF ANY KIND, either express or implied.
 * See the License for the specific language governing permissions and
 * limitations under the License.
 ********************************************************************************/


#include "ODETactileSensor.hpp"
//#include <rw/math/MetricUtil.hpp>
#include <rwsim/dynamics/Body.hpp>
#include <rwsim/dynamics/FixedBody.hpp>
#include <rwsim/sensor/BodyContactSensor.hpp>
#include <rwsim/sensor/SimulatedTactileSensor.hpp>

#include "ODEUtil.hpp"

using namespace rw::math;
using namespace rwsim::simulator;
using namespace rwsim::dynamics;
using namespace rwsim;

ODETactileSensor::ODETactileSensor(sensor::SimulatedTactileSensor *sens) :
    _rwsensor(sens)
{
}

void ODETactileSensor::addFeedback(const std::vector<dJointFeedback*>& fback,
   const std::vector<dContactGeom> &g,
   Body::Ptr bodyA,
   Body::Ptr bodyB,
   int bodyIdx)
{
    _feedback.push_back(fback);
    _geoms.push_back(g);
    _bodyIdx.push_back(bodyIdx);
    //if(body==NULL)
    //    RW_WARN("BODY IS NULL HERE!");
    _rwBody.push_back(bodyA);
    if (bodyA.cast<FixedBody>())
    	_bodyFixed.push_back(1);
    else if (bodyB.cast<FixedBody>())
    	_bodyFixed.push_back(2);
    else
    	_bodyFixed.push_back(0);
}

void ODETactileSensor::addFeedbackGlobal(dJointFeedback* joint, Body::Ptr a, Body::Ptr b, int body){
    _feedbackGlobal.push_back(joint);
    _bodyGlobalIdx.push_back(body);
    _bodyGlobal.push_back(a);
    if (a.cast<FixedBody>())
    	_bodyGlobalFixed.push_back(1);
    else if (b.cast<FixedBody>())
        _bodyGlobalFixed.push_back(2);
    else
        _bodyGlobalFixed.push_back(0);
}


void ODETactileSensor::clear()
{
    _feedback.clear();
    _geoms.clear();
    _bodyIdx.clear();
    //_contacts.clear();
    _wTa.clear();
    _wTb.clear();
    _rwBody.clear();
    _bodyFixed.clear();
    _directContacts.clear();
}

void ODETactileSensor::addContact(const Vector3D<>& pos,
                                  const Vector3D<>& force,
                                  const Vector3D<>& normal,
                                  Body::Ptr b){
    _directContacts.push_back( DirectContact(pos,force,normal,b));
}

void ODETactileSensor::update(const rwlibs::simulation::Simulator::UpdateInfo& info, rw::kinematics::State& state)
{
    RW_ASSERT(_feedback.size() == _geoms.size());
    RW_ASSERT(_feedback.size() == _bodyIdx.size());
    RW_ASSERT(_feedback.size() == _rwBody.size());
    RW_ASSERT(_feedback.size() == _bodyFixed.size());
    RW_ASSERT(_rwsensor);
    //std::cout << "\n";
    for(size_t midx=0;midx<_feedback.size();midx++){
        const int bodyIdx=_bodyIdx[midx];
        const int fixed = _bodyFixed[midx];
        std::vector<dJointFeedback*>& feedback = _feedback[midx];
        std::vector<dContactGeom>& geoms = _geoms[midx];
         for(size_t i=0;i<feedback.size(); i++){
             rw::math::Vector3D<> force,snormal,posw;
             //double depth = geoms[i].depth;
             posw = ODEUtil::toVector3D(geoms[i].pos);
             if(bodyIdx==0){
            	 snormal = ODEUtil::toVector3D( geoms[i].normal );
            	 if (fixed == 0)
            		 force = ODEUtil::toVector3D( feedback[i]->f1 );
            	 else if (fixed == 2)
            		 force = -ODEUtil::toVector3D( feedback[i]->f1 );
            	 else if (fixed == 1)
            		 force = ODEUtil::toVector3D( feedback[i]->f1 );
             } else {
                 snormal = -ODEUtil::toVector3D(geoms[i].normal);
            	 if (fixed == 0)
            		 force = ODEUtil::toVector3D(feedback[i]->f2);
            	 else if (fixed == 1)
            		 force = ODEUtil::toVector3D( feedback[i]->f1 );
            	 else if (fixed == 2)
            		 force = -ODEUtil::toVector3D( feedback[i]->f1 );
             }
             /*
             if(force.norm1()<0.0000001){
                 std::cout << "0 " << depth << " " << snormal << std::endl;
             } else {
                 std::cout << "1 " << depth << " " << snormal << std::endl;
             }
             */

             _rwsensor->addForceW( posw, force, snormal, state, _rwBody[midx]);
         }
    }

    for(size_t i=0;i<_feedbackGlobal.size();i++){
        Vector3D<> force, torque;
        if(_bodyGlobalIdx[i]==0){
        	// Object 1 is sensor body, object 2 is parent
        	if (_bodyGlobalFixed[i] == 1) {
        		// None of the two objects are static
        		// The force the constraint applies in the sensor body is added to the sensor.
        		// The SimulatedFTSensor will calculate the influence for the parent body in the parent body frame automatically.
        		force = ODEUtil::toVector3D( _feedbackGlobal[i]->f1 );
        		torque = ODEUtil::toVector3D( _feedbackGlobal[i]->t1 );
        	} else if (_bodyGlobalFixed[i] == 2) {
        		// Parent object is fixed  (no force is returned)
        		// It is however reasonable to set it to the opposite of the force applied at body 1
        		force = -ODEUtil::toVector3D( _feedbackGlobal[i]->f1 );
        		torque = -ODEUtil::toVector3D( _feedbackGlobal[i]->t1 );
        	} else {
        		// Body 1 is fixed
        		// If one body is fixed, result is always in f1 and t1 (even though they are for body 2)
                force = ODEUtil::toVector3D( _feedbackGlobal[i]->f1 );
                torque = ODEUtil::toVector3D( _feedbackGlobal[i]->t1 );
        	}
        } else {
        	// Object 1 is parent, object 2 is sensor body
        	if (_bodyGlobalFixed[i] == 0) {
        		// None of the two objects are static
        		// The force the constraint applies in the sensor body is added to the sensor.
        		// The SimulatedFTSensor will calculate the influence for the parent body in the parent body frame automatically.
        		force = ODEUtil::toVector3D( _feedbackGlobal[i]->f2 );
        		torque = ODEUtil::toVector3D( _feedbackGlobal[i]->t2 );
        	}
        	else if (_bodyGlobalFixed[i] == 1) {
        		// Parent object is fixed.
        		// If one body is fixed, result is always in f1 and t1 (even though they are for body 2)
        		force = ODEUtil::toVector3D( _feedbackGlobal[i]->f1 );
        		torque = ODEUtil::toVector3D( _feedbackGlobal[i]->t1 );
        	} else if (_bodyGlobalFixed[i] == 2) {
        		// Body 2 is fixed (no force is returned)
        		// It is however reasonable to set it to the opposite of the force applied at body 1
        		force = -ODEUtil::toVector3D( _feedbackGlobal[i]->f1 );
        		torque = -ODEUtil::toVector3D( _feedbackGlobal[i]->t1 );
        	}
         }
        //std::cout << force << torque << std::endl;
        _rwsensor->addWrenchWToCOM(force, torque, state, _bodyGlobal[i] );
    }

    // add all direct contacts
    BOOST_FOREACH(DirectContact& dc, _directContacts){
        _rwsensor->addForceW( dc.p, dc.f, dc.n, state, dc.b);
    }


    clear();

    _rwsensor->update(info, state);

/*
    for(size_t midx=0;midx<_feedback.size();midx++){
        int bodyIdx=_bodyIdx[midx];
        std::vector<dJointFeedback*>& feedback = _feedback[midx];
        std::vector<dContactGeom>& geoms = _geoms[midx];
        // calculate the total force added
        rw::math::Vector3D<> totalForce;
        rw::math::Vector3D<> gnormal;
        for (size_t i = 0; i < feedback.size(); i++) {
            if (bodyIdx == 0) {
                //std::cout << "f1" << ODEUtil::toVector3D( feedback[i]->f1 ) << std::endl;
                //std::cout << "f2" << ODEUtil::toVector3D( feedback[i]->f2 ) << std::endl;
                totalForce += ODEUtil::toVector3D(feedback[i]->f1);
                gnormal = ODEUtil::toVector3D(geoms[i].normal);
            } else {
                totalForce += ODEUtil::toVector3D(feedback[i]->f2);
                gnormal = -ODEUtil::toVector3D(geoms[i].normal);
            }
        }
        //if( rw::math::MetricUtil::norm2(totalForce)<0.00001 ){
        //    continue;
        //}

        double distSum = 0, maxDist = 0;
        std::vector<rw::math::Vector3D<> > normals;
        std::vector<rw::math::Vector3D<> > p;
        rw::proximity::MultiDistanceResult &cm = _contacts[midx];
        for (size_t i = 0; i < cm.distances.size(); i++) {
            distSum += cm.distances[i];
            maxDist = std::max(cm.distances[i], maxDist);
        }
        maxDist += 0.01;
        double dsum = maxDist * cm.distances.size() - distSum;
        //std::cout << "DistSum: " << distSum << " maxDist: " << maxDist << std::endl;
        // each force is scaled with (maxDist-dist)/distSum * totalForce
        rw::math::Vector3D<> pos, normal, force;
        for (size_t i = 0; i < cm.distances.size(); i++) {
            double dist = cm.distances[i];
            force = (maxDist - dist) / dsum * totalForce;
            //std::cout << dist << std::endl;
            //std::cout << "- force: " << force << std::endl;
            if (bodyIdx == 0) {
                pos = _wTa[midx] * cm.p1s[i];
                //normal = _wTb.R()*cm.p2s[i]-_wTa.R()*cm.p1s[i];
            } else {
                pos = _wTa[midx] * cm.p2s[i];
                //normal = _wTa.R()*cm.p1s[i]-_wTb.R()*cm.p2s[i];
            }

            _rwsensor->addForceW(pos, force, gnormal);
        }

    }
    */

/*
    for(size_t i=0;i<_feedback.size(); i++){
        Vector3D<> force, snormal;
        if(_bodyIdx[i]==0){
            force = ODEUtil::toVector3D( _feedback[i]->f1 );
            snormal = ODEUtil::toVector3D( _geoms[i].normal );
        } else {
            force = ODEUtil::toVector3D(_feedback[i]->f2);
            snormal = sign*ODEUtil::toVector3D(_geoms[i].normal);
        }
        _rwsensor->addForceW( ODEUtil::toVector3D(_geoms[i].pos), force, snormal, _rwBody[i]);
    }

    clear();
    _rwsensor->update(dt, state);
    */
}

/*
void ODETactileSensor::setContacts(
                                   const rw::proximity::MultiDistanceResult& res,
                                   rw::math::Transform3D<> wTa,
                                   rw::math::Transform3D<> wTb)
{
    //_contacts.push_back(res);
    _wTa.push_back(wTa);
    _wTb.push_back(wTb);
}
*/
