skyellen/robwork-mirror/(commit log)

2007-12-07 new structure
    [katana5M.cfg, katana6M.cfg]
2007-12-10 changed ToUpper and ToLower. for loop used instead of std::tranform. Caused strange error in VS2008 - STL bug? Functionality is unchanged.
2007-12-18 DeviceModel is replaced by Device.
2007-12-18 Files from iksolver directory and namespace has been removed and all stuff related to it moved to the new invkin folder and namespace.
    Added a new IKMetaSolver wrapping ordinary IterativeIK solvers and ensuring joint limits and tests for collision.
    Update test
2007-12-18 Updated test to match new inverse kinematics namespace structure
2007-12-19 A more powerful path-planner interface.
2008-01-02 Removed adding of cameraview to workcell
2008-01-03 Refactored Device implementation.
2008-01-03 Some more STL compliance.
2008-01-04 Prefer Device to SerialDevice and some TULLoader cleanup.
2008-01-06 Bug fix + added tcp frame support
2008-01-06 debug print removed
2008-01-11 Use WORLD for the world frame, fixes for the Lua interface, new formatting for operator<< for transform3d.
2008-01-18 Use DeviceJacobian in the interface. Bits of manual writing.
2008-01-21 Added some filtering of the result of the getDistances query
2008-01-21 Moved functions from JointTrasnform into Revolute and Prismatic joint
2008-01-29 added JointLimitWeight...
2008-02-13 baseDJxyz() methods have been added to the device types.
2008-02-13 Added a Math::ClampQ method
2008-03-18 A neat DeviceHomePos for specifying the initial configuration of a device.
2008-03-19 Wire mode property.
2008-04-08 bug in renderframe when drawing other than WIRE
2008-04-24 Rename of Frame::getDof() to Frame::getDOF(). The old version is deprecated.
    State now has a size() method which is useful when debugging.
2008-05-06 Documentation updates for the Lua script interface and a nicer kinematic structure example.
2008-05-25 Added VelocityRamps code to sandbox
2008-06-04 A couple of new methods.
2008-06-06 Preliminary preparation for Volatile marker on CollisionSetup.
    [main.cpp]
2008-06-06 Support for Volatile specifiers in the collision detector (and indirectly for frames with no geometries in PQP).
2008-06-07 now it takes a const device
2008-06-24 A number of changes:
    - Bugfix for the TUL loader: The initial state for movable frames was
    not set.
    - New sbl path planner.
    - Various simple path planning utilities.
    - Automatic exclusion of statically linked frames in the collision
    detector.
    - A Ptr<T> convention for passing of pointers to objects.
    - Path planners can now be aborted by a stop criteria.
    - A Models utilities file.
2008-07-09 added support for loading according to the drawable to refferance frame change
2008-07-22 New classes:
    - QEdgeConstraint
    - QExpand
    - QToTPlanner
    - QToQPlanner
    - QToQSamplerPlanner
    Removal of classes:
    - StraightLinePathPlanner
    - lazyprm
    Renamed classes:
    - PathPlanner is renamed to QToQPlanners for RRT.
    The Ptr convention is used more extensively. Path planner interfaces
    have all been changed.
    macros.hpp has been restored.
    CollisionDetector no longer takes ownership unless you ask for it
    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
    [main.cpp]
2008-07-23 Updated VelocityRamp with velocity and acceleration output
2008-08-01 - New QIKSampler used for approach planning. - DeviceModel is removed.
2008-08-04 - Metric and CollisionDetection examples for the manual.
    [main.cpp]
2008-08-11 - Device::QBox typedef. - Smarter discretize collision checking for an edge.
2008-08-28 Removed State argument in the sensor/Camera acquire method
2008-08-28 Added a possibility of scaling velocity and acceleration limits on the xqpcontroller
2008-08-29 Frame and workcell utilities.
2008-09-08 Updated PieperSolver to support offsets on theta and offset between base and frame 1
2008-09-23 - Workcell analysis for a device to remove collision checks between pairs of frames that can be considered to be in a static relationship if the joints of the device are the only frames currently bei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
2008-09-25 Performance tuning of the forward kinematics and PQP.
2008-10-02 Added FrameMap
2008-10-02 - Use FrameMap for Yaobi and FKTable.
2008-10-07 Update of Pieper Solver to support both ZYZ and Z(-Y)Z rotations of the spherical joint
2008-10-14 - DH parameters on joints in TUL mode. - ClosedFormIK::make() constructor.
2008-10-16 - Updated DeviceJacobian to return the Jacobian relative to the base frame to make it consistent with the method name and the Device::baseJframe method.
    - Updated SimpleSolver and ResolvedRateSolver to use the DeviceJacobian (which they previously could not do correctly due to the wrong reference frame in the DeviceJacobian).
2008-10-16 - Updated apidoc on DeviceJacobian
    - Moved opcode from ext to RobWorkApp
    - Moved opcode proximity strategy from rwlibs to RobWorkApp
    - Minor updates to tests
2008-10-24 - Updated Apidocs for release 0.3 - Fixed bug in LinearInterpolator<Transform3D>. This bug also spreads to ParabolicBlend<Transform3D<> >, which is still to be fixed. - Moved rw::common::ConvertUtil 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
2008-11-18 Removed old deprecated stuff (mainly static methods starting with upper-case)
2008-11-28 fixed bug, on linux clock is not a wall timer... we use gettimeofday istedet for
2008-12-03 Updated XMLRWLoader to support Cylinders
2008-12-04 * Updated trajectory package with a Trajectory interface. The old Trajectory implementation is renamed to InterpolatorTrajectory
    * Extended rw::invkin::ResolvedRateSolver support an arbitrary end-frame.
2008-12-04 Renamed implementations of joints to avoid using the TUL name (which is a historic system we do not which to associate our framework with). This change was discussed in November.
2008-12-14 Added methods for drawing the scene in select mode. eg. adding the frame id's to the name stack as the drawables are being drawn.
2008-12-17 Added functionality for creating a piepersolver with a device where the joints have DHsets in their propertymaps.
2009-02-12 Log is going to be thread safe.
2009-02-12 Bug fix: treedevices with dependent joints did sometimes not load in all joints.
2009-02-24 [bugfix] timer precision
2009-04-28 fixed overflow bug in linux version of currentTimeUs
2009-05-28 Added new joint and jacobian calculation structure.
    - Support for N-dof joints
    - BasicDevice and BasicDeviceJacobian removed and functionality moved to JointDevice, JointDeviceJacobianCalculator and distributed among the individual joints.
    - Dependent joints are now 0-dof joints and not frames
2009-06-22 Minor update in how namespaces are used in the new joint implementations.
2009-08-04 getActiveJoint replaced b getJoints. Because of multi-dof joint
2009-09-26 Bug, when removing chains of frames the system would assert
2009-09-28 Interface of a N-axis force torque sensor added
2009-10-23 colliding Frames on a result from a strategy is not included anymore...
2009-11-08 smaller bug fixes. Thanks to anders the PowerCube interface is now more stabil with serial interface
2009-12-11 Updates to rw::common::Timer and documentation of TimerUtil.hpp
2010-02-18 Updated FramePairMap to use a ConstFramePair and added methods for calling with two frame rather than a pair.
2010-02-18 Added PairMap<T1, T2>, a class that are strongly inspired of FramePairMap
2010-02-18 FramePairMap created based on rw::common::PairMap
2010-02-22 add camera support for Format7
2010-03-25 Encoder decentralization functionality added to sandbox
2010-03-25 Qpath added to encoder decentralization methods
2010-03-31 Add camera features like gain
2010-04-08 Minor bugfix/update to PA10 driver
2010-05-04 Updated interface for rw::common::Timer
2010-05-20 fix related to sdh
    [SDHDriver.cpp, SDHDriver.hpp]
2010-05-20 Fix double conversion from degree to rad on the acceleration and velocity max limits. Note that the max limit not are a valid to be used directly, but needed to be round down by a 'small' factor (try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
2010-06-25 Merged in revision 1391-1870 from branch release-0.5. This effectively converts the trunk from 0.4 to 0.5
    [Ball3D0_2Red.stl, Base.stl, BaseLR200i-1.stl, FingerBase.stl, FingerBase2.stl, FingerMid.stl, FingerTip.stl, Hook1.stl]
2010-07-04 non-const function added in state,statedata. api doc added to both broadphase strategy and StaticListFilter bug fix in giftwrap hull
2010-08-11 BroadPhaseStrategy renamed to ProximityFilterStrategy StaticListFilter renamed to BasicFilterStrategy, and made stateless to allow multiple threads calling collision detector.
2010-08-20 Fix for memory leak in rw::sensor::Image
2010-08-26 Added sandbox calibration stuff to visual studio project
2010-12-13 Updated ConvexHull to contain both an implementation for supporting calculation of distances both inside and outside the hull. This caused the ConvexHull3D interface to change.
2011-01-05 Updates to: - rw::pathplanning::QConstraint has update(const rw::kinematics::State&) method - rw::math::Q has properly working input stream operator
2011-01-27 bug: ini-file command line option did not work
    [main.cpp]
2011-02-10 fixed small/big letter issue
    [BtSimulator.hpp, ODESimulator.hpp]
2011-02-12 Bugfix - JointDevice support ending with a dependent joint - TreeDevice If the three banches late the first nodes are only added once.
2011-03-07 Modified WorkCell to use Device::Ptr instead of Device*
2011-03-07 Updated RobWorkStudio to work with WorkCell using Device::Ptr instead of Device*
2011-03-14 - Changed use of smart pointers in LinearTrajectory and ParabolicBlend. - Fixed old bug in setting bounds of JointDevice
2011-04-05 Updated kataka device file
2011-04-14 Updates to scene graph, bug fixes camera visualization fixed
2011-04-14 removed println
2011-04-19 Updated how collision checking maintains a list of frame pairs to test. Introduced rulebased ProximitySetup as replacement for CollisionSetup.
    [main.cpp]
2011-05-05 Added UniversalRobots driver to RWHW
2011-05-24 Minor updates to universalrobots driver and in CMakeLists for netft
2011-07-06 Added isPaused method on timer
2011-07-07 Updates NetFT driver and added it to FindRobWorkHardware
2011-07-17 added scrollbars to make the use of large device more userfriendly
2011-08-09 Updates to UR driver
2011-08-12 added GS20 and GS20_WIDE grippers
2011-08-15 - Sphere: Made the granulation optional - NetFT: Added printing for basic data type
2011-08-23 Updated with fixes to get it compile on Visual Studio
    [main.cpp]
2011-08-23 Fixed problem with missing exit menu item in RobWorkStudio
    [main.cpp]
2011-08-24 reset now allow changes to FixedFrames
    [ODESimulator.cpp, ODESimulator.hpp]
2011-08-26 - Added a stereo camera - Removed projection debug msg - Changed shutdown routines of UR/NetFT
2011-08-29 Torque compensation
2011-08-30 sensor interface changed
2011-09-02 added attach/detach methods on PhysicsEngine interface
2011-09-05 added attach and detach function
2011-09-05 fixed bug in setDynamicsEnabled
    [ODESimulator.cpp]
2011-09-06 Implemented F/T tool acceleration estimation by filtered position measurements.
2011-09-07 fixed bug with "one sensor per body limit"
    [ODESimulator.cpp, ODESimulator.hpp]
2011-09-07 fixed dropevent bug (drag and drop workcell files) and removed debug print
2011-09-29 removed debug print
2011-10-10 Minor bugfix when using cameras in the scene. The cameras are now removed from the menu when the work cell is closed and the view is reset to standard.
2011-11-15 fixed deprecated functions in Kinematics. Ffixed bug in IOUtil
2011-11-22 added posibility to place gripper in the different grasp configurations
2011-12-12 Renamed UR device
2011-12-19 Updated IKMetaSolver s.t. it by default checks for joint limits as specified in the documentation.
2012-01-03 trakstar sensor added
2012-01-15 clean up interfaces (missing impls) and added event mechanisms to dynamicworkcell and body
    [ODESimulator.cpp, ODESimulator.hpp]
2012-01-27 Updated UniversalRobots Driver to support servoing
2012-02-01 - Fixed couple of problems with missing template specifications in equal operations.
2012-02-02 Updated UR driver with servo support
2012-02-03 added a real test structure to RobWorkSim
    [Base_hull.stl, FingerBase2_hull.stl, FingerBase_hull.stl, FingerMid_hull.stl, FingerTip_hull.stl, schunkFlance_hull.stl]
2012-02-04 switched to swig...
2012-02-05 fixed bug that made crash when vizualizing other dynamic devices than suctioncup
2012-02-07 added pose controller for inverse kinematics control
2012-02-07 added support for force torque sensor
2012-02-24 added support for new DH-HGP joint type
2012-02-24 added support for new DH-HGP joint type. Extended joint interface to get the displacement transforms as well as the joint transforms
2012-02-24 updated ForceTorque sensor interface. added documentation. added more configuration options on pose sampler
2012-03-01 fixed bug in computing jointtransform
2012-03-01 removed gripper specific stuff
2012-03-01 added a small library to start robworkstudio in a seperate thread. Especially usefull calling from scripts.
2012-03-09 added a special 3D case of QHullND .
2012-03-18 fixed bug, crash upon deletion of frame, statedata
2012-03-18 replaced big mesh with convex hull approximations and binary stl
    [Base.stl, Base_chull.stl, FingerBase.stl, FingerBase_chull.stl, FingerMid.stl, FingerMid_chull.stl, FingerTip.stl, FingerTip_chull.stl]
2012-03-21 removed debug printing
2012-04-17 removed debug prints
2012-04-19 Avoid the setting of VERSION and SOVERSION for a library in case we are building a module on Mac OS.
2012-04-26 Updated VS 2005 project and fixed a couple of compile problems.
2012-04-27 updated simulation src, cleaning and bug fixing
    [ODEKinematicDevice.hpp, ODESimulator.cpp, ODESimulator.hpp]
2012-05-08 Removed a couple of warnings
2012-05-14 Added functionality to get temperature.
2012-06-01 Fixed bug in Scenegraph causing RWS to crash when removing a frame.
2012-06-08 Yet another Quaternion update. The previous matrix to quaternion method had problems when the matrix trace was 0.
2012-06-11 added sanity check on the existens of parent frames
2012-06-11 bugs due to Object abstraction
    [ODESimulator.cpp, ODESimulator.hpp, ODETactileSensor.cpp, ODETactileSensor.hpp]
2012-08-01 Minor corrections to rwlibs/calibration
2012-08-03 trimesh sampler
2012-08-07 rename to force storque sensor to FTSensor, minor changes on scanner interfaces and sensor inheritance
2012-08-07 fixed wrong reference frame when using simulated scanners
2012-08-07 moved camera stuff from camera dir, added simulated kinect camera (scanner and camera in one)
2012-08-07 added test files
    [plane_5x5.stl]
2012-08-07 sensor interface updated, dynamicdevice interface changed, rigiddevice now allow force control, updated several classes to utilize new StatelessObject class
2012-08-21 added closed form inverse kinematics solver for UR, and a planner and experiment format for use in the learnbip project.
2012-08-24 Added sampler for random configurations in learnbip on Marvin platform.
2012-08-30 Changed possibility for sampler to use gripper tcp instead of arm tcp.
2012-09-06 New sample area and improved planning for learnbip.
2012-10-04 Require manual activation of the calibration package. Done by Jimmy.
2012-10-09 Modified LearnBiP classes to respect non-world base frame of the robot.
2012-10-15 Fixed some errors and warnings in RobWorkSim.
    [ODEKinematicDevice.cpp, ODESimulator.cpp]
2012-12-13 cleanup and preparation for release 0.6.0
    [katana5M.cfg, katana6M.cfg]
2013-01-26 merged calibration stuff and jaj-dev stuff into trunk. major changes includes calibration support, serialization, xml parser abstraction, new plugin (extension/extensionpoint) architecture.
2013-01-26 was moved long ago
    [Rob-0.stl, Rob-1.stl, Rob-2.stl, Rob-3.stl, Rob-4.stl, Rob-5.stl, Rob-6.stl, welding-gun.stl]
2013-01-30 properties on devices are now loaded properly
2013-01-31 Added initial class for rendering of force and torque sensor.
2013-02-02 made general debugging, fixed some protocol in Priminterface, reduced verbosity and frequency of messeges on ur teach pendent
    [URCallBackInterface.cpp, URCommon.hpp, URPrimaryInterface.cpp, URPrimaryInterface.hpp, UniversalRobotsRTLogging.cpp, UniversalRobotsRTLogging.hpp]
2013-03-06 added unit test of removing movable frames, currently failing
2013-03-08 removed debug printing stuff
2013-03-08 fixed mem bug regarding removal of frames from state added Stateless structures to help in creating stateless objects
2013-03-08 removed the calibration loading for now... it does not compile properly
2013-03-08 Changed Sensor to SensorModel. Only stateless models are to be stored in the workcell not actual sensor interfaces.
2013-03-08 removed calibration loader functionality (depends on Qt4, will be added again later)
2013-03-15 Adding unit-tests for the Transpose and DLS versions of the Jacobian based iterative inverse kinematic solvers. Together with minor fixing of comments and documentation. Also removed _useTranspose fr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
2013-04-03 added ur test scene
    [GreenCup_5k_tex.stl, GreenCup_800_tex.stl, plane_5x5.stl]
2013-04-19 minor fixes and doc changes
    [main.cpp]
2013-05-24 smaller sized geometry
    [Base_hull.stl, FingerBase2_hull.stl, FingerBase_hull.stl, FingerMid_hull.stl, FingerTip_hull.stl, Finger_slim_m_v10.stl, base.stl, basejaw.stl]
2013-06-04 updated calibration tests to DOM format
2013-06-17 Fixed minor bugs in recursive Newton-Euler.
    [SerialDeviceController.cpp]
2013-07-23 REMOVED FRAMEPAIRMAP FROM SANDBOX
2013-08-06 fixed bugs in calibration loading
2013-08-07 Updated unit test for calibration to include testing save/load of measurement files
2013-08-08 Added Geometry primitive: Tube
2013-08-08 Added Frame pointers to contacts and timer to contact detector. Modified contact strategies to use PropertyMaps to load parameters.
2013-08-08 Updated render for Force-Torque such that user can set scaling and colors of arrows.
2013-08-08 Added Tube geometry.
2013-08-09 Changed timer to use RobWork internal timer.
2013-08-11 Boost unit tests using the dynamic library method seem to be failing on Mac OS. By not searching for these libs we switch to the header only version that works. This is a workaround. The underlying p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
2013-08-22 Added Calibration File member to WorkCell
2013-08-22 - Extended XML Loader to read in Calibration file info for a WorkCell. - Fixed some warnings.
2013-08-22 Updated rwlibs::calibration to support calibration of a workcell rather than individual devices. NOTICE: Still more updates needed. Internal calibration of robot does not work yet.
2013-08-22 Updated calibration.hpp include file
2013-08-23 Added new calibration application
2013-08-23 Removed old calibration tool from CMakeLists.txt
2013-08-23 Minor updates to calibration program to increase user friendliness
2013-08-25 Fxing some bugs in the calibration code.
2013-08-26 added limits to servo interface
2013-08-26 fixed thing in servo
    [URCallBackInterface.cpp]
2013-08-26 Fixed compile problems in CalibrationTest. NOTICE: The test itself needs further updates to run and pass.
2013-08-26 Various updates to the rwlibs::calibration packages
2013-08-26 Updates to the calibration tool program
2013-08-27 Updates to calibration
2013-08-27 Fixed calibration test
2013-08-28 Fixed problem in CalibrationTest
2013-08-28 Internal robot calibration not enabled in this commit
2013-08-29 Updated calibration to support calibrating multiple sensors at once.
2013-08-29 Updated calibration test to support and test calibration of multiple sensors towards one robot
2013-09-04 Made sandbox directory for automatic gripper design plugin.
2013-09-05 TimerUtil uses long long type now for time representation.
2013-09-05 Fixed BodyController not stopping properly when trajectory is finished.
    [BodyController.cpp]
2013-09-09 Added documentation for a couple of methods in COllisionDetector class
2013-09-12 Updated gripper evaluation plugin
2013-09-19 Update gripper simulating plugin
2013-09-20 Updated Jog plugin to listen for WorkcellUpdated generic event, so it updates the GUI when frames or devices are added to the workcell.
2013-09-23 Updated gripper evaluation plugin.
2013-09-24 Updated gripper ev. plugin
2013-09-25 Upd. gripper evaluation plugin
2013-09-25 Updated gripper ev plugin...
2013-09-27 Upd. gripper evaluation plugin. Added some tools.
2013-09-30 Gripper evaluation plugin.
2013-10-01 Updated gripper evaluation plugin. Added saving TaskDescription to XML.
2013-10-08 - average wrench quality is now measured in relation to convex hull centroid instead of the mean of vertices - added simplexVolume() to GeometryUtil for calculating areas of convex hull's faces - add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
2013-10-09 Updated gripper evaluation code
2013-10-13 Finally fixed setting up teached grasps in gripper evaluation plugin.
2013-10-18 Changed RobWorkStudio to not build as Console application in Visual Studio in Release mode (avoiding the terminal in the background).
    [main.cpp]
2013-10-29 fixed bug on uninitialized parent pointer in RigidBody. Also a max correcting velocity was set up in ODESimulator which makes simulations much more stable. This should come out as a parameter in the 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
    [ODESimulator.cpp]
2013-10-30 Added the max correcting velocity as a parameter in xml dwc. The property name of the PhysicsEngine for this is: MaxCorrectingVelocity.
    [ODESimulator.cpp, ODESimulator.hpp]
2013-10-31 added multisampling to framebuffers
2013-11-01 added unit test for long-stability of ODE simulator
    [BlueSupport.stl, GreenCup_5k_tex.stl]
2013-11-09 Changed the way coverage is calculated in gripper evaluation.
2013-11-11 Minor improvements to Falcon control plugin
    [GreenCup_5k_tex.stl, GreenCup_800_tex.stl]
2013-11-12 improved speed x4 in frameTframe calculation
2013-11-12 Minor changes in Falcon teleoperation plugin
    [GreenCup_5k_tex.stl, plane_5x5.stl]
2013-11-15 gripper evaluation
2013-11-15 Added new jaw to try with PG70 gripper
    [jaw4u.stl]
2013-11-18 Fix reverting frameTframe changes
2013-11-18 Java interface: Added PDController, DWC loader, callback to ThreadSimulator, created Ptr ownership and fixed CMake error without Java + added more documentation.
2013-11-19 updated gripper evaluation
    [left_placeholder.stl, pump.stl, pump_simple.stl, right_placeholder.stl, tthing.stl]
2013-11-22 Fixed warnings for RobWorkSim.
    [ODEKinematicDevice.cpp, ODESimulator.cpp, SerialDeviceController.cpp]
2013-11-25 Throwing exception from ODESimulator when ODE throws exception (quick fix to make sure that GraspTaskSimulator continues to next grasp anyway)
    [ODESimulator.cpp]
2013-11-26 fixed bug in writing VelocityScrew6d to xml file
2013-11-27 fixed some bugs in gripper evaluation
2013-11-28 Updated loader/saver for calibration measurement files
2013-11-28 Added the new loader for calibration measurement files
2013-11-29 Added CalibrationMeasurement files which I forgot in the previous commit
2013-11-30 Updated calibration tools to use the new CalibrationMeasurement class instead of the old SerialDeviceCalibration
2013-11-30 Added the new XMLCalibrationMeasurementFile to the calibration.hpp file
2013-12-01 driver for robotlabFT sensor
2013-12-02 Fixed problem with ofstream constructor based on std::string in CalibrationTool2
2013-12-02 fixed bug in VelocityScrew. writing id changed to PosID and EAAid
2013-12-04 Bug fix: missing paranthesis caused LUA and Python print functions not to work.
2013-12-06 gripper evaluation stuff
2013-12-08 gripper evaluation update
2013-12-16 Small warning fix. Private members that are not used
    [RampInterpolator.hpp]
2013-12-18 Added documentation to Device class. (RobWork Issue 63)
2014-01-03 correction of framename
2014-01-14 Addition of rwlibs/assembly library (Issue #67)
    [AssemblyControlResponse.cpp, AssemblyControlResponse.hpp, AssemblyControlStrategy.cpp, AssemblyControlStrategy.hpp, AssemblyParameterization.cpp, AssemblyParameterization.hpp, CircularPiHControlStrategy.cpp, CircularPiHControlStrategy.hpp]
2014-01-14 Adding initial AssemblySimulator and tools.
2014-01-14 Added RWS plugin for visualization of assembly operations.
2014-01-20 Added Threading tools (Issue 66)
2014-01-20 Added documentation page for Assembly Simulation.
2014-01-23 - In BINArchive.cpp and INIArchive.cpp I have removed the declaration of MAX_LINE_WIDTH as this is already declared in the header files. Having them in the cpp files leads the variables being defined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
    - In INIArchive.cpp I have added explicit casts for in the 8-bit doRead implementations to avoid warnings.
    - The << operator in the OutputArchive was missing a return statement. This has been added. Together with a bit of documentation.
    - In AssemblyParameterization.hpp I got a compile warning because Visual Studio did not accept the forward declaration when later trying to identify the type in the implementation.
    - In sandbox/invkin/ClosedFormURSolver.cpp I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
    [AssemblyParameterization.hpp]
2014-01-26 Reverted changes to CalibrationMeasurement.cpp from revision 5194 as these where committed by mistake.
2014-02-14 added option to show/hide all child frames of specific item
2014-02-26 Bug fix: Memory Leak when using exitPhysics in ODESimulator.
    [ODESimulator.cpp]
2014-03-07 Updated gripper stuff
2014-03-07 added driver for Robotiq 3 hand
2014-03-10 cleaned up gripper stuff
2014-03-11 fixed bug on VelocityScrew streaming
2014-03-11 added gripper landscape generator
2014-03-13 changed the way the tcp parameter of the gripper is defined
2014-03-13 fixed grippers tcp
2014-03-14 added robustness calculation tools to a gripper evaluation
2014-03-14 Fixed to Issue 73: An addition to PhysicsEngine interface allows constructing empty PhysicsEngines. Also PhysicsEngineFactory api has migrated to new plugin structure in PhysicsEngine::Factory. Old c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
    [ODESimulator.cpp, ODESimulator.hpp]
2014-03-21 added sample scripts for gripper evaluation
2014-03-25 added option of saving and using surface samples
2014-03-26 gripper evaluation can now be set to use specific number of samples
2014-03-27 got rid of task splitting in robustness evaluation for grippers
2014-03-28 added skipping filtered tasks in GraspTaskSimulator
2014-04-03 Removed debug print outs
2014-04-07 fixed parallel jaw gripper sampler not sampling objects thinner than 1 cm
2014-04-08 Buf fix to AssemblySimulator (issue #76)
2014-04-10 Bug fix: allowing Links and Joints to use EstimateInertia while specifying COG as known from the ordinary rigid bodies.
2014-04-23 Added constraint type to rwsim (Issue #78)
    [ODEConstraint.cpp, ODEConstraint.hpp, ODESimulator.cpp, ODESimulator.hpp]
2014-04-23 added some extra test files
    [OrangeMarmelade_800_tex.obj]
2014-04-23 Fixed Defect issue 79 with RobWorkStudio crashing if OBJLoader failed parsing. Only minor comments were added to Assimp loader.
    [OrangeMarmelade_800_tex.obj]
2014-04-26 added gripper randomization script
2014-04-29 fixed gripper save/load bug
2014-04-30 fixed bug with gripper geeration
2014-05-01 fixedimpossible geometry generation when randomizing grippers
2014-05-02 - Added another round of testing for obtaining robustness metric - Robustness is now also saved in gripper's XML file (backwards compatible) - Added optional Stroke parameter for gripper XML, which o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
2014-05-02 updated create gripper script to use stroke
2014-05-02 random gripper generation now uses stroke
2014-05-02 fixed stroke bug w gripper generation, added stress computation to the plugin
2014-05-03 - Added worst case stress calculation for parametrized grippers - Quality is now calculated as success ratio - penalty associated with stress limit - Stress limit is now specified in the task descrip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
2014-05-04 removed some debug printouts
2014-05-04 removed debug printout
2014-05-04 added fTf and wTf as util functions to Frame interface
2014-05-04 CameraModel was in wrong namespace and lots of copy paste errors were fixed.
2014-05-04 varius changes to sampler
2014-05-04 enabled sending joint trajectories to the controller
2014-05-04 removed debug printouts
2014-05-04 changed try catch handle. this would crash because Qt gui was queried upon exceptions which is not allowed when not running in Qt thread
2014-05-10 - fixed tcp offset for stl grippers (reverted to base offset), - fixed collision issue when using geometries from stl
2014-05-14 fixed filtering grasps
2014-05-15 added alignments to the task description of the grippers
2014-05-18 Issue 83: Update of Assembly Simulator.
    [AssemblyControlResponse.hpp, BodyController.cpp, BodyController.hpp]
2014-05-18 Fix that avoids segmentation fault when printing a contact with no frames set.
2014-05-21 Updated RobWorkSim example tools related to Assembly Simulation.
2014-06-02 Correcting the returned Q to only hold 7 values like for the other getXXLimits() functions - especially because toQ(...) removes the last element.
    [SDHDriver.cpp]
2014-06-03 Changed position control in BodyController to use inertia to calculate applied torque instead of mass (to avoid instability for long and thin objects for instance).
    [BodyController.cpp]
2014-06-03 Bug fix for bug fix: forgot to rotate inertia to world frame.
    [BodyController.cpp]
2014-06-10 fixed bug: when RWS opened, initial setting for draw switches in the view menu was not based on actual mask state
2014-06-12 Added rwlibs/assembly to script-interface.
2014-06-12 Updated AssemblySimulator and added it to the script interface.
2014-06-12 Added missing function in AssemblySimulator.
2014-07-01 Update to TNT Simulator: added thresholds on velocities and forces, bouncing and correction thresholds, tactile sensors, and ability to handle failed tracking better.
2014-07-01 Update to Assembly Simulation: added ability to save maximum contact force, and added function to set the timestep used in simulation.
2014-07-02 Printing to debug log instead of std out when loading plugins. Log instance is reset to main instance after loading plugins.
2014-07-04 Various updates and extensions to the calibration package.
2014-07-15 updated quality function for grippers evaluation
2014-07-18 fixed conversion bug in gripper evaluation
2014-07-21 fixed reading/saving infinity bug in gripper evaluation
2014-07-21 gripper evaluation; added options for creategripperxml
2014-07-25 Added a tools folder to RobWork. Calibration tools are added to the new folder.
2014-07-25 Removed the calibration tools from the test folder. The calibration tools can now be found in the RobWork/tools folder
2014-07-26 Re-Added the MultivariateNormalDistribution.hpp file required by the calibration test.
2014-07-30 Added documentation to the calibration package and made some clean up of old code not being used any more.
2014-07-30 Updates to test and tools for calibration to reflect updates made in previous commit.
2014-08-04 Modified assembly control to include trajectories.
2014-08-05 Fixed minor compilation issue with CalibrationTool2.
2014-08-05 Fixed another bug in CalibrationTool2
2014-08-05 Minor cleanup of calibration code
2014-08-05 Removed old CalibrationTool
2014-08-05 Renamed CalibrationTool2 to CalibrationTool.
2014-08-05 Minor update to CalibrationTool
2014-08-05 Fixed assembly simulator such that it stops when the strategy indicates it is done.
2014-08-06 Added more information in assembly simulator formats about simulation and strategy failures.
    [AssemblyControlResponse.cpp, AssemblyControlResponse.hpp]
2014-08-06 Updated CalibrationTest to match new interface of WorkCellCalibration
2014-08-08 fixed saving gripper volume
2014-08-26 added postGenericEvent and postGenericAnyEvent. Posting events from non-gui threads makes Qt crash. since events are running in the callers thread this becomes crucial. These methods decouple the eve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
2014-08-26 removed debug print messages
2014-08-26 fixed sending with events bug. Now postGenericEvent is used decoupling the caller thread from gui changes.
2014-08-27 added functions to allow for printing debug information
2014-09-03 RobWork issue 88. Added possibility of changing UR pc master host ip in the script through a function call.
    [URCallBackInterface.cpp, URCallBackInterface.hpp]
2014-09-05 fixed a naming bug that prevented compilation
    [URCallBackInterface.cpp]
2014-09-05 Major update of the TNT simulator, implementing tangential friction, sensors, and handling of collisions between constrained bodies. Correction is now done correctly after rollback, and not before. T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
2014-09-05 A few minor fixes and added an initial ODEContactStrategy using the ODE collision detection system.
    [ODESimulator.cpp]
2014-09-10 Fixed bug in ODE springs - if the parent or child body frame are not placed in the object center of mass, a torque must be added.
    [ODEConstraint.cpp]
2014-09-10 Added missing " for the win32 case.
2014-09-10 Fixed issues with compiling the universal robots driver on Visual Studio 2012
    [URCommon.hpp]
2014-09-17 Bug fixes in simulators - in ODE rigid body forces were applied twice, and in TNT a bug in the rollback method was fixed. The ODE spring now has the friction effect disabled by default.
    [ODEConstraint.cpp, ODEConstraint.hpp, ODESimulator.cpp]
2014-09-26 Updated AssemblyRegistry to be an extension point for AssemblyControlStrategies.
2014-10-01 Changed a couple of functions to const.
2014-10-01 Changed TNTMaterialMap to be case-insensitive to friction parameter names.
2014-10-03 Introducing startCommunication and stopCommunication functions and marking the old interface deprecated. Also indenting the source file - introducing a lot of changes/noise in this commit.
    [URCallBackInterface.cpp, URCallBackInterface.hpp]
2014-10-19 Follow-up to previous commit (revision 5502) s.t. it now also throws an exception in case a polygon is constructed with an unequal number of vertices and normals.
2014-10-28 Fixed small bug in AssemblySimulator.
2014-11-04 Updates related to Assembly simulation.
2014-11-05 Fixed bug when selecting control mode in the Assembly Simulator.
2014-11-18 Added possibility to load multiple assembly task files.
2014-11-24 updated random gripper generation code
2014-12-04 added algorithms::ransac; see Issue 96
    [line_data.csv, plane_data.csv, stablepose_data.csv]
2014-12-04 gripper code update
2014-12-04 New and more accurate estimation of COG, inertia and volume. Issue #93.
    [table.stl, table_union.stl]
2014-12-08 Added option to AssemblySimulator that allows starting directly in the approach pose to save simulation time.
2014-12-11 Minor addition to ThreadTask: allows tasks to fail by registering exceptions and allows propagation of these exceptions to parent tasks.
2014-12-11 introduced alignment calculation in gripper evaluation
2014-12-11 Update of collision solvers in TNT simulator - including a couple of new ones.
2014-12-17 added test case for structured line
    [sline_data.csv]
2014-12-18 gripper plugin update
2014-12-25 Removing use of Eigen internally in VelocityScrew6D and Wrench6D Code change corresponding to Issue #94
2015-01-05 test case for stable pose 0 dof ransac model
    [stablepose0_data.csv]
2015-01-15 Use the term 'callbackIP' for the IP that the robot should use for communicating with the host/computer that is running this driver. Use debug logs to make it easier to see what is going on.
2015-01-15 removed cmake debug printout
2015-01-16 Update to the outdated Bullet simulator such that it compiles and uses the new plugin structure. It has been modified to use correct geometry information. (by Simon Mathiesen)
    [BtSimulator.cpp, BtSimulator.hpp]
2015-01-19 jog plugin now listens to workcell structure change event, so that devices/movable frames list is updated when adding/removing them
2015-01-21 Bug fix related to issue #94 - e() function on VelocityScrew6D did not work, causing JacobianIKSolver to fail.
2015-02-06 Moved isLogEnabled function public to allow users to check the current loglevel.
2015-02-25 test has been deprecated for a while due to use of .wu file format. Changed it to xml file format and added some timings to the test. Tests now all pass.
    [base.stl, joint0.stl, joint1.stl, joint2.stl, joint3.stl, joint4.stl, joint5.stl, robotFlange.stl]
2015-03-10 Added a couple of methods to the Assembly parameterization interface.
2015-03-11 see issue 106 - to make loading of robwork plugins less painfull. Autodetection rutines have been upgraded. Initialize method is not intrusive anymore (no config files are saved by default). env vari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
2015-03-11 added several unit tests for testing simulation and sensors. Mostly structure. Should be filled out by the propriate people.
    [peg-square298.stl, peg298.stl, peg299.stl, peg30-10.stl, platform.stl]
2015-03-13 TNT engine: important bug fixes for position of kinematic bodies, relative angular velocity used for spring torques, and update of force sensors.
2015-03-25 On simulatedsensor, simulatedcontroller, sensor and controller interfaces.. see issue 107
    [CircularPiHControlStrategy.cpp]
2015-03-26 The precision should use defaults corresponding to the numeric limit(s) provided by the c++ stl. See issue 109.
2015-04-08 Bug fix in relation to new sensor structure.
2015-04-09 TNT engine: added a couple of asserts.
2015-04-13 Fix in ODE for tactile sensors with fixed bodies (Issue #116)
    [ODESimulator.cpp, ODETactileSensor.cpp, ODETactileSensor.hpp]
2015-04-13 Update of the Bullet engine (Issue #115)
    [BodyController.hpp, BtConstraint.cpp, BtConstraint.hpp, BtSimulator.cpp, BtSimulator.hpp, BtTactileSensor.cpp, BtTactileSensor.hpp, SerialDeviceController.hpp]
2015-04-14 fixed bug that made executable crash if a plugin could not be found or loaded. It now just prints a warning.
2015-04-14 fix for sensor handles from simulated sensors. See issue 117
    [ODETactileSensor.cpp]
2015-04-17 Modified ThreadTest - hopefully it will fix the error that appears from time to time.
2015-04-30 Commit associated to issue 119 in the issue tracker. - Puts an actual implementation behind the moveT command enabling the user to call the UR with a target and make a linear motion (in workspace) to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
    [URCallBackInterface.cpp, URCallBackInterface.hpp]
2015-05-06 added include of controller and getter handles for sensor anf controller
2015-06-04 Fixed a couple of compilation issues with C++11
2015-06-12 updated threadsimulator to work on simulator interface. Also removed old P engine factory methods. They now forward to PhysicsEngine.hpp
2015-06-22 modified tasksimulation unit test with multi-threaded simulation
2015-06-23 Bug fix for rollback of kinematic bodies in ODE (velocities was not restored correctly).
2015-06-25 Fixed minor memory leak in ODE Suction Cup Device.
2015-07-01 redirected some thread simulator output to errorLog
2015-09-09 Adding awareness of the number of joints and function to querry for it.
2015-09-14 Fixed critical bug in PrismaticJointZeroRotationImpl, which let to wrong forward kinematics when using the multiplyTransform method.
2015-09-24 Added thickness to the tube geometry (in connection with Bullet update in previous revision)
2015-10-19 Fixed bug in BodyController and cleaned up the interface.
    [BodyController.cpp, BodyController.hpp]
2015-11-20 Fixed sensor plugin.
2015-11-27 Fix bug that caused RobWorkStudio to crash when parameters were supplied on the commandline.
    Also did some minor typo fixing.
    [main.cpp]
2015-12-17 Update of AssemblySimulator to use SimulatorLog.
2016-01-15 Added tests for constraints, including loading of different constraints with and without springs and limits. Furthermore fixed the existing issues with the test of DynamicWorkCellLoader.
2016-02-04 Added const and comments to a couple of methods in DynamicWorkCell.
2016-02-15 Bug fix for ODE springs when one of the bodies is a fixed body.
    [ODEConstraint.cpp]
2016-03-10 Added possibility, in ODE, to use ODE-native plane geometries for fixed bodies.
    [ODESimulator.cpp]
2016-03-31 Minor patch for ODE and Bullet. Removed ODE angular velocity cap and added equilibrium point for springs in Bullet such that they work as expected.
2016-04-01 Added initial test framework for physics engines, including a RobWorkStudio plugin for running tests, and unit gtests. Updated energy calculation functions for rigid bodies to include kinetic and pot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
2016-04-10 Fixed some bugs in RobWorkSim. When ODE is disabled, code dependent on ODE should not be compiled. Compilation errors with Bullet 2.81 is removed (due to interface change in Bullet from version 2.82).
    [BtRWCollisionConfiguration.cpp, BtRWCollisionConfiguration.hpp]
2016-04-10 Fix of error in previous commit.
    [BtRWCollisionConfiguration.cpp]
2016-05-09 Fix to a couple of unit tests. Increased time for PRM pathplanning test (with A-star and KDTree), which has never worked. Removed the requirement that RWPE is available in RobWorkSim tests.
2016-05-09 Forgot a couple of lines in removal of RWPE as a critical component of RobWorkSim.
2016-05-10 Fixed memory leaks in RANSAC algorithm and test. Test has been made deterministic by using correct seed methods. Tests currently succeed only due to lucky seeds.
2016-05-25 Fix to EngineTest framework. Removed global variable from static library to avoid segmentation fault at exit error.
2016-06-03 Removed the old inverse kinematics solver for UR from the sandbox. It has been picked up by LPE and is now in the main rw library instead.
2016-06-06 Adding scene for assembly test.
    [Circular_Ø32_tool.ipt, Circular_Ø32_tool.stl, Circular_Ø32_tool.stp, Hole.stp, Hole_Ø31,5.stl, Hole_Ø31.stl, Hole_Ø32.stl]
2016-06-09 Updated scene for assembly test.
2016-06-12 Fixed some names that did not resolve correctly in Visual Studio.
    [SyncPDController.cpp, VelRampController.cpp]
2016-06-13 Bug fix for Bullet where includes were written wrong.
    [BtConstraint.cpp, BtRWCollisionConfiguration.cpp, BtRWCollisionConfiguration.hpp, BtSimulator.cpp, BtTactileSensor.cpp]
2016-06-13 Due to conflict between RobWork and Xerces DLL_EXPORT macros, ODE plugin did not export plugin hook properly. Currently this has been fixed by reducing the includes in ODE (no need to be aware of any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
    [ODEKinematicDevice.cpp, ODEKinematicDevice.hpp, ODESimulator.cpp, ODESimulator.hpp, ODETactileSensor.cpp, ODETactileSensor.hpp]
2016-06-21 Fixed missing and failing methods in ImageLoaders. Added test for these loaders as well. Google test framework has been extended with functionality to find the testfiles directory.
2016-06-28 Fixed a few of the warnings in rwhw.
    [URCallBackInterface.cpp, URCommon.hpp, URPrimaryInterface.cpp, URPrimaryInterface.hpp]
2016-06-28 Minor fixes for RobWorkSim: removed some unused variables and includes and also fixed some warnings. Includes has been added to prepare for removal of some unused includes in RobWork.
    [ODEConstraint.cpp, ODEKinematicDevice.cpp, ODESimulator.cpp, SerialDeviceController.cpp, SerialDeviceController.hpp, SuctionCupController.hpp]
2016-06-28 Optimization of compile time for the rw library. A reduction of 45% has been observed with the GCC compiler. Unused includes has been removed, and forward declarations are used where they will not af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
    [AssemblyControlStrategy.hpp]
2016-06-30 Added test for loading and saving of the GraspTask format, and fixed a couple of fields that were not included in the saving/loading.
2016-06-30 Removed some unnecessary includes from the rwlibs. The main reduction in the compilation of rwlibs is due to revision 5998 (optimization of compilation speed for rw library). Only little reduction in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
2016-07-12 Fixed some issues in Windows related to cleanup.
    [main.cpp]
2016-07-14 Initial fix to issue #10. ODE multi-threading has been broken since ODE 0.13, causing task simulation test to fail. If ODE is built with the correct options, ODE 0.13 and newer will now construct one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
    [ODESimulator.cpp]
2016-07-17 Fixed a couple of cmake errors in RWSim: The order of libraries has been changed such that the circular dependency between rwsim_ode and rwsim will link correctly. When the RobWorkSim package is foun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
2016-07-19 Bug fix for the ThreadTask. One issue was that if setKeepAlive(false) was called simultaneous with a finishing subtask, the subtask would invoke idle while setKeepAlive(false) would invoke done. Now 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
2016-07-19 Updated ThreadTest to reflect previous change.
2016-07-20 Added a couple of includes that are necessary when RobWorkStudio plugins are not linked statically. Also removed annoying printouts at startup of RobWorkStudio (this also reduces dependencies to load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
2016-07-31 Added minimal test for QHull which currently fails on Windows 64 bit. Internal QHull should be updated to at least QHull 2011.1 to support Windows 64 bit (released 17/4-2011).
2016-08-04 Fixed a couple of issues with tests on Ubuntu 16.04 (see issue #19).
2016-08-05 Correct normal direction in qhull when exporting to trimesh
    When transforming a RW QHull into a triangle mesh currently the normal direction of the remaining triangles is not set to the one determined by qhull.
    There exists a "rule" how the normal direction should relate to the individual vertices, therefore just setting the computed normal is not good enough, but rather two of the triangles vertices need to be switched if the direction is 180 deg off.
    Could probably be done more efficient by doing the checks locally. This seemed safer to me. If this is used for time critical things (?) one could make this optional using a flag.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
2016-08-17 Fixed minor issue with uninitialized values in SerialDeviceController.
    [SerialDeviceController.cpp]
2016-09-07 Forgot to include change to CMakeLists in previous commit. Related to issue #24. In the widget for contact velocities, a bug has been fixed in the ordering of columns.
2016-09-08 Fixed some pedantic warnings about extra ';'.
    [AssemblyParameterization.cpp, BeamJointController.cpp, BtSimulator.cpp, DockWelder.cpp, ODEKinematicDevice.cpp]
2016-09-21 Fixed some doxygen issues.
    [AssemblyParameterization.hpp, ODEConstraint.hpp, ODEKinematicDevice.hpp]
2016-09-21 Deterministic ordering of contacts in ContactDetector (see issue #27). Previously, the contact order would change depending on the memory address of Frame objects.
2016-09-21 Fixed a lot of warnings for Windows.
    [BtConstraint.cpp, ODEConstraint.cpp, SerialDeviceController.cpp]
2016-09-21 Fixed error in previous commit.
    [ODEConstraint.cpp]
2016-09-23 Fixed some Windows warnings.
    [BtConstraint.hpp]
2016-09-24 Fixed some documentation in kinematics and math folders.
2016-09-29 Added possibility for customizing the velocity/acceleration limits in setTarget in DynamicSimulator (by Adam). Also added some missing documentation. Added a getClosestPoint method for convex hulls (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
    [BodyController.cpp, BodyController.hpp]
2016-12-12 Added possibility of optional order of min and max when specifying joint limits.
2016-12-20 Addition of Kuka IIWA 7 closed form inverse kinematics solver (issue #31).
2017-01-10 Extension of Kuka inverse kinematics solver to allow solving more deterministically.
2017-01-11 Bug fix for issue where Jacobians become zero when calibration is applied. The relevant JointEncoder mapping now returns 1 instead of 0. The correct mapping is probably a more complex expression, but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
2017-01-12 Bug fix in closed form inverse kinematics solver for Kuka robot.
2017-01-24 Updated UR for Anders Prior to get updates that can be merged in.
    [Client_Interface.xlsx]
2017-01-26 Bug fix in rwsim_simulator-gtest. A segmentation fault occured at the end of the program as EngineTest plugins were unloaded before the destruction of the EngineTest objects by the Google test framew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
2017-02-03 Fixed issue in Windows when shared boost libraries are used. - The BOOST_ALL_DYN_LINK definition is added such that the auto-linking feature knows to link with the shared libraries. - With shared lib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
2017-02-17 Updated CMakeLists.txt to not include the calibration tool which are to be removed
2017-02-17 Removed invalid calibration tests
2017-02-17 Fixed include in CalibrationTest.cpp
2017-02-17 Removed old calibration.hpp
2017-04-11 Added tests for CSV format in the path loading.
    [6dof_no_timestamp.csv, 6dof_timestamp.csv]
2017-04-19 Fix for new interface in Bullet 2.86.
    [BtRWCollisionConfiguration.cpp]
2017-04-24 Fixed RANSAC tests (by Michael).
    [plane_data.csv]
2017-05-03 Fixed wrongful initialization of variables in URCallBackInterface and conversion warnings
    [URCallBackInterface.cpp, URCallBackInterface.hpp, URCommon.hpp, URPrimaryInterface.cpp, UniversalRobotsRTLogging.cpp]
2017-05-24 Added RobWorkStudio icon for Assembly Visualization plugin.
2017-06-12 Updated stuff to enable to simulated camera working on Windows.
2017-06-27 Added two assembly strategies from the CARMEN project to RobWork. One strategy for Peg in Hole, and one for spiral search.
2017-06-27 Added GUI visualization for easy setup of assembly tasks and strategies.
2017-08-11 Added buttons for scaling of frames in RobWorkStudio TreeView (by Michael - see issue #43).
2017-08-22 Test of simulated sensors (by Michael).
2017-11-10 Added four new joint types (Universal, Spherical, PrismaticUniversal and PrismaticSpherical).
2017-11-10 Updated CMakeLists after adding new joint types.
2017-11-10 Fixed bug in revolute joint limits, introduced when adding new joint types in revision 6245.
2017-11-10 Updated LogWriter to be thread safe and added clear method to PropertyMap.
2017-11-13 Fixed error in the recently added JointTest.
2017-12-04 Added models and tests for the Robotiq hand, and the required code changes to make it work: ParallelDevice is now able to handle dependent joints. A joint in one serial chain (scope) can depend on a 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
    [base.stl, finger_wo_cap.stl, inner_link.stl, motor_arm.stl, outer_link.stl]
2017-12-05 Updated ParallelIKSolver with some new features. It is now possible to define multiple targets, and partial constraints where the targets can be given in less than 6 DOF. Also, the solver can solve f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
2017-12-05 Updated the Jog module to support the new features related to ParallelDevices and their inverse kinematics.
2017-12-12 Fixed some issues related to simulated sensors and OpenGL: - Avoid OS exceptions when external framebuffers are not available. - Fix for GLFrameGrabber25D on Windows, where "near" and "far" variables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
2017-12-12 Forgot to commit a couple of files.
2018-01-16 Fixed a couple of memory leaks in UR interface (by Lukas).
    [URCommon.hpp, URPrimaryInterface.cpp]
2018-02-07 Added changes and unit tests for WorkcellSaver based on review
    [Rob-0.stl, Rob-1.stl, Rob-2.stl, Rob-3.stl, Rob-4.stl, Rob-5.stl, Rob-6.stl, floor.stl]
2018-02-12 Added LaTeX amsmath package to Doxygen documentation. This makes it possible to write bracketed vector and matrix expressions.
2018-02-15 Making Xerces an optional dependency, and switching to DOM parsers where Xerces based ones were previously used. Assembly library dependency on Xerces removed, as it is now using the task loader/save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
2018-02-20 Removed some printouts in ThreadSafeQueue.
2018-02-22 Fixed a couple of issues with Lua.
2018-03-01 Updated ClearanceOptimizer to use QConstraint to check device limits, and added functions to add an additional QConstraint and/or StateConstraint (by Lukas).
2018-03-16 Implementation of WorkCellSceneTest and fix for WorkCellScene such that it detects when frames are removed in the WorkCell (by Kasper). Fixed some memory leaks in SceneGraphTest and WorkCellScene.
2018-03-16 Minor fixes by Lukas: constification, and fix of wrong names in RobWorkHardware CMake flags.
    [URCallBackInterface.hpp]
2018-05-24 Removed old threading in UR script, and decreased read packet delay
2018-05-28 Added getTCP function in inverse kinematics solvers (by Lukas).
2018-05-28 Added Copy button to the Jog module (by Lukas).
2018-07-09 Bug fix in CameraModel constructor where ProjectMatrix was not copied, and specified that units are degrees in ProjectionMatrix (by Lukas).
